Saur0o0n/PIDKiln/README.md

# pidkiln
PIDKiln is PID temperature controller, for any task involving high temperatures - like burning ceramic, glass fusing, soft metal melting, burning lost wax casting forms - and probably much more.

## Key features:
- Interface accessible both from LCD screen and WWW Webpage
- Unlimited (limited only by storage) temperature programs number, program file size limited to 10KiB (but this is artificial limit - can be extended)
- Internal ESP SPIFFS storage for programs, data, logs, configuration (perhaps later SD - but I'm not sure yet)
- Local preferences on disk, editable with Web interface
- Online monitoring, program management, editing, graphs and kiln control
- Build in clock synchronised with NTP servers (if Internet connected)
- Safety features build in (temperature run out protection, probe failure, SSR failure, kiln insulation failure)
- Online PIDKiln firmware upgrade with web interface
- Syslog type, over the network (UDP) logging to remote server
- ...simply cool and cheap (comparing to commercially available products) all in one solution

### Sample LCD screens
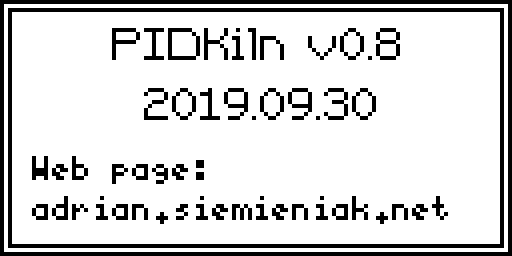
[picture p1: Documentation/images/PIDKiln_LCD_sample2.png]
LCD menu sample

### Sample Web interface window
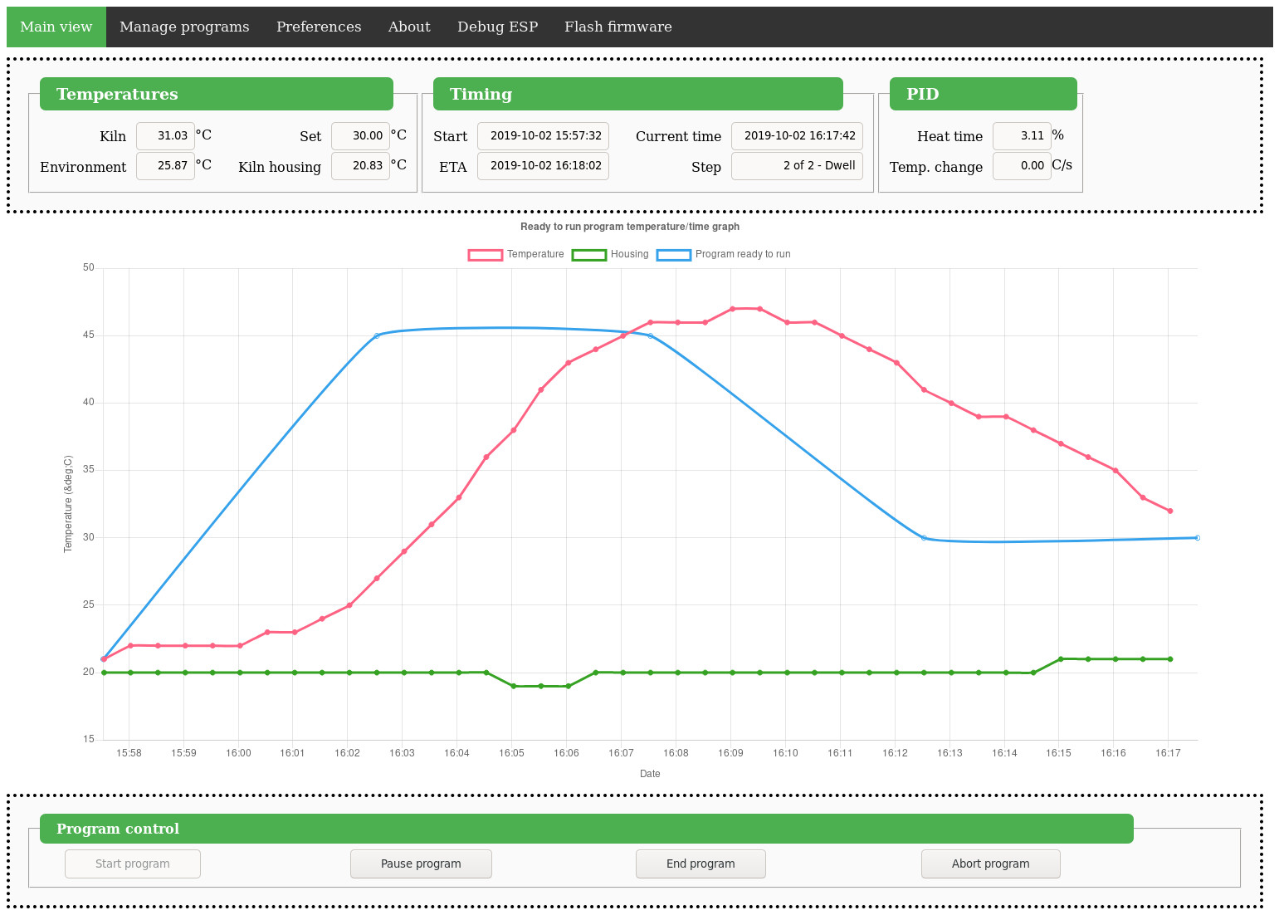
[picture p2: Documentation/images/PIDKiln-web-chart.jpg]
Web interface


## Required components:
- ESP32-Wrover board (I've used TTGO with MicroSD)
- MAX31855 breakout board
- K-type thermocouple
- DC->AC solid state relay

Kind of optional, but recommended:
- 128x65 dot matrix LCD 12864B v2
- Rotary encoder with button

Optional:
- DC/AC secondary relay - like SLA-05VDC-SL-C (240V/30A) mechanical relay
- Additional MAX31855 board with K-type thermocouple for housing temperature measuring
- Coil power meter - 30A/1V. This is contact less power meter that generates small current when energy flows inside it's coil. Mine already had burden resistor - so on output it produces -1V to 1V, proportionally it's coil rated for 30A. We just need to measure it to know how much juice flows to the heater.
- Perhaps a kiln :)

## BOM and expenses

Total expenses for this set should be around 30-40$
- ESP32-Wrover board: 11-14$ if exactly like mine, but other ESP32-Wrover you can bought for 6$+
- MAX31855 board: ~2$
- K-type thermocouple: 1$-10$ - depending on max temperature it can withstand
- LCD 12864B: ~5$
- Encoder: 1$
- SSR: 4$ + 4$ for radiator
- 2x10nF capacitors (at least 10nF - with higher capacitance you will have bigger hysteresis, but this actually may be favorable - for now I use 100nF on both MAX31855)

- Mechanical relay EMR SLA-05VDC-SL-C (Songle): 3$

## Why this configuration?

I've already used "kind of" controller made on Linux server and cron procedures, and it was ok.. for a while. Then I bought cheap Chinese controller PC410, just to find out, it is missing most of required stuff (that original PC410 should have), and I already was accustom to be able to see everything over Internet.
So I've made few attempts with Arduino - it was fine, but since I need remote access - ESP will be much better choice. I've started to work on ESP8266, but being afraid that I will be lacking some GPIOs - I've moved to ESP32. And since price difference is negligible, this is the platform of choice for this project.
It is also beneficial, because it has build in flash memory, that I can use for all required data - without need of connecting additional SD cards. Since I had ESP-Wrover (not ESP32-Wroom), I've also utilised it's PSRAM, but since PIDKiln 1.2 you can also use Wroom module (see Wiki).

MAX31855 comparing to more available MAX6675, is better choice since it allow us to work up to 1350C and it has 3,3V logic.

LC12864B is perhaps not the best choice, but I simply had this one already (I've used if before for my 3D printer). Perhaps later I'll change it. Problem with this LCD is that it has 5V logic. Sometimes it works on 3,3V (depending on version), in my case it does. But since it's one way communication (only MISO) hooking it up to 5V for both logic and back light works and does not crash my board. Clean solution would be to use logic voltage translator (there is plenty of them for 1$).

Relays - Main relay is SSR (Solid State Relay) type. It's because we need to switch it fast and often - SSR can do it, but it will get hot, so make sure you have good radiator. Also if you are going to use cheap Chinese knock offs, make sure it's rated twice the output current of your heater(s).
All relays may fail, and they may fail in closed (conductive) state. Because of it, I've also implemented second stage EMR (Electromechanical Relay) relay in case of SSR failure. It's mechanical, so it won't get hot too much. This will allow to turn off the kiln, in case of SSR failure, with EMR (and other way around too). This additional relay (SLA-05VDC-SL-C) is optional.

Initially for kiln housing temperature readout I wanted to use thermistors, but since I've already had MAX31855 connected (and it costs 2$), using additional one requires only 1 new GPIO on ESP. Without hassle to provide reference voltage etc. Low temperature thermocouples are also darn cheap.

## GPIO/PINs connection

**LCD**

Connected to one of three SPI on ESP32 - called VSPI (MOSI-23, MISO-19, CLK-18, CS-5)

ESP32	| LCD
--------|---------
+3.3V	| BLA (this can be also +5V if you wish)
GND	| BLK
4	| RST
GND	| PSB
+5V	| VCC (This should be - for ESP sake - 3,3V, but my LCD doesn't work with lower voltage. Try first with 3,3V)
GND	| GND
5	| RS
18	| E
23	| R/W

**Encoder**

ESP32	| Encoder
--------|---------
+3.3V	| 5V/VCC
GND	| GND
32	| Key
34	| S2
35	| S1

**MAX31855**

Connected to one of three SPI on ESP32 - called HSPI (MOSI-13, MISO-12, CLK-14) CS-27/15
Add 10nF capacitor to thermocouple input pins - it's a must to have reliable readout.

EPS32	| MAX31855 A
--------|---------
+3.3V	| VCC
GND	| GND
12	| SO/DO (slave output/data output)
14	| SCK (clock)
27	| CS (chip select)

EPS32	| MAX31855 B
--------|---------
+3.3V	| VCC
GND	| GND
12	| SO/DO (slave output/data output)
14	| SCK (clock)
15	| CS (chip select)

**Relays**

ESP32	| SSR
--------|-------
GND	| GND
19**    | IN

ESP32   | EMR (SLA-05VDC-SL-C)
--------|----------------
GND     | GND
21      | IN
5-48V*  | VCC

(*) Do not connect 5V from ESP - use external source. This can be any 5V-48V power supply with around 1W power.

(**) For additional SSR relay (works simultaneously with first one) use PIN 22 - see documentation for explanation

**Power meter**

See the documentation for detailed instruction.

ESP   | 30A/1V
------|--------
3,3V  | 3,3V
GND   | GND
33    | most outside mini jack connector

**Alarm**

This ALARM_PIN goes HIGH when program ABORT is called (somethings wrong, or user triggered). You can connect this pin to buzzer or small relay to trigger some other action on failure.

ESP   | Relay/Buzzer
------|-------------
GND   | GND
26    | +3,3V

**Minimal configuration of PIDKiln**

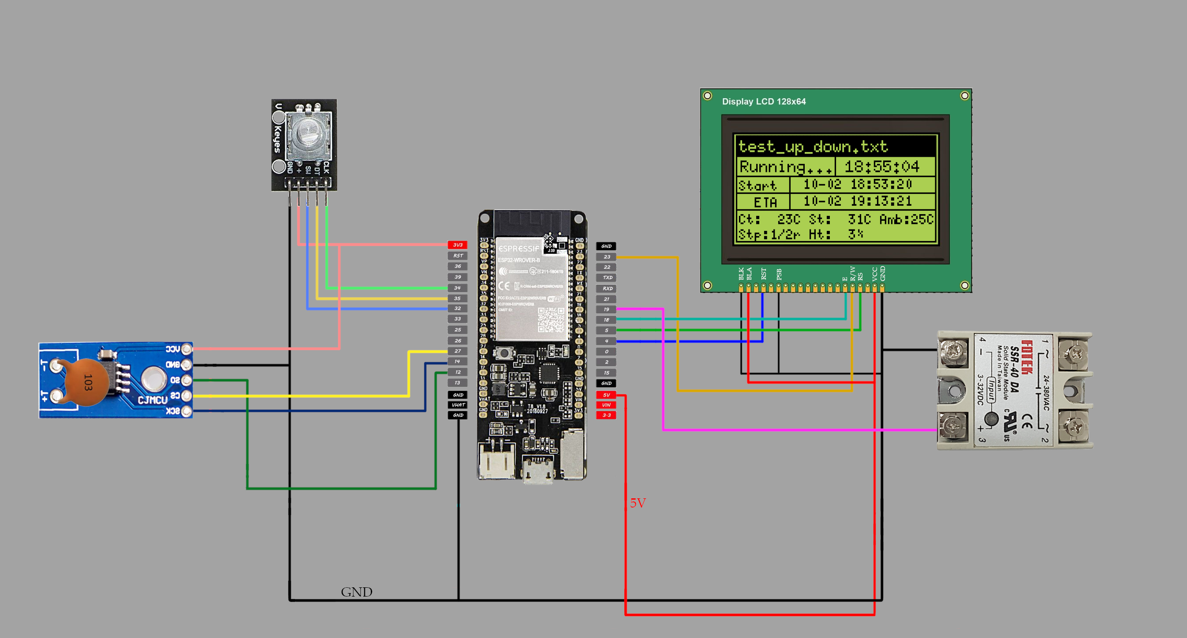
[picture p3: Documentation/PIDKiln_Wiring-min.png]
PIDkiln minimal wiring


**Standard configuration of PIDKiln**

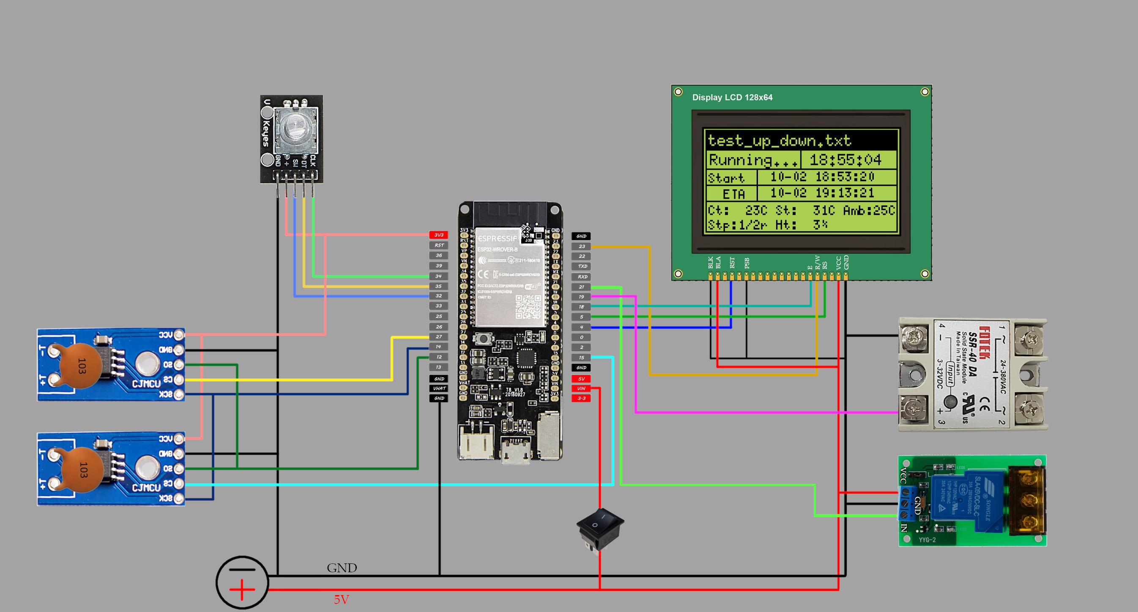
[picture p4: Documentation/PIDKiln_Wiring.png]
PIDkiln wiring


## Power consideration

Preferably you should power your PIDKiln device with regulated 5V. This way you can power ESP32 board through VIN (do not use VIN and USB at once!) pin and use 5V to directly power EMR relay (around 185mA) and LCD backlight (depends of brightness).
You could power board with just USB, but 5V output from my board (ESP32-Wrover TTGO with microsd) is too weak to handle EMR and LCD and most of other boards even do not have 5V out. You could also use VIN as 5V Vout (this pin should be connected directly to USB 5V output) - but then you are limited by USB output and how much board traces can handle.

## Installation

This is short version - for detailed one, please see [Wiki documentation](https://github.com/Saur0o0n/pidkiln/wiki/Hardware-assembly)

- Assembly hardware, as specified above.
- Clone git into the Arduino user programs directory (on Linux "/home/username/Arduino/").
- You have to already have installed ESP32 framework (PIDKiln <v1.2 requires ESP32 <2.0.x, PIDKiln v1.2+ requires ESP32 2.0.x and PIDKiln v1.5+ ESP32 3.x) - if don't, do it now (https://github.com/espressif/arduino-esp32/blob/master/docs/arduino-ide/boards_manager.md).
- Don't forget about ESP32FS plugin (drop it to "/home/username/Arduino/tools")
- Install required additional libraries (not all can be installed from Arduino IDE Library Manager): [ESPAsyncWebServer](https://github.com/me-no-dev/ESPAsyncWebServer), [AsyncTCP](https://github.com/me-no-dev/AsyncTCP), [PID Library](https://github.com/br3ttb/Arduino-PID-Library/), [u8g2](https://github.com/olikraus/u8g2) and perhaps [emon](https://github.com/openenergymonitor/EmonLib) if you plan to use power meter. Since PIDKiln 1.1 you also need [Syslog](https://github.com/arcao/Syslog) library.
- Install also (this has changed in PIDKiln v1.1) [my clone of MAX31855](https://github.com/Saur0o0n/MAX31855) - this implements second HW SPI for ESP32.
- Update (there is no other way to do it) libraries/ESPAsyncWebServer/src/WebResponseImpl.h variable TEMPLATE_PLACEHOLDER to '~'.
- For production use, disable serial debug in PIDKiln.ino - set it on false (''#define DEBUG false'')
- Compile and upload.
- Open data/etc/pidkiln.conf and edit your WiFi credentials (if you want to use) and, if you want, some additional parameters.
- Upload sketch data (from data directory) to ESP32 SPIFFS with help of ESP32FS plugin (in Arduino IDE go to Menu->Tools->ESP32 Sketch Data Upload).

## Documentation

- Most of the documentation you can find on [PIDKiln github page](https://github.com/Saur0o0n/pidkiln/wiki) - so please use it
- Some less formal updates information and step by step instructions will be on [my webpage](https://adrian.siemieniak.net/portal/tag/PIDKiln/)

## Some future ideas

Almost all, what I had in mind is done.. so not much to write here :)
Perhaps...
- RTC clock for better timing and no Internet installations
- MQTT reporting
- HomeAssistant integration
