Saur0o0n/PIDKiln/Documentation/images/Arduino_configuration.jpg

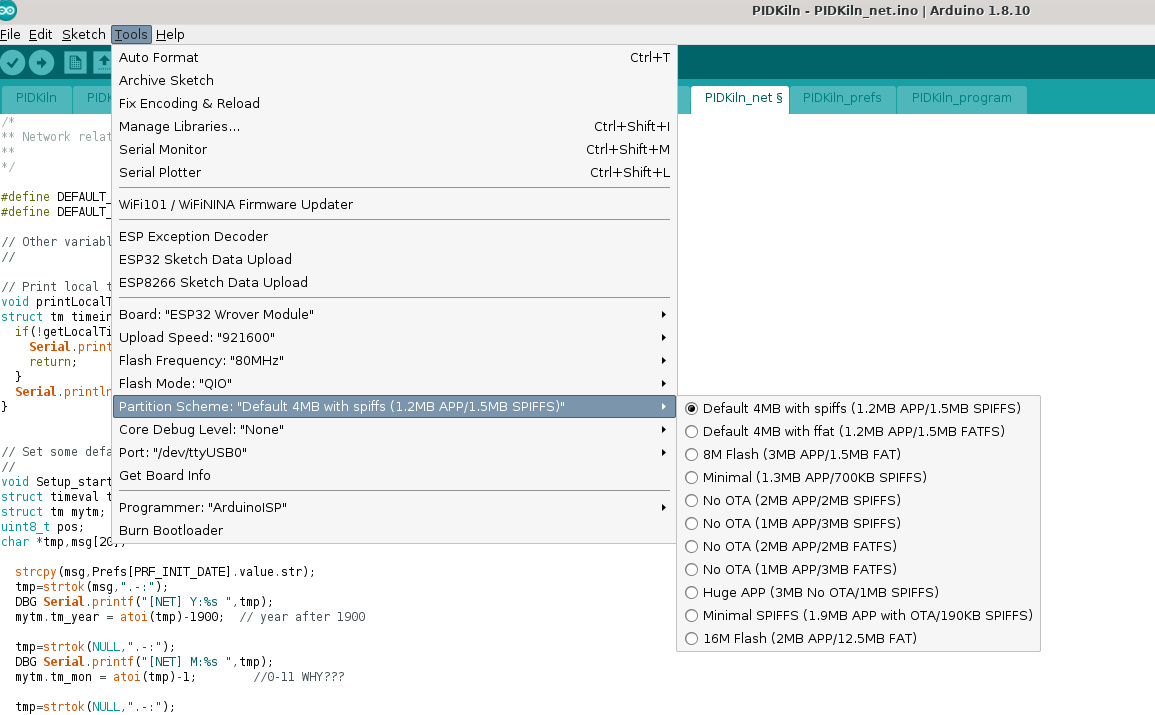
Documentation/images/Arduino_configuration.jpg
