Saur0o0n/PIDKiln/Documentation/images/LCD_sample01.jpg

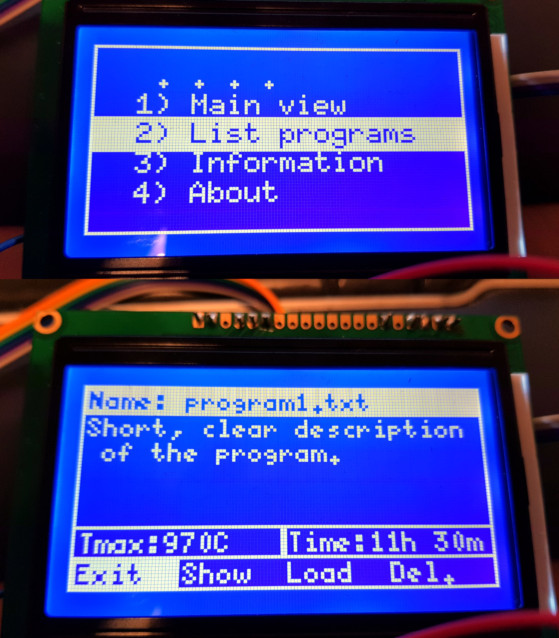
Documentation/images/LCD_sample01.jpg
