Saur0o0n/PIDKiln/Documentation/images/PIDKiln_LCD_MainView1.png

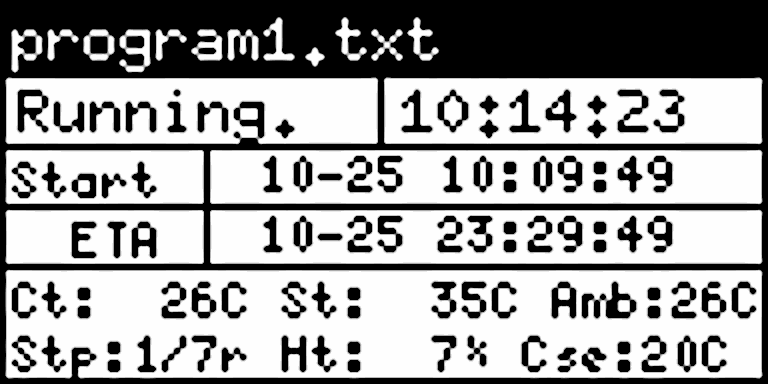
Documentation/images/PIDKiln_LCD_MainView1.png
