Saur0o0n/PIDKiln/Documentation/images/PIDKiln_LCD_sample.png

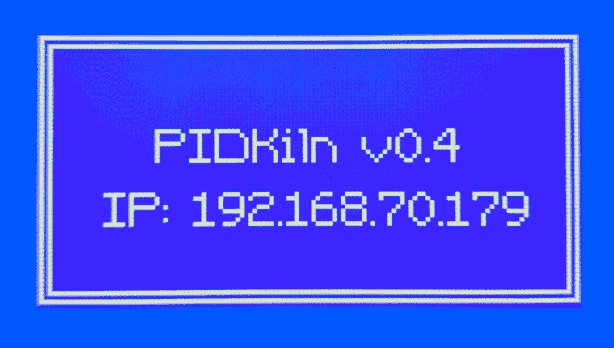
Documentation/images/PIDKiln_LCD_sample.png
