Saur0o0n/PIDKiln/Documentation/images/PIDKiln_on_Breadboard.jpg

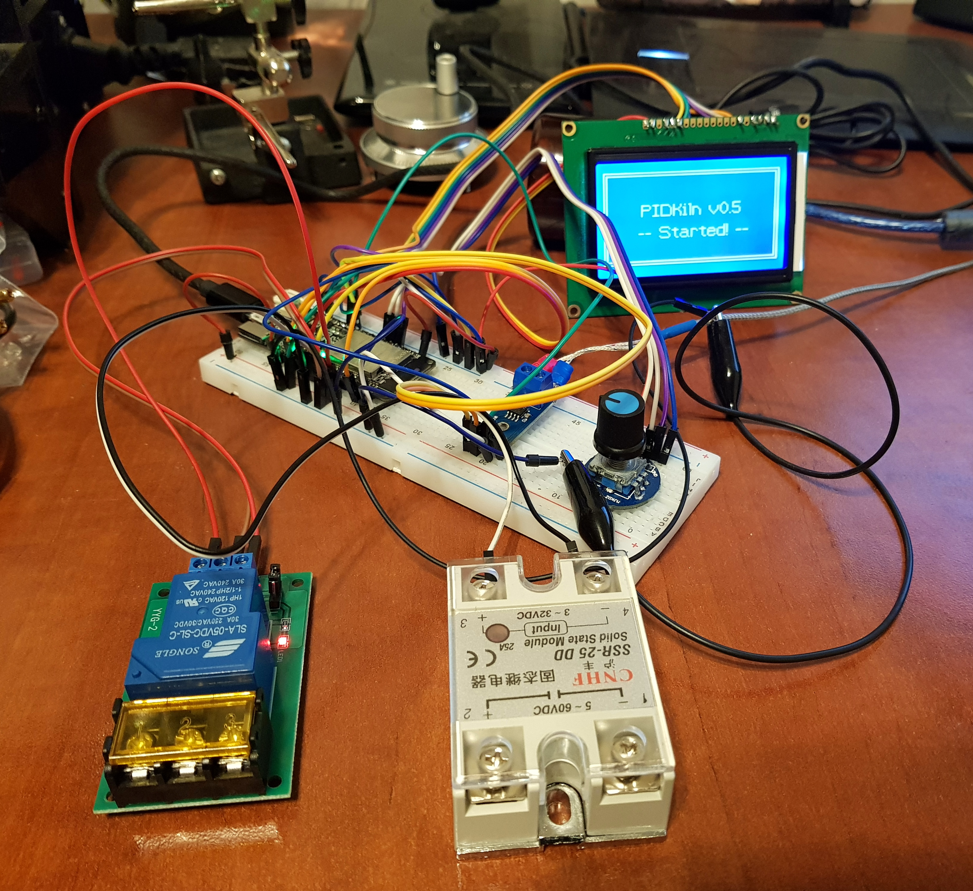
Documentation/images/PIDKiln_on_Breadboard.jpg
