Saur0o0n/PIDKiln/Documentation/images/PowerMeter.png

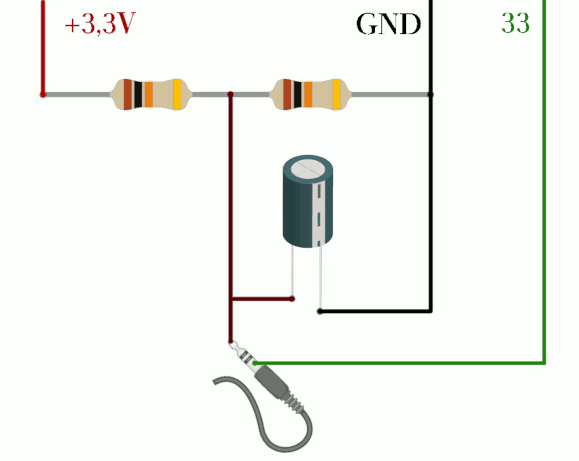
Documentation/images/PowerMeter.png
