Saur0o0n/PIDKiln/Documentation/pid/PIDKiln_pom_1_10,0,0.png

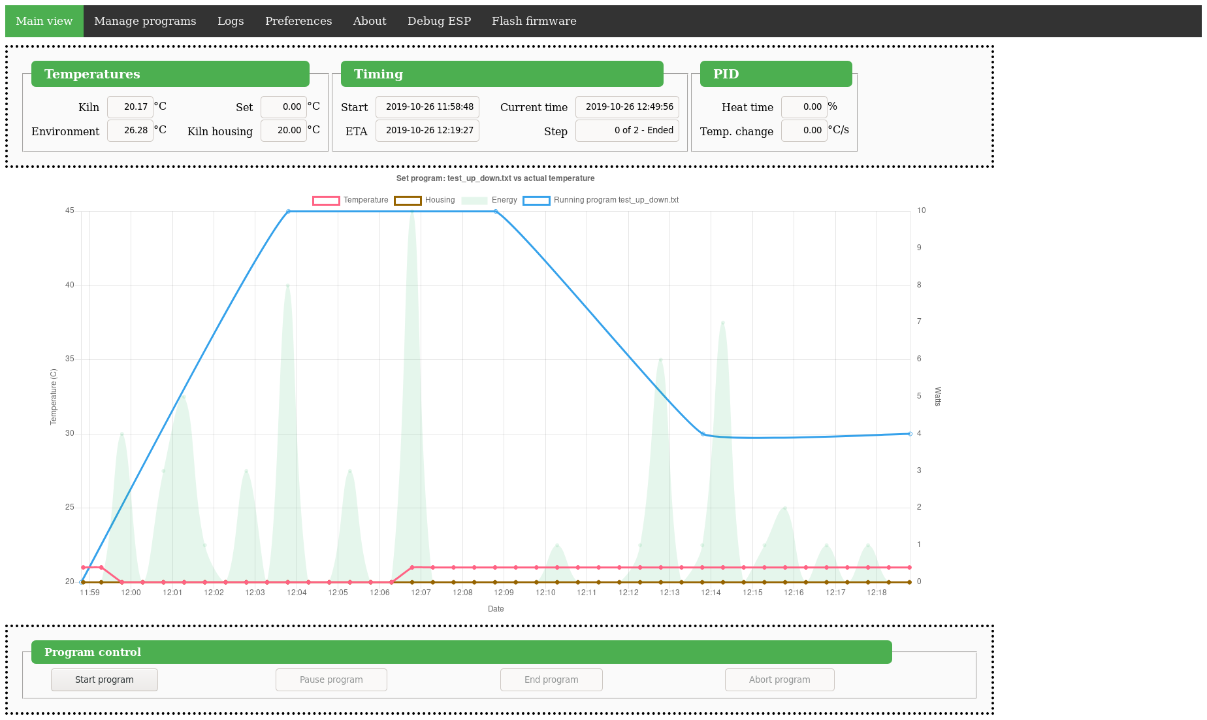
Documentation/pid/PIDKiln_pom_1_10,0,0.png
