Saur0o0n/PIDKiln/Documentation/pid/PIDKiln_pom_1_10,0.2,0.1.png

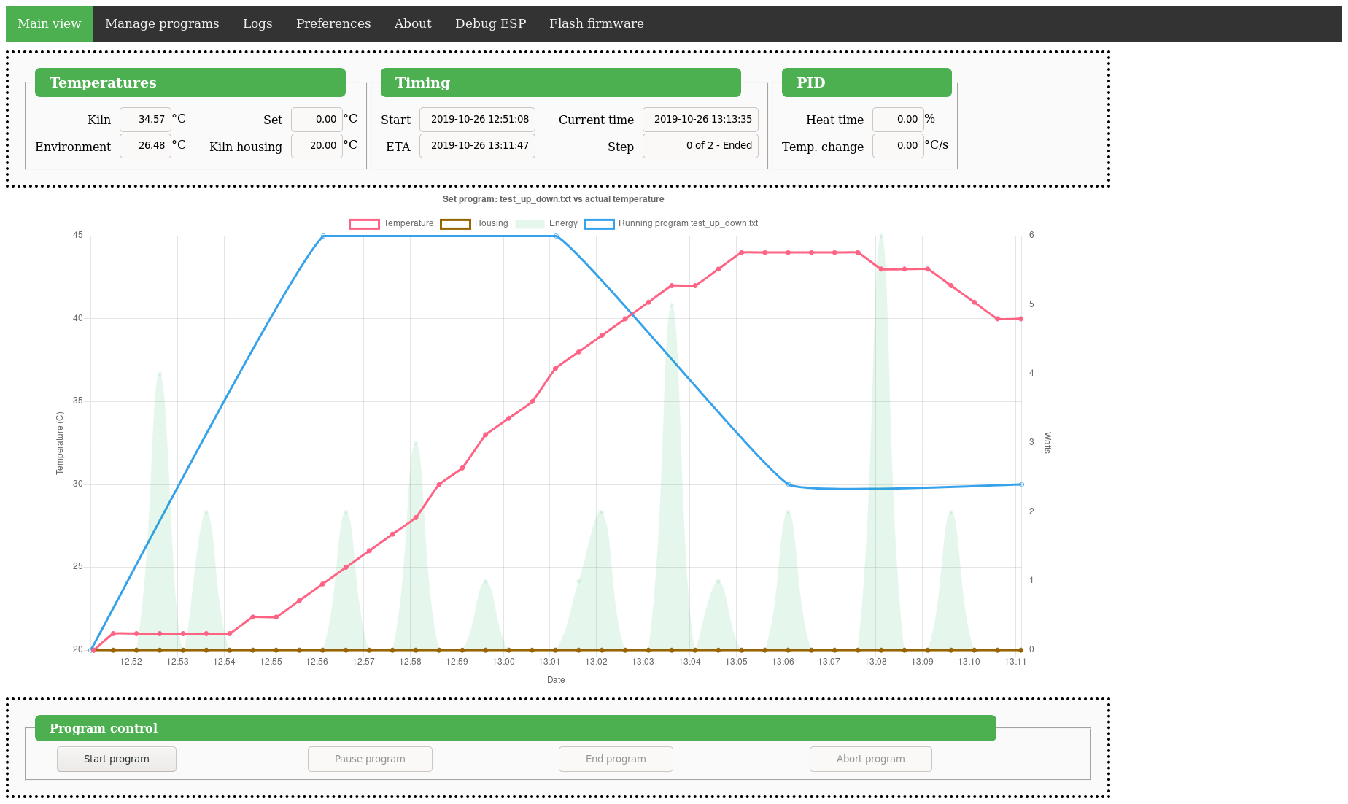
Documentation/pid/PIDKiln_pom_1_10,0.2,0.1.png
