Saur0o0n/PIDKiln/Documentation/pid/PIDKiln_pom_1_10,0.5,0.5.png

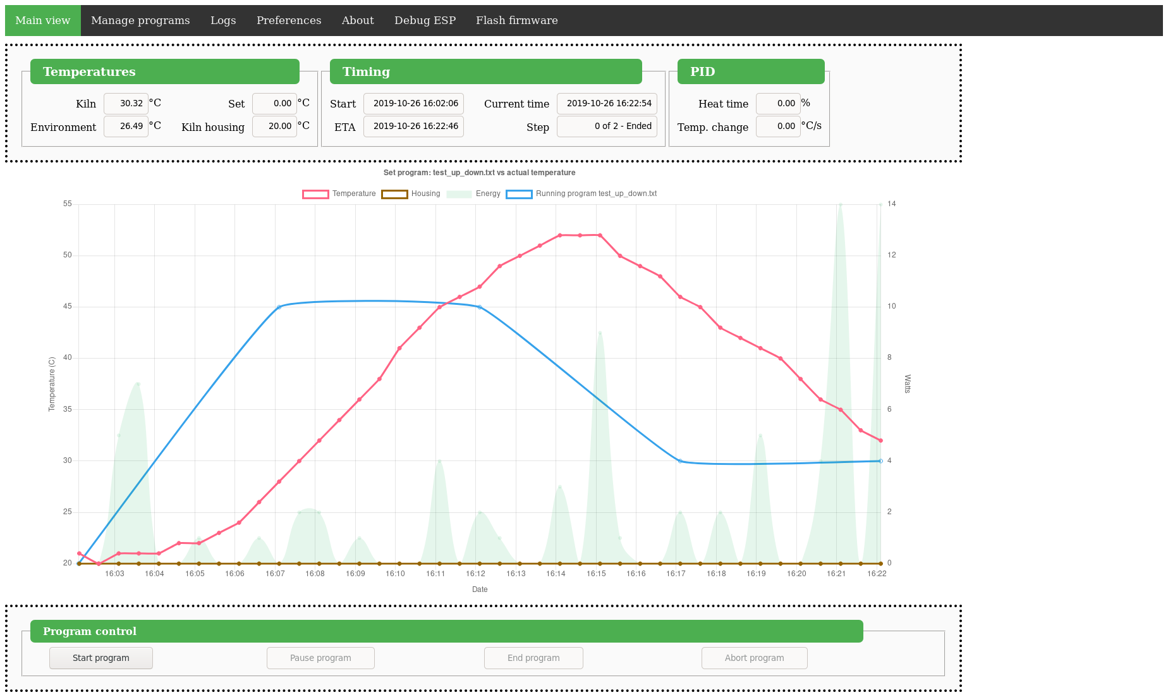
Documentation/pid/PIDKiln_pom_1_10,0.5,0.5.png
