Saur0o0n/PIDKiln/Documentation/pid/PIDKiln_pom_1_20,0.6,0,5.png

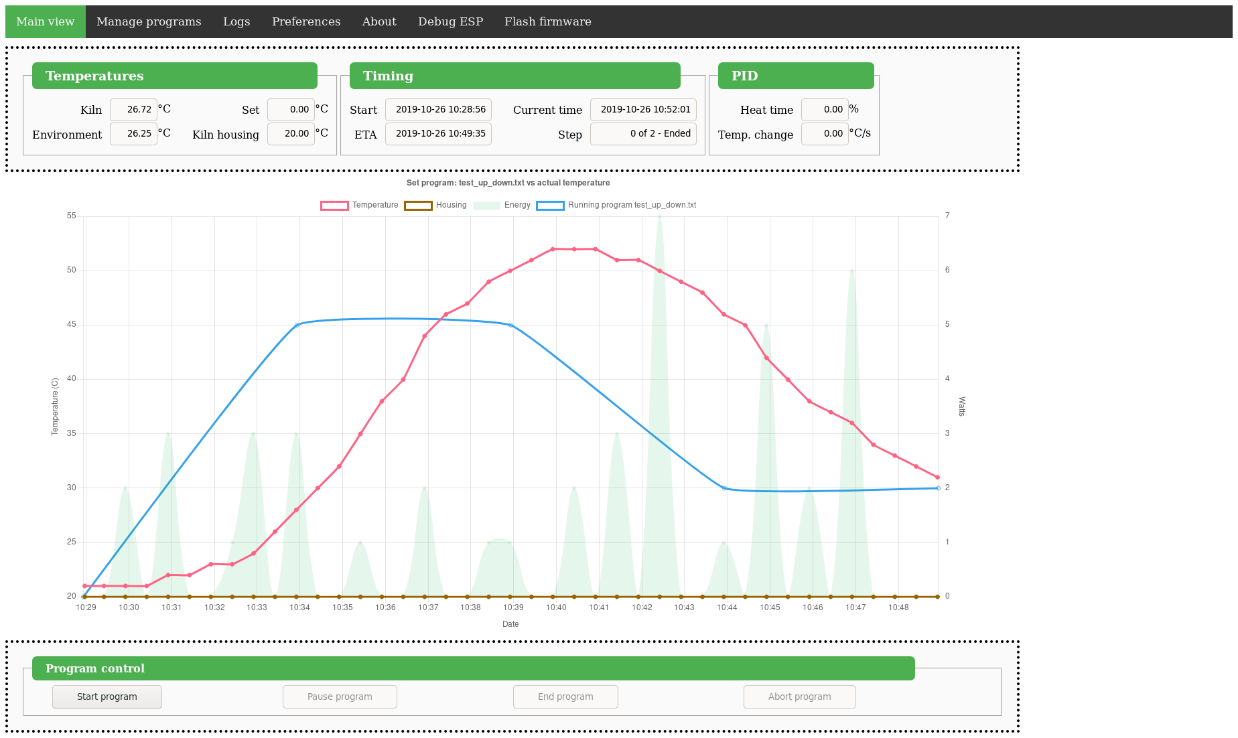
Documentation/pid/PIDKiln_pom_1_20,0.6,0,5.png
