Saur0o0n/PIDKiln/Documentation/pid/PIDKiln_pom_1_20,5,0.1.png

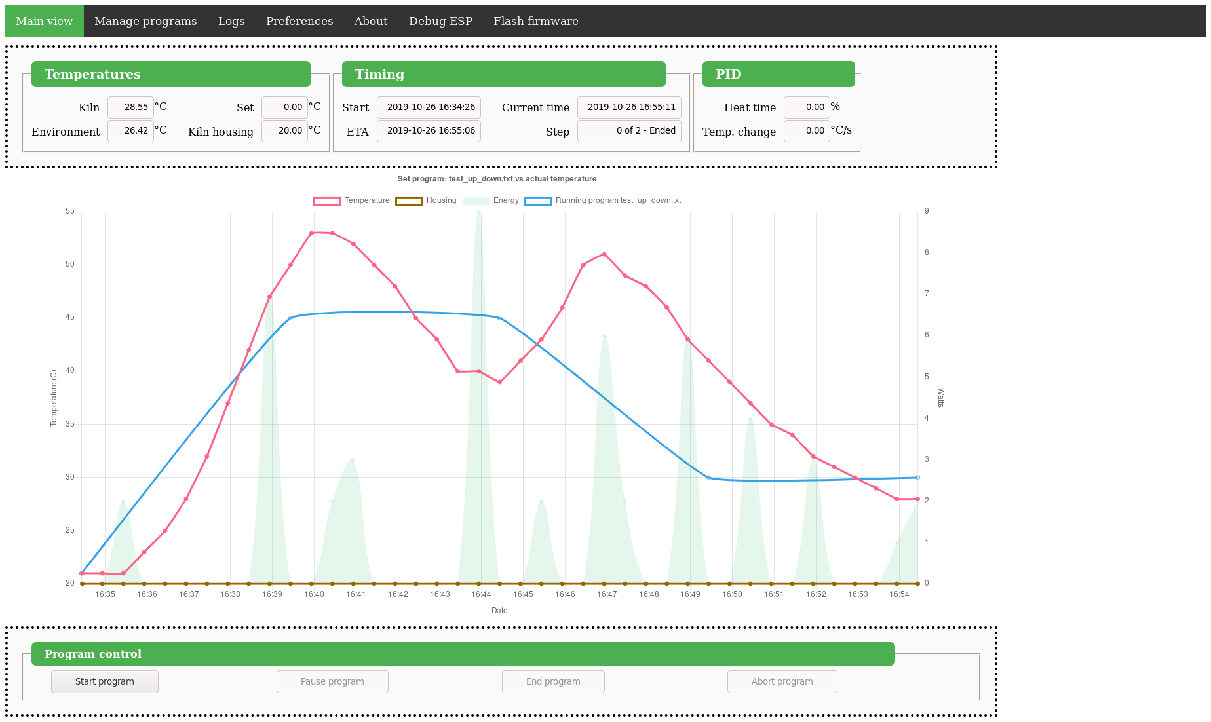
Documentation/pid/PIDKiln_pom_1_20,5,0.1.png
