Saur0o0n/PIDKiln/Documentation/TTGO-ESP32-WROVER-Board1-pinout.jpg

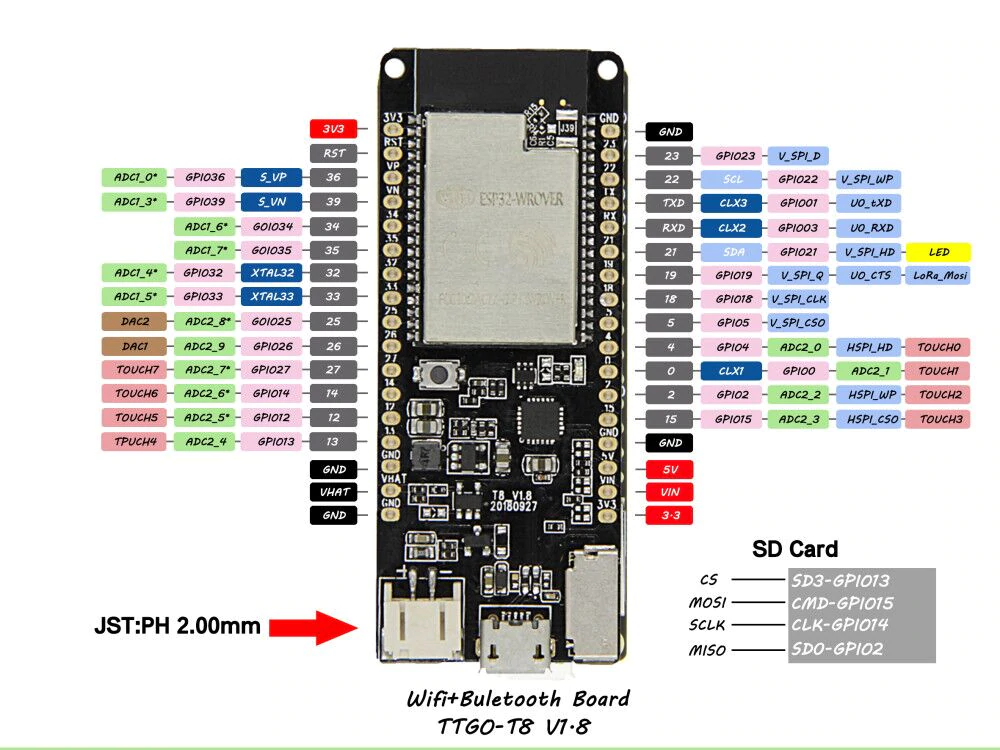
Documentation/TTGO-ESP32-WROVER-Board1-pinout.jpg
