Saur0o0n/PIDKiln/Documentation/components/Current-sensor.jpg

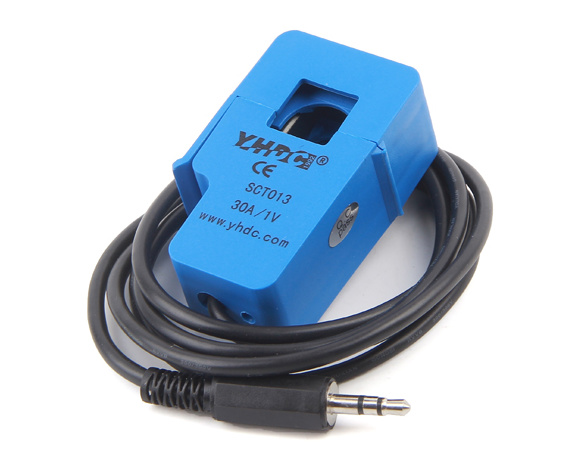
Documentation/components/Current-sensor.jpg
