Saur0o0n/PIDKiln/Documentation/components/LCD_12864b.jpg

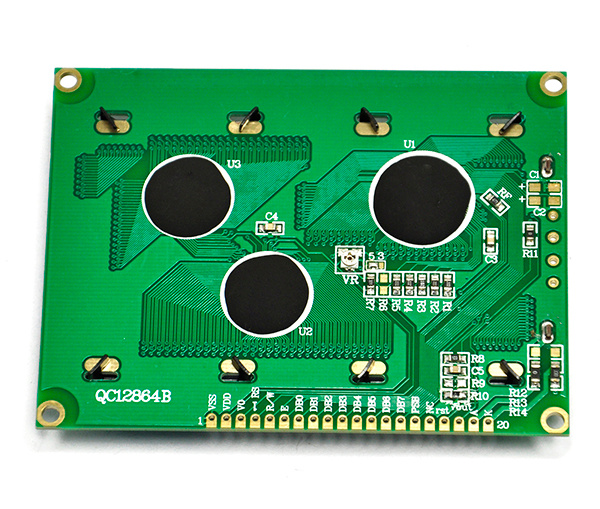
Documentation/components/LCD_12864b.jpg
