Saur0o0n/PIDKiln/Documentation/components/MAX31855.jpg

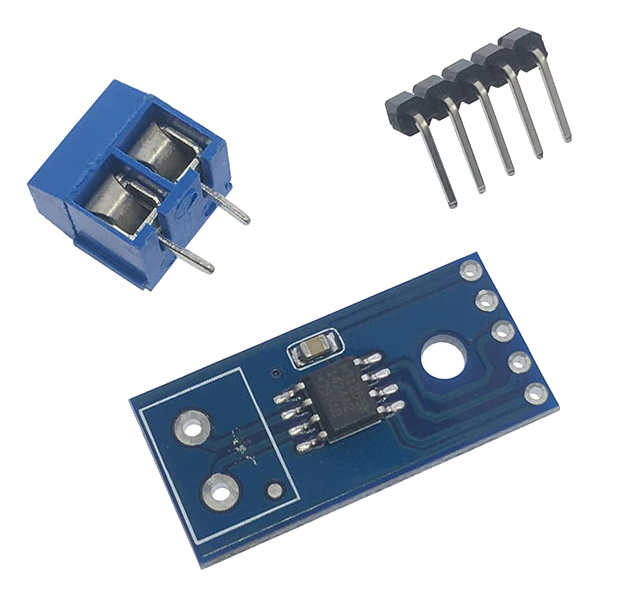
Documentation/components/MAX31855.jpg
