Saur0o0n/PIDKiln/Documentation/components/RotaryEncoder.jpg

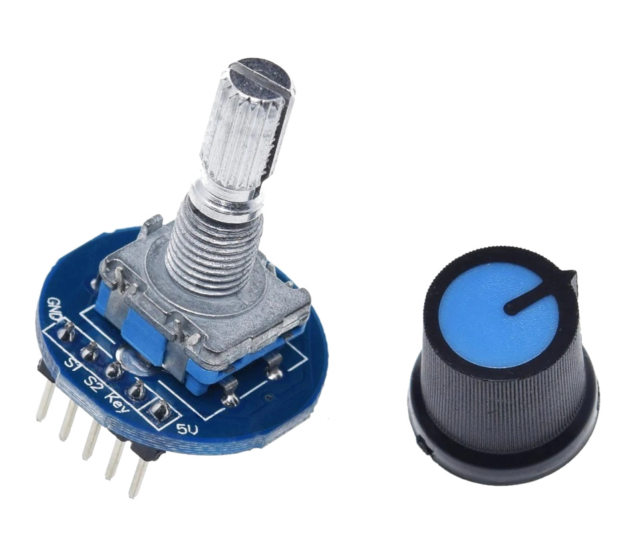
Documentation/components/RotaryEncoder.jpg
