Saur0o0n/PIDKiln/Documentation/components/SLA-05VDC-SL-C.jpg

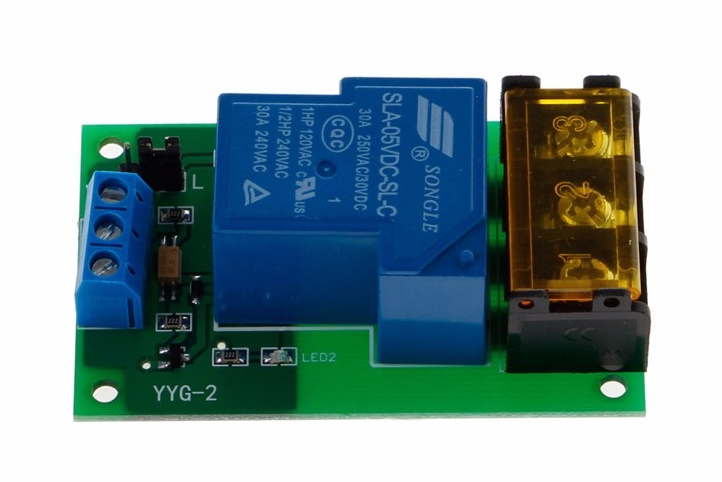
Documentation/components/SLA-05VDC-SL-C.jpg
