Saur0o0n/PIDKiln/Documentation/components/SSR-40a.jpg

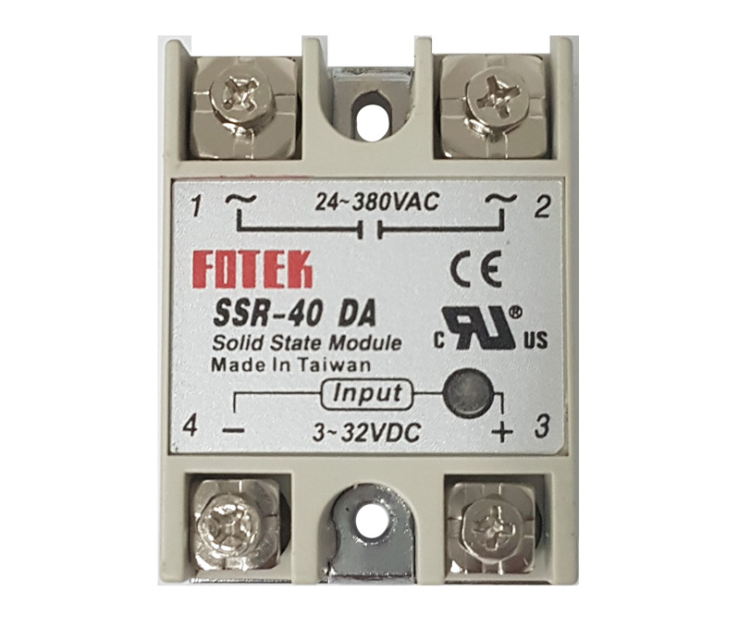
Documentation/components/SSR-40a.jpg
