Saur0o0n/PIDKiln/Documentation/components/TTGO-ESP32-WROVER-Board1.jpg

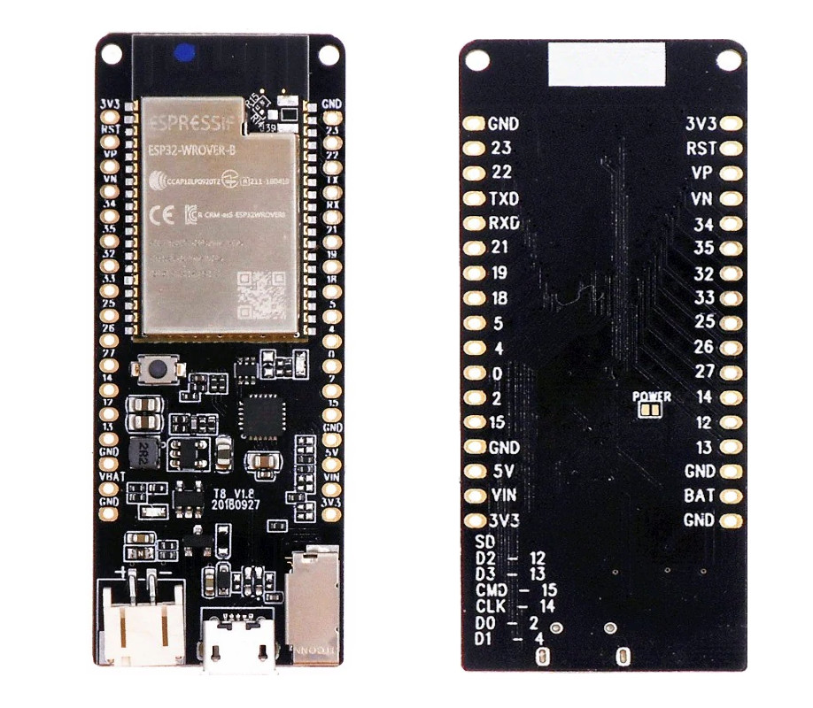
Documentation/components/TTGO-ESP32-WROVER-Board1.jpg
