Saur0o0n/PIDKiln/Documentation/pid/PID_Testing_Results.ods

Lp. | Program | PoM_1_10;0,2;0,1 | PoM_1_10;0;0 | PoM_1_20;0,6;0,1 | PoM_1_20;0,6;0,5 | PoM_10_20;0,2;01 | PoM_1_20;0,2;0,1 | PoM_1_5;0,2;0,1 | PoM_1_10;0.5;0,5 | PoM_1_20;5;0,1 | PoM_1_20;5;2 | PoM_1_20,2,2 | PoM_1_99;10;99
1 | 20 | 20 | 21 | 21 | 21 | 22 | 20 | 22 | 21 | 21 | 25 | 24 | 24
2 |  | 21 | 21 | 21 | 21 | 23 | 19 | 21 | 20 | 21 | 25 | 24 | 24
3 |  | 21 | 20 | 21 | 21 | 23 | 20 | 21 | 21 | 21 | 25 | 24 | 25
4 |  | 21 | 20 | 21 | 21 | 23 | 20 | 21 | 21 | 23 | 26 | 25 | 27
5 |  | 21 | 20 | 22 | 22 | 24 | 21 | 21 | 21 | 25 | 28 | 26 | 30
6 |  | 21 | 20 | 22 | 22 | 25 | 21 | 22 | 22 | 28 | 30 | 27 | 35
7 |  | 21 | 20 | 23 | 23 | 26 | 21 | 22 | 22 | 32 | 34 | 29 | 39
8 |  | 22 | 20 | 24 | 23 | 28 | 21 | 22 | 23 | 37 | 38 | 32 | 43
9 |  | 22 | 20 | 25 | 24 | 30 | 22 | 23 | 24 | 42 | 43 | 35 | 45
10 |  | 23 | 20 | 27 | 26 | 32 | 23 | 24 | 26 | 47 | 47 | 38 | 44
11 | 45 | 24 | 20 | 28 | 28 | 34 | 24 | 24 | 28 | 50 | 50 | 42 | 43
12 |  | 25 | 20 | 31 | 30 | 37 | 24 | 24 | 30 | 53 | 52 | 46 | 42
13 |  | 26 | 20 | 33 | 32 | 39 | 26 | 25 | 32 | 53 | 53 | 49 | 42
14 |  | 27 | 20 | 36 | 35 | 42 | 27 | 26 | 34 | 52 | 52 | 52 | 44
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
