Saur0o0n/PIDKiln/Documentation/images/HalogenBulbTests.jpg

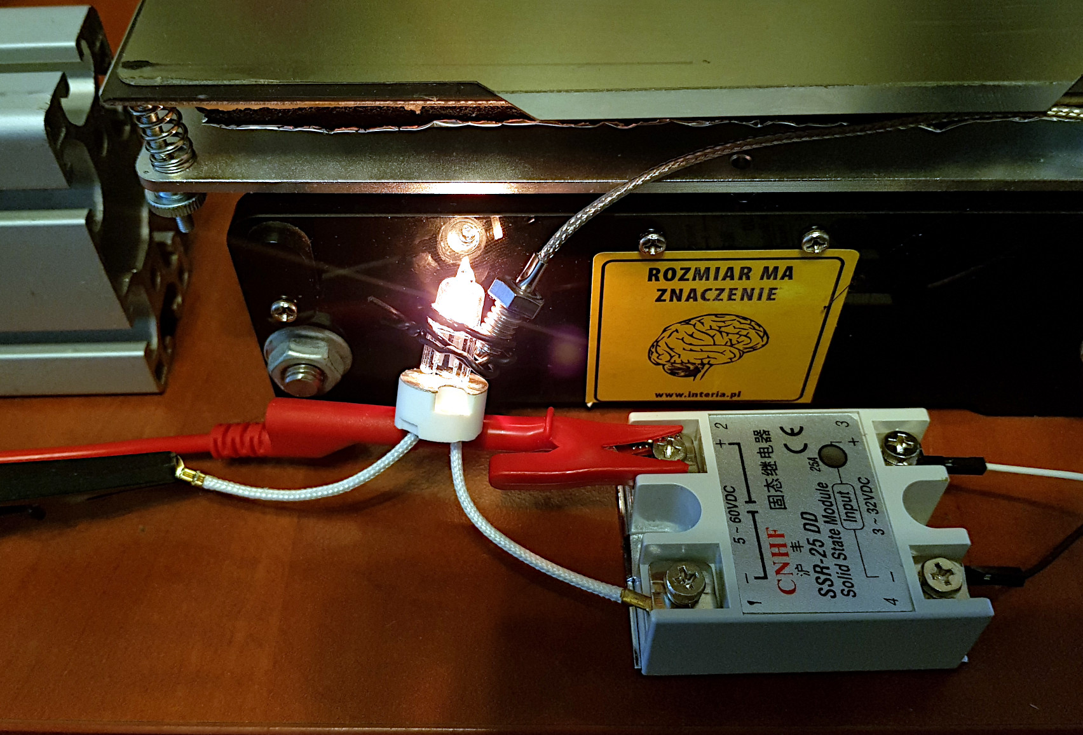
Documentation/images/HalogenBulbTests.jpg
