Saur0o0n/PIDKiln/Documentation/pid/PID_Testing_Results.png

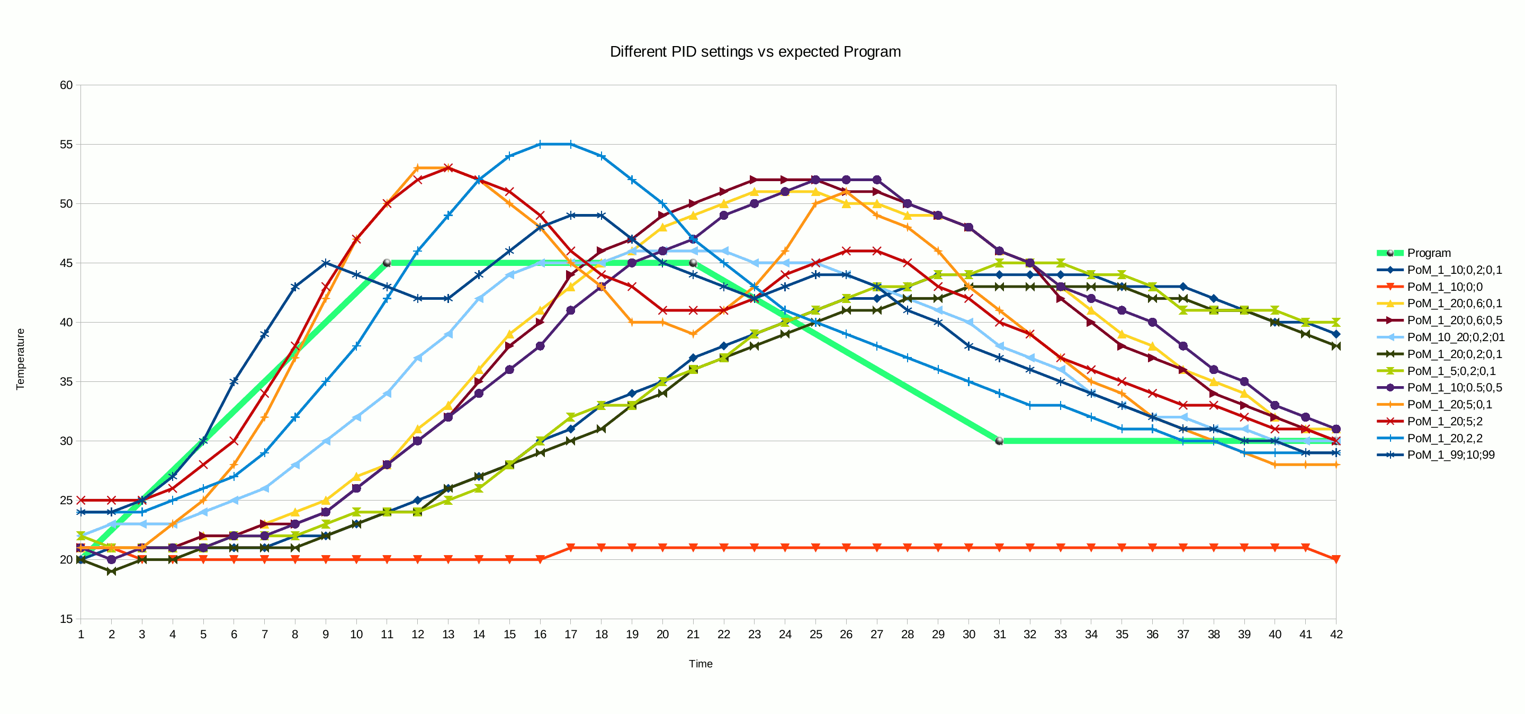
Documentation/pid/PID_Testing_Results.png
