Saur0o0n/PIDKiln/(threads)

Thread 1 (2019-10-18):

LCD and SSR questions

rocketbob, 2019-10-18:
Thanks for putting this nice project up on github!

Question: as I understand the maximum gate current on an IO pin on the ESP32 is 12mA.  Is that enough to drive the SSR?  In my case I have two heating elements in my kiln and will have to drive them from separate pins because I don't think the ESP can source enough current to drive both from one pin.

Saur0o0n, 2019-10-20:
As I understand, fully safe current from IO pin is 12mA, but it can get higher as 50mA - this is just to make this information fully true.
I also have two heating elements, but I control them with single 40A SSR, like you can see it here:
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 - more [here](https://adrian.siemieniak.net/portal/pidkiln-0-9-still-second-update/).
But if you would need two separate SSR - it's going to be extremely easy to do - just let me know.

Saur0o0n, 2019-10-21:
Ok, so I've tested mine SSR and it draws max 8,73mA (at least this is how much my multimeter can measure in MAX mode - I don't know it's frequency). I've looked also at some different specs for Fotek SSRs - and some says MAX 12mA, some says 7mA at 12V, and also I definitely don't have original Fotek :).
So long story short - one SSR is safe, two SSRs well.. should be safe, but better is to:

- drive two(more) heaters with single SSR (if it's in range of SSR specs - for Chinese 2x the specs ;) ).
- add an transistor (like 2N3904) and resistor (330R / 330 Ohm should limit current to 10mA) to drive two(more) SSRs
- use additional GPIO for another SSR (I'll add it)

Saur0o0n, 2019-10-22:
I have another idea - quite easy to implement :). You could use logic level converter module like [this](https://www.aliexpress.com/item/32916020205.html?spm=a2g0s.9042311.0.0.27424c4dfihkjk).
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

This way you can have up to 8 SSRs - driven with single GPIO (with this chip/board). Just connect one side VA to 3,3V and ESP32 pin 19 to all A0-A8 gates. Then on the other side connect +5V to VB and B0-B8 pins to SSRs you have. This chip can (according to specs) provide up to 50mA of current on single pin.

Thread 2 (2020-04-14):

SPI error

Adrian8x, 2020-04-14:
Hi,

Do you have any idea why I get this error?

C:\PIDKiln\PIDKiln_addons.ino: In function 'void Setup_Addons()':

PIDKiln_addons:233:32: error: no matching function for call to 'MAX31855::begin(SPIClass*&)'

   ThermocoupleA.begin(ESP32_SPI);
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

Saur0o0n, 2020-04-14:
Hi,

Did you clone MAX31855 library from my repo? It looks like it's from original branch - without multiple SPI feature.

Adrian8x, 2020-04-14:
Sorry, For the beginning I used original branch. Now I get your library and the sketch is compiled successfully.

Thank you for your help and for this great library!

Adrian8x, 2020-04-14:
23:04:08.828 -> WiFi mode: 1, Retry count: 9, is wifi enabled: 4
23:04:08.874 -> [NET] Y:2020 [NET] M:03 [NET] D:20 [NET] H:11 [NET] m:00 [NET] s:00
23:04:08.968 -> [NET] Creating WiFi Access Point (AP)192.168.4.1
23:04:09.109 -> [PRG] Loading directory...
23:04:09.156 -> [PRG]	counted 6 files
23:04:09.249 -> Guru Meditation Error: Core  1 panic'ed (StoreProhibited). Exception was unhandled.
23:04:09.249 -> Core 1 register dump:
23:04:09.249 -> PC      : 0x400013df  PS      : 0x00060830  A0      : 0x800d97f1  A1      : 0x3ffb1cb0
23:04:09.249 -> A2      : 0x00000000  A3      : 0x3ffb1d56  A4      : 0x000000ff  A5      : 0x0000ff00
23:04:09.249 -> A6      : 0x00ff0000  A7      : 0xff000000  A8      : 0x00000070  A9      : 0x00000069
23:04:09.249 -> A10     : 0x00000000  A11     : 0x00000000  A12     : 0x7840332b  A13     : 0x3ffc2588
23:04:09.249 -> A14     : 0x00000001  A15     : 0x3f4058f3  SAR     : 0x00000008  EXCCAUSE: 0x0000001d
23:04:09.296 -> EXCVADDR: 0x00000000  LBEG    : 0x400014fd  LEND    : 0x4000150d  LCOUNT  : 0xfffffffa
23:04:09.296 ->
23:04:09.296 -> Backtrace: 0x400013df:0x3ffb1cb0 0x400d97ee:0x3ffb1cc0 0x400d9a28:0x3ffb1d90 0x400da2dc:0x3ffb1f60 0x400eaa13:0x3ffb1fb0 0x4008909d:0x3ffb1fd0
23:04:09.296 ->
23:04:09.296 -> Rebooting...
23:04:09.296 -> ets Jun  8 2016 00:22:57
23:04:09.296 ->
23:04:09.296 -> rst:0xc (SW_CPU_RESET),boot:0x13 (SPI_FAST_FLASH_BOOT)
23:04:09.296 -> configsip: 0, SPIWP:0xee

This is the result :((

Saur0o0n, 2020-04-14:
It looks like there is some file indexing error - next step should be like this
```[NET] Y:2020 [NET] M:02 [NET] D:20 [NET] H:11 [NET] m:00 [NET] s:00
[NET] Creating WiFi Access Point (AP)192.168.10.1
[PRG] Loading directory...
[PRG]	counted 7 files
[PRG] FName: program1.txt	 FSize:491	Sel:0
[PRG] FName: vfail1.txt	 FSize:246	Sel:0
[PRG] FName: test_up_down.txt	 FSize:270	Sel:0
```
You can decode this backtrace with Esp Exception Decoder (addon for Arduino IDE).
But I think there is something wrong with file uploaded to SPIFFS.

Adrian8x, 2020-04-14:
I get this message:

PC: 0x400013df
EXCVADDR: 0x00000000

Decoding stack results
0x400d95fe: Load_programs_dir() at C:\PIDKiln/PIDKiln_program.ino line 152
0x400d9838: Generate_INDEX() at C:\PIDKiln/PIDKiln_http.ino line 200
0x400da0ec: setup() at C:\PIDKiln/PIDKiln.ino line 154
0x400ea573: loopTask(void*) at C:\Users\Ellusia\AppData\Local\Arduino15\packages\esp32\hardware\esp32\1.0.4\cores\esp32\main.cpp line 14
0x40088cd1: vPortTaskWrapper at /home/runner/work/esp32-arduino-lib-builder/esp32-arduino-lib-builder/esp-idf/components/freertos/port.c line 143

Adrian8x, 2020-04-14:
I uploaded he sketch with OTA upload tool you provided and I get the same result. This is strange.

I don't understand why I have only 6 files uploaded and you have 7.

Saur0o0n, 2020-04-14:
There are 6 programs, but after first run it will generate index - so it's the seventh file, that you actually can't see as a program (it's html).
It fails on strcpy. Can you upload by OTA both program and spiffs? Perhaps there is something else in file naming on Windows (and file length) - I've been developing it on Linux.
What ESP do you have? It has to be wroover - if it's wroom - there is no psram.

Adrian8x, 2020-04-15:
I uploaded with OTA the Prog/SPIFFS and I have the same error.
I use ESP32-WROOM-32D. That's the problem if you use PSRAM.
There is a possibilities to work with wroom? Otherwise I will buy wrover.

Saur0o0n, 2020-04-15:
You would have to replace all the memory functions from ps_XX to without ps_ - so ps_malloc to just malloc etc. There is only few of them. I'm not sure if this would be all - but it should.
```
PIDKiln_LCD.ino:      Program_run_desc=(char *)ps_malloc((strlen(msg)+1)*sizeof(char));
PIDKiln_LCD.ino:      Program_run_name=(char *)ps_malloc((strlen(msg)+1)*sizeof(char));
PIDKiln_http.ino:          Errors=(char *)ps_realloc(Errors,(strlen(Errors)+p->name().length()+3)*sizeof(char));
PIDKiln_http.ino:  screenshot=(char *)ps_malloc(SCREEN_W*SCREEN_H*2*sizeof(char)+1);
PIDKiln_logs.ino:  Logs_DIR=(DIRECTORY*)ps_malloc(sizeof(DIRECTORY)*count);
PIDKiln_program.ino:  Programs_DIR=(DIRECTORY*)ps_malloc(sizeof(DIRECTORY)*count);
PIDKiln_program.ino:      Program_run=(PROGRAM *)ps_realloc(Program_run,sizeof(PROGRAM)*Program_run_size);
PIDKiln_program.ino:  Program_run=(PROGRAM *)ps_malloc(sizeof(PROGRAM)*Program_size);
PIDKiln_program.ino:  Program_run_desc=(char *)ps_malloc((Program_desc.length()+1)*sizeof(char));
PIDKiln_program.ino:  Program_run_name=(char *)ps_malloc((Program_name.length()+1)*sizeof(char));
```

seesoe, 2020-06-22:
I used the ESP32-WROOM with no PSRAM and had the same issues. I changes all the lines to not have `sp_` and all is working now.

Saur0o0n, 2020-06-22:
Good to know :) I had Wroover, so I've used psram - probably overkill :)

kendrick90, 2020-09-18:
You should post this to the main page because wroom boards are so much more common other users are likely to have those.

Saur0o0n, 2020-09-19:
> You should post this to the main page because wroom boards are so much more common other users are likely to have those.

Well, it's there - many times. In component list, BOM and in configuration description there is even information why Wrover not Wroom.

kendrick90, 2020-09-19:
Is there a reason other than because it's what you had laying around? You
yourself said it's probably overkill to use the psram. I meant you should
add the instructions for how to compile for wroom. So people can get
started with what they have laying around.

On Sat, Sep 19, 2020, 3:50 AM Adrian Siemieniak <notifications@github.com>
wrote:

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

Closed 2021-12-03.

Thread 4 (2020-07-15):

Error log id values

seesoe, 2020-07-15:
Where can I find the values for the error log? I have a program that aborted twice around the same spot and I can't seem to figure out why. The kiln wasn't moved or touched in both cases.

```
Program name: 1.txt
Program desc: Slow bisque at 04
Started at: 2020-07-14 05:05:22
Possible end at: 2020-07-14 10:25:22
PID values. Kp:20.00 Ki:0.20 Kd:0.10
Start temperature: 41.8C
CSV filename: 2020-07-14 10:25:22
-=-=-= Starting program =-=-=-=-
Program ended at: 2020-07-14 08:09:20
End temperature: 690.7C
Used power: 1.8 W/h
Program aborted with error: 5
```
```
Program name: 1.txt
Program desc: Slow bisque at 04
Started at: 2020-07-15 03:52:53
Possible end at: 2020-07-15 09:12:53
PID values. Kp:20.00 Ki:0.20 Kd:0.10
Start temperature: 68.5C
CSV filename: 2020-07-15 09:12:53
-=-=-= Starting program =-=-=-=-
Program ended at: 2020-07-15 06:24:43
End temperature: 601.6C
Used power: 1.8 W/h
Program aborted with error: 5
```

Saur0o0n, 2020-07-15:
In PIDKiln.h you have specified all errors (counting start with 0)
```/*
**  Program errors:
*/
typedef enum {
  PR_ERR_FILE_LOAD,       // failed to load file
  PR_ERR_TOO_LONG_LINE,   // program line too long (there is error probably in the line - it should be max. 1111:1111:1111 - so 14 chars, if there where more PIDKiln will throw error without checking why
  PR_ERR_BAD_CHAR,        // not allowed character in program (only allowed characters are numbers and separator ":")
  PR_ERR_TOO_HOT,         // exceeded max temperature defined in MAX_Temp
  PR_ERR_TOO_COLD,        // temperature redout below MIN_Temp
  PR_ERR_MAX31A_INT_ERR,   // failed to read MAX31855 internal temperature on kiln
  PR_ERR_MAX31A_KPROBE,    // failed to read K-probe temperature on kiln
  PR_ERR_MAX31B_INT_ERR,   // failed to read MAX31855 internal temperature on case
  PR_ERR_MAX31B_KPROBE,    // failed to read K-probe temperature on case
  PR_ERR_USER_ABORT,      // user aborted
  PR_ERR_end
} PROGRAM_ERROR_STATE;
```

So error 5 is going to be "PR_ERR_MAX31A_INT_ERR,   // failed to read MAX31855 internal temperature on kiln" - this is not exact error description, since I've changed MAX library (this is for previous one - if we are using PIDKiln 1.1). The exact error you will find in Serial debug or Syslog. This should be one of those:
```
    switch (ThermocoupleA.detectThermocouple())
    {
      case MAX31855_THERMOCOUPLE_SHORT_TO_VCC:
        DBG dbgLog(LOG_ERR,"[ADDONS] ThermocoupleA short to VCC\n");
        break;
      case MAX31855_THERMOCOUPLE_SHORT_TO_GND:
        DBG dbgLog(LOG_ERR,"[ADDONS] ThermocoupleA short to GND\n");
        break;
      case MAX31855_THERMOCOUPLE_NOT_CONNECTED:
        DBG dbgLog(LOG_ERR,"[ADDONS] ThermocoupleA not connected\n");
        break;
      default:
        DBG dbgLog(LOG_ERR,"[ADDONS] ThermocoupleA unknown error, check spi cable\n");
        break;
    }
```

seesoe, 2020-07-15:
Hmm, I tried to setup syslog but I couldn’t get my server to read anything.
I checked udp traffic on the server and I see the esp sending the data to
the server but the syslog server wasn’t able to see it and or parse the
data. What could cause this error to happen twice after a similar extended
period of time each run?

On Wed, Jul 15, 2020 at 1:23 AM Adrian Siemieniak <notifications@github.com>
wrote:

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

Saur0o0n, 2020-07-15:
The most probable cause are some kind of interferences - check if thermocouple cable shield is grounded, check if there is no power starving for ESP32 (I had such a case - everything was working, but thermocouple failed at some point in time - it was because power supply was too weak when used longer).

seesoe, 2020-07-16:
I changed around the mains input to be much further away from the circuits and grounded the thermocouple shielding. Still getting error 5. The 5v power supply is 2 amp. I wrote a more simple program to try and test things out faster `700:20:0` and keep getting error 5 around 580-680. I'll have to borrow a laptop to connect the usb cable for serial monitor since syslog isn't broadcasting for some reason.

seesoe, 2020-07-17:
Heres the serial output I managed to get.

```
21:59:19.605 -> [LOG] Writing to log file:2020-07-17 07:55:58,663,44,142
21:59:19.605 -> [PRG] Curr temp: 663, Set_temp: 669, Incr: 0.05 Pid_out:2419.21 Step: 8
21:59:19.605 -> [ADDONS] Temperature sensor A readout: Internal temp = 34.7 	 Last temp = 664.0 	 Average kiln temp = 663.1
21:59:19.605 -> [ADDONS] Temperature sensor A readout: Internal temp = 34.8 	 Last temp = 663.8 	 Average kiln temp = 663.2
21:59:19.605 -> [ADDONS] VCC is set:3300 ; RAW Power: 20666.9W, Raw current: 89.86A, Power global:21110 W/h:44582.084419
21:59:19.605 -> [ADDONS] Temperature sensor A readout: Internal temp = 34.8 	 Last temp = 663.5 	 Average kiln temp = 663.2
21:59:19.605 -> [ADDONS] Temperature sensor A readout: Internal temp = 34.8 	 Last temp = 663.0 	 Average kiln temp = 663.2
21:59:19.605 -> [ADDONS] VCC is set:3300 ; RAW Power: 9507.0W, Raw current: 41.33A, Power global:14632 W/h:44593.496816
21:59:19.605 -> [ADDONS] ThermocoupleA unknown error, check spi cable
21:59:19.605 -> [PRG] Aborting program with error: 5
21:59:19.605 -> [PRG] Ending program cleanly
21:59:19.605 -> [LOG] Cleaning logs...
```

Saur0o0n, 2020-07-17:
```
21:59:19.605 -> [ADDONS] VCC is set:3300 ; RAW Power: 9507.0W, Raw current: 41.33A, Power global:14632 W/h:44593.496816
21:59:19.605 -> [ADDONS] ThermocoupleA unknown error, check spi cable
```
Nothing meaningful there - so ESP lost connection to MAX31855.
Do you have power meter - because those power values looks a way off - 40A ???

Anyway - what is your setup then? Do you have capacitor for thermocouples connected? Have you tried to change MAX31855 (or switch kiln with case MAX for example).
I had also quite a lot of problems with MAX31855 sensors, but most of the problems solved capacitor on Kprobe and good power supply. Also not a bad idea is to ground shielded wire from thermocouple.

seesoe, 2020-07-17:
I tried switching around the max boards with no luck. Hmmm ya the values seem to be more than double, perhaps EMI as well?

The element is 3840 watt, 16 amp, 240v kanthal.

Here's a picture of my box, it got a little messy trying to figure this issue out. I have the thermocouple shielding single point connected to ac earth. I noticed my lcd mounting was earth grounding the dc circuitry's ground, so I just unmounted that for a test running now.

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

Saur0o0n, 2020-07-17:
The setup looks nice. Are you sure that thermocouple is not simply broken and at some point, with certain temperature (because of thermal expansion) it's not close to ground? I know, that this should be reported by MAX31855 IC - but I haven't tested if all those error reports are accurate - as MAX library says.

seesoe, 2020-07-17:
This is the probe I'm using, it simply pokes through the firebrick, no metal or chassis around it.
https://www.theceramicshop.com/product/28923/type-k-thermocouple-81-4/
https://www.theceramicshop.com/product/6629/thermocouple-mounting-block/

I'll have to inspect the tip later today when it cools down. I don't recall measuring any continuity between the terminals and ground but I will do a sanity check.

seesoe, 2020-07-17:
Probe tip looks ok. Didn't detect any lead wire to ground continuity.

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

Saur0o0n, 2020-07-18:
I'll ask again - I don't see it on picture, and you haven't answered previous question - to you have installed capacitor at the thermocouple connector, close to MAX board?

seesoe, 2020-07-20:
For some reason I assumed (bad) that the cap under the terminal blocks would be enough. I just added a 103 capacitor on both boards but still no luck same thing is happening. I also Installed a brand new thermocouple and yet, same thing is happening.

seesoe, 2020-07-20:
I was digging through the code and realized my power sensor was a 100amp/50ma version. I have the 30anp/1v version being delivered on Tuesday.

Also I flashed a second esp32 with thermocouple b and power sensing disabled and disconnected them from the circuit in hopes to eliminate any possible noise, however I still had no luck, same issue.

Saur0o0n, 2020-07-20:
So to summarize - this happens every time at the same time or temperature? (to find out what could trigger the problem) If you don't know - please create program that will be longer then failing one, but not reaches problematic temperature. And vice versa - shorter program that reaches quicker problematic temperature.
At this point I have not other idea what could be wrong. There is a topic about fake MAX31855 boards (https://forum.arduino.cc/index.php?topic=526439.0) - I'm not saying that this is the case here - but just something to consider. If you do the test with temperature/time - perhaps this will shade some light.

seesoe, 2020-07-20:
I have a 20 minute program that if I run at cold start will successfully pass 580c, however if I run it a 3rd time, it starts to error. Also if I run a typical ￼bisque profile and the kiln is heat soaked, then it will trigger at 580 c which is about 2-3 hours into the program.

I will check my chip markings and report back.

I found this interesting comment. He ￼would get error only at high temps like me so he increased sample rate per read.

https://github.com/jbruce12000/kiln-controller/issues/5#issuecomment-502414536

seesoe, 2020-07-20:
I presume it would be putting this in a loop and only only if all iterations fail, then abort?

https://github.com/Saur0o0n/PIDKiln/blob/master/PIDKiln_addons.ino#L84

Saur0o0n, 2020-07-20:
The difference is, that with raspberry example, errors where shorted to gnd/vcc - here is unknow error (except shorted to gnd/vcc). To be honest, after MAX library change I haven't check if those errors are reported correctly.
I don't believe this could be the problem (and I haven't mentioned it before) - but at this point - your thermocoupole A cable has a loop and it's located directly at relay switch with electromagnet inside, this is probably not the best solution anyway :)

Saur0o0n, 2020-07-20:
> I presume it would be putting this in a loop and only only if all iterations fail, then abort?
>
> https://github.com/Saur0o0n/PIDKiln/blob/master/PIDKiln_addons.ino#L84

Yes, you can do the loop/while there if you wish. But that's kind of "ugly" solution.

seesoe, 2020-07-20:
Agreed, I'll see if it can at least work or if the emi is too high I guess I'll just pull it all out as a test and then redo the whole box idea.

I also found this 13th post where he suggested heavier filtering on the input voltage as well.
https://forums.adafruit.com/viewtopic.php?f=19&t=84826#wrap

seesoe, 2020-07-20:
I was able to get syslog working on a different server and I also added the 5 detect checks.

I ran `700:20:0` at cold start and the program finished successfully twice (expected) then the 3rd time, it aborted about 10 min in. The logs showed in one instance short to grd and then 4 unknown errors. and another couple instances 5 unknown errors. After the program ended the logs reported 5 unknown errors (instead of short to grd) after about 3-5 temperature reads.

Couple examples of abort and reads after.
```
1 - PIDKiln-ESP32 PIDKiln - - - ???[LCD] Graph. mxx:126 mxy:59 ttime:15 mxtemp:700 scx:840 scy:8
1 - PIDKiln-ESP32 PIDKiln - - - ???[LCD] Redrawing box on graph width:73.36 fullt:900 currt:524 prop:0.582222
1 - PIDKiln-ESP32 PIDKiln - - - ???[PRG] Pid_out RAW:3758.02 Pid_out:3758.02 Now-window:3873 WindowSize:5000 Prg_state:2
1 - PIDKiln-ESP32 PIDKiln - - - ???[ADDONS] ThermocoupleA unknown error, check spi cable
1 - PIDKiln-ESP32 PIDKiln - - - ???[ADDONS] ThermocoupleA unknown error, check spi cable
1 - PIDKiln-ESP32 PIDKiln - - - ???[ADDONS] ThermocoupleA unknown error, check spi cable
1 - PIDKiln-ESP32 PIDKiln - - - ???[ADDONS] ThermocoupleA unknown error, check spi cable
1 - PIDKiln-ESP32 PIDKiln - - - ???[ADDONS] ThermocoupleA unknown error, check spi cable
1 - PIDKiln-ESP32 PIDKiln - - - ???[PRG] Aborting program with error: 5
1 - PIDKiln-ESP32 PIDKiln - - - ???[PRG] Ending program cleanly
1 - PIDKiln-ESP32 PIDKiln - - - ???[LOG] Loading dir: Loading directory...
1 - PIDKiln-ESP32 PIDKiln - - - ???[INPUT] Button pressed 0.150000 seconds
1 - PIDKiln-ESP32 PIDKiln - - - ??? Short press. Current view 0
1 - PIDKiln-ESP32 PIDKiln - - - ???[LCD] Entering menu (6) display: 7) About
1 - PIDKiln-ESP32 PIDKiln - - - ???[LCD] In menu we can print 5 lines, with 2px space, and char height 10
1 - PIDKiln-ESP32 PIDKiln - - - ???[LCD] Start pos is 4, chosen position is 6, screen center is 2
1 - PIDKiln-ESP32 PIDKiln - - - ???[LCD] x0: 0, y0: 24, w: 128, h: 12
1 - PIDKiln-ESP32 PIDKiln - - - ???[LOG] Loading dir:	counted 13 files
1 - PIDKiln-ESP32 PIDKiln - - - ???[LOG] FName: 200720_084119.csv	 FSize:892	Sel:0
1 - PIDKiln-ESP32 PIDKiln - - - ???[LOG] FName: 200720_084119.log	 FSize:313	Sel:0
1 - PIDKiln-ESP32 PIDKiln - - - ???[LOG] FName: 200720_085707.csv	 FSize:472	Sel:0
1 - PIDKiln-ESP32 PIDKiln - - - ???[LOG] FName: 200720_085707.log	 FSize:343	Sel:0
1 - PIDKiln-ESP32 PIDKiln - - - ???[LOG] FName: 200720_135759.csv	 FSize:892	Sel:0
1 - PIDKiln-ESP32 PIDKiln - - - ???[LOG] FName: 200720_135759.log	 FSize:313	Sel:0
1 - PIDKiln-ESP32 PIDKiln - - - ???[LOG] FName: 200720_141541.csv	 FSize:892	Sel:0
1 - PIDKiln-ESP32 PIDKiln - - - ???[LOG] FName: 200720_141541.log	 FSize:313	Sel:0
1 - PIDKiln-ESP32 PIDKiln - - - ???[LOG] FName: 200720_143158.csv	 FSize:304	Sel:0
1 - PIDKiln-ESP32 PIDKiln - - - ???[LOG] FName: 200720_143158.log	 FSize:343	Sel:0
1 - PIDKiln-ESP32 PIDKiln - - - ???[LOG] FName: 200720_143812.csv	 FSize:528	Sel:0
1 - PIDKiln-ESP32 PIDKiln - - - ???[LOG] FName: 200720_143812.log	 FSize:343	Sel:0
1 - PIDKiln-ESP32 PIDKiln - - - ???[INPUT] Rotate, SCR_MENU: Encoder turn: 1, Sizeof menu 8, Menu nr 6,
1 - PIDKiln-ESP32 PIDKiln - - - ???[LCD] Entering menu (7) display: 8) Restart
1 - PIDKiln-ESP32 PIDKiln - - - ???[LCD] In menu we can print 5 lines, with 2px space, and char height 10
1 - PIDKiln-ESP32 PIDKiln - - - ???[LCD] Start pos is 5, chosen position is 7, screen center is 2
1 - PIDKiln-ESP32 PIDKiln - - - ???[HTTP] Head of logs - copying...
1 - PIDKiln-ESP32 PIDKiln - - - ???[LCD] x0: 0, y0: 24, w: 128, h: 12
1 - PIDKiln-ESP32 PIDKiln - - - ???[INPUT] Encoder rotated 1
1 - PIDKiln-ESP32 PIDKiln - - - ???[HTTP] End of log index - copying...
1 - PIDKiln-ESP32 PIDKiln - - - ???[ADDONS] Temperature sensor A readout: Internal temp = 34.0 	 Last temp = 609.2 	 Average kiln temp = 606.4
1 - PIDKiln-ESP32 PIDKiln - - - ???[ADDONS] ThermocoupleA unknown error, check spi cable
1 - PIDKiln-ESP32 PIDKiln - - - ???[ADDONS] ThermocoupleA unknown error, check spi cable
1 - PIDKiln-ESP32 PIDKiln - - - ???[ADDONS] ThermocoupleA unknown error, check spi cable
1 - PIDKiln-ESP32 PIDKiln - - - ???[ADDONS] ThermocoupleA unknown error, check spi cable
1 - PIDKiln-ESP32 PIDKiln - - - ???[ADDONS] ThermocoupleA unknown error, check spi cable
1 - PIDKiln-ESP32 PIDKiln - - - ???[ADDONS] Temperature sensor A readout: Internal temp = 34.0 	 Last temp = 609.0 	 Average kiln temp = 606.6
1 - PIDKiln-ESP32 PIDKiln - - - ???[ADDONS] Temperature sensor A readout: Internal temp = 34.0 	 Last temp = 608.8 	 Average kiln temp = 606.8
1 - PIDKiln-ESP32 PIDKiln - - - ???[ADDONS] Temperature sensor A readout: Internal temp = 34.0 	 Last temp = 608.5 	 Average kiln temp = 607.0
1 - PIDKiln-ESP32 PIDKiln - - - ???[ADDONS] Temperature sensor A readout: Internal temp = 34.0 	 Last temp = 608.2 	 Average kiln temp = 607.1
1 - PIDKiln-ESP32 PIDKiln - - - ???[ADDONS] Temperature sensor A readout: Internal temp = 34.0 	 Last temp = 607.8 	 Average kiln temp = 607.2
1 - PIDKiln-ESP32 PIDKiln - - - ???[ADDONS] Temperature sensor A readout: Internal temp = 34.0 	 Last temp = 607.5 	 Average kiln temp = 607.2
1 - PIDKiln-ESP32 PIDKiln - - - ???[ADDONS] Temperature sensor A readout: Internal temp = 34.0 	 Last temp = 607.0 	 Average kiln temp = 607.2
1 - PIDKiln-ESP32 PIDKiln - - - ???[ADDONS] Temperature sensor A readout: Internal temp = 34.0 	 Last temp = 606.5 	 Average kiln temp = 607.1
1 - PIDKiln-ESP32 PIDKiln - - - ???[ADDONS] Temperature sensor A readout: Internal temp = 34.0 	 Last temp = 606.0 	 Average kiln temp = 607.0
1 - PIDKiln-ESP32 PIDKiln - - - ???[ADDONS] Temperature sensor A readout: Internal temp = 34.0 	 Last temp = 605.5 	 Average kiln temp = 606.9
1 - PIDKiln-ESP32 PIDKiln - - - ???[ADDONS] Temperature sensor A readout: Internal temp = 34.0 	 Last temp = 605.0 	 Average kiln temp = 606.7
1 - PIDKiln-ESP32 PIDKiln - - - ???[ADDONS] Temperature sensor A readout: Internal temp = 34.0 	 Last temp = 604.2 	 Average kiln temp = 606.4
1 - PIDKiln-ESP32 PIDKiln - - - ???[ADDONS] Temperature sensor A readout: Internal temp = 34.0 	 Last temp = 604.0 	 Average kiln temp = 606.2
1 - PIDKiln-ESP32 PIDKiln - - - ???[ADDONS] Temperature sensor A readout: Internal temp = 34.0 	 Last temp = 603.5 	 Average kiln temp = 605.9
1 - PIDKiln-ESP32 PIDKiln - - - ???[ADDONS] ThermocoupleA unknown error, check spi cable
1 - PIDKiln-ESP32 PIDKiln - - - ???[ADDONS] ThermocoupleA unknown error, check spi cable
1 - PIDKiln-ESP32 PIDKiln - - - ???[ADDONS] ThermocoupleA unknown error, check spi cable
1 - PIDKiln-ESP32 PIDKiln - - - ???[ADDONS] ThermocoupleA unknown error, check spi cable
1 - PIDKiln-ESP32 PIDKiln - - - ???[ADDONS] ThermocoupleA unknown error, check spi cable
1 - PIDKiln-ESP32 PIDKiln - - - ???[ADDONS] Temperature sensor A readout: Internal temp = 34.0 	 Last temp = 602.2 	 Average kiln temp = 605.6
1 - PIDKiln-ESP32 PIDKiln - - - ???[ADDONS] Temperature sensor A readout: Internal temp = 34.0 	 Last temp = 602.0 	 Average kiln temp = 605.2
1 - PIDKiln-ESP32 PIDKiln - - - ???[ADDONS] ThermocoupleA unknown error, check spi cable
1 - PIDKiln-ESP32 PIDKiln - - - ???[ADDONS] ThermocoupleA unknown error, check spi cable
1 - PIDKiln-ESP32 PIDKiln - - - ???[ADDONS] ThermocoupleA unknown error, check spi cable
1 - PIDKiln-ESP32 PIDKiln - - - ???[ADDONS] ThermocoupleA unknown error, check spi cable
1 - PIDKiln-ESP32 PIDKiln - - - ???[ADDONS] ThermocoupleA unknown error, check spi cable
1 - PIDKiln-ESP32 PIDKiln - - - ???[ADDONS] Temperature sensor A readout: Internal temp = 34.0 	 Last temp = 600.8 	 Average kiln temp = 604.8
1 - PIDKiln-ESP32 PIDKiln - - - ???[ADDONS] ThermocoupleA unknown error, check spi cable
1 - PIDKiln-ESP32 PIDKiln - - - ???[ADDONS] ThermocoupleA unknown error, check spi cable
1 - PIDKiln-ESP32 PIDKiln - - - ???[ADDONS] ThermocoupleA unknown error, check spi cable
1 - PIDKiln-ESP32 PIDKiln - - - ???[ADDONS] ThermocoupleA unknown error, check spi cable
1 - PIDKiln-ESP32 PIDKiln - - - ???[ADDONS] ThermocoupleA unknown error, check spi cable
1 - PIDKiln-ESP32 PIDKiln - - - ???[ADDONS] Temperature sensor A readout: Internal temp = 34.0 	 Last temp = 599.8 	 Average kiln temp = 604.3
1 - PIDKiln-ESP32 PIDKiln - - - ???[ADDONS] Temperature sensor A readout: Internal temp = 34.0 	 Last temp = 598.8 	 Average kiln temp = 603.7
1 - PIDKiln-ESP32 PIDKiln - - - ???[ADDONS] Temperature sensor A readout: Internal temp = 34.0 	 Last temp = 598.2 	 Average kiln temp = 603.2
1 - PIDKiln-ESP32 PIDKiln - - - ???[ADDONS] Temperature sensor A readout: Internal temp = 34.1 	 Last temp = 597.5 	 Average kiln temp = 602.6
1 - PIDKiln-ESP32 PIDKiln - - - ???[ADDONS] ThermocoupleA short to GND
1 - PIDKiln-ESP32 PIDKiln - - - ???[ADDONS] ThermocoupleA unknown error, check spi cable
1 - PIDKiln-ESP32 PIDKiln - - - ???[ADDONS] ThermocoupleA unknown error, check spi cable
1 - PIDKiln-ESP32 PIDKiln - - - ???[ADDONS] ThermocoupleA unknown error, check spi cable
1 - PIDKiln-ESP32 PIDKiln - - - ???[ADDONS] ThermocoupleA unknown error, check spi cable
1 - PIDKiln-ESP32 PIDKiln - - - ???[ADDONS] Temperature sensor A readout: Internal temp = 34.0 	 Last temp = 596.2 	 Average kiln temp = 602.0
1 - PIDKiln-ESP32 PIDKiln - - - ???[ADDONS] Temperature sensor A readout: Internal temp = 34.0 	 Last temp = 595.5 	 Average kiln temp = 601.3
1 - PIDKiln-ESP32 PIDKiln - - - ???[ADDONS] Temperature sensor A readout: Internal temp = 34.0 	 Last temp = 595.0 	 Average kiln temp = 600.7
1 - PIDKiln-ESP32 PIDKiln - - - ???[ADDONS] Temperature sensor A readout: Internal temp = 34.0 	 Last temp = 594.5 	 Average kiln temp = 600.1
1 - PIDKiln-ESP32 PIDKiln - - - ???[ADDONS] Temperature sensor A readout: Internal temp = 34.0 	 Last temp = 593.8 	 Average kiln temp = 599.4
1 - PIDKiln-ESP32 PIDKiln - - - ???[ADDONS] Temperature sensor A readout: Internal temp = 34.0 	 Last temp = 593.0 	 Average kiln temp = 598.8
```
```
1 - PIDKiln-ESP32 PIDKiln - - - ???[PRG] Pid_out RAW:3723.63 Pid_out:3723.63 Now-window:2586 WindowSize:5000 Prg_state:2
1 - PIDKiln-ESP32 PIDKiln - - - ???[ADDONS] Temperature sensor A readout: Internal temp = 33.9 	 Last temp = 596.5 	 Average kiln temp = 593.7
1 - PIDKiln-ESP32 PIDKiln - - - ???[ADDONS] Temperature sensor A readout: Internal temp = 34.0 	 Last temp = 597.0 	 Average kiln temp = 594.0
1 - PIDKiln-ESP32 PIDKiln - - - ???[LOG] Writing to log file:2020-07-20 14:36:28,594,20
1 - PIDKiln-ESP32 PIDKiln - - - ???[PRG] Curr temp: 594, Set_temp: 656, Incr: 0.07 Pid_out:3733.43 Step: 0
1 - PIDKiln-ESP32 PIDKiln - - - ???[ADDONS] Temperature sensor A readout: Internal temp = 34.0 	 Last temp = 596.5 	 Average kiln temp = 594.3
1 - PIDKiln-ESP32 PIDKiln - - - ???[ADDONS] Temperature sensor A readout: Internal temp = 33.9 	 Last temp = 596.8 	 Average kiln temp = 594.5
1 - PIDKiln-ESP32 PIDKiln - - - ???[ADDONS] Temperature sensor A readout: Internal temp = 33.9 	 Last temp = 597.5 	 Average kiln temp = 594.8
1 - PIDKiln-ESP32 PIDKiln - - - ???[ADDONS] Temperature sensor A readout: Internal temp = 33.9 	 Last temp = 598.2 	 Average kiln temp = 595.2
1 - PIDKiln-ESP32 PIDKiln - - - ???[ADDONS] ThermocoupleA unknown error, check spi cable
1 - PIDKiln-ESP32 PIDKiln - - - ???[ADDONS] ThermocoupleA unknown error, check spi cable
1 - PIDKiln-ESP32 PIDKiln - - - ???[ADDONS] ThermocoupleA unknown error, check spi cable
1 - PIDKiln-ESP32 PIDKiln - - - ???[ADDONS] ThermocoupleA unknown error, check spi cable
1 - PIDKiln-ESP32 PIDKiln - - - ???[ADDONS] ThermocoupleA unknown error, check spi cable
1 - PIDKiln-ESP32 PIDKiln - - - ???[PRG] Aborting program with error: 5
1 - PIDKiln-ESP32 PIDKiln - - - ???[PRG] Ending program cleanly
1 - PIDKiln-ESP32 PIDKiln - - - ???[LOG] Loading dir: Loading directory...
1 - PIDKiln-ESP32 PIDKiln - - - ???[INPUT] Button pressed 0.148000 seconds
1 - PIDKiln-ESP32 PIDKiln - - - ??? Short press. Current view 0
1 - PIDKiln-ESP32 PIDKiln - - - ???[LCD] Entering menu (4) display: 5) Preferences
1 - PIDKiln-ESP32 PIDKiln - - - ???[LCD] In menu we can print 5 lines, with 2px space, and char height 10
1 - PIDKiln-ESP32 PIDKiln - - - ???[LOG] Loading dir:	counted 11 files
1 - PIDKiln-ESP32 PIDKiln - - - ???[LCD] Start pos is 2, chosen position is 4, screen center is 2
1 - PIDKiln-ESP32 PIDKiln - - - ???[LCD] x0: 0, y0: 24, w: 128, h: 12
1 - PIDKiln-ESP32 PIDKiln - - - ???[LOG] FName: 200720_084119.csv	 FSize:892	Sel:0
1 - PIDKiln-ESP32 PIDKiln - - - ???[LOG] FName: 200720_084119.log	 FSize:313	Sel:0
1 - PIDKiln-ESP32 PIDKiln - - - ???[LOG] FName: 200720_085707.csv	 FSize:472	Sel:0
1 - PIDKiln-ESP32 PIDKiln - - - ???[LOG] FName: 200720_085707.log	 FSize:343	Sel:0
1 - PIDKiln-ESP32 PIDKiln - - - ???[LOG] FName: 200720_135759.csv	 FSize:892	Sel:0
1 - PIDKiln-ESP32 PIDKiln - - - ???[LOG] FName: 200720_135759.log	 FSize:313	Sel:0
1 - PIDKiln-ESP32 PIDKiln - - - ???[LOG] FName: 200720_141541.csv	 FSize:892	Sel:0
1 - PIDKiln-ESP32 PIDKiln - - - ???[LOG] FName: 200720_141541.log	 FSize:313	Sel:0
1 - PIDKiln-ESP32 PIDKiln - - - ???[LOG] FName: 200720_143158.csv	 FSize:304	Sel:0
1 - PIDKiln-ESP32 PIDKiln - - - ???[LOG] FName: 200720_143158.log	 FSize:343	Sel:0
1 - PIDKiln-ESP32 PIDKiln - - - ???[INPUT] Rotate, SCR_MENU: Encoder turn: 1, Sizeof menu 8, Menu nr 4,
1 - PIDKiln-ESP32 PIDKiln - - - ???[HTTP] Head of logs - copying...
1 - PIDKiln-ESP32 PIDKiln - - - ???[LCD] Entering menu (5) display: 6) Reconnect WiFi
1 - PIDKiln-ESP32 PIDKiln - - - ???[LCD] In menu we can print 5 lines, with 2px space, and char height 10
1 - PIDKiln-ESP32 PIDKiln - - - ???[LCD] Start pos is 3, chosen position is 5, screen center is 2
1 - PIDKiln-ESP32 PIDKiln - - - ???[LCD] x0: 0, y0: 24, w: 128, h: 12
1 - PIDKiln-ESP32 PIDKiln - - - ???[INPUT] Encoder rotated 1
1 - PIDKiln-ESP32 PIDKiln - - - ???[HTTP] End of log index - copying...
1 - PIDKiln-ESP32 PIDKiln - - - ???[ADDONS] Temperature sensor A readout: Internal temp = 33.9 	 Last temp = 598.8 	 Average kiln temp = 595.5
1 - PIDKiln-ESP32 PIDKiln - - - ???[ADDONS] Temperature sensor A readout: Internal temp = 33.9 	 Last temp = 599.0 	 Average kiln temp = 595.9
1 - PIDKiln-ESP32 PIDKiln - - - ???[ADDONS] Temperature sensor A readout: Internal temp = 33.9 	 Last temp = 599.0 	 Average kiln temp = 596.2
1 - PIDKiln-ESP32 PIDKiln - - - ???[ADDONS] Temperature sensor A readout: Internal temp = 33.9 	 Last temp = 599.0 	 Average kiln temp = 596.5
1 - PIDKiln-ESP32 PIDKiln - - - ???[ADDONS] ThermocoupleA unknown error, check spi cable
1 - PIDKiln-ESP32 PIDKiln - - - ???[ADDONS] ThermocoupleA unknown error, check spi cable
1 - PIDKiln-ESP32 PIDKiln - - - ???[ADDONS] ThermocoupleA unknown error, check spi cable
1 - PIDKiln-ESP32 PIDKiln - - - ???[ADDONS] ThermocoupleA unknown error, check spi cable
1 - PIDKiln-ESP32 PIDKiln - - - ???[ADDONS] ThermocoupleA unknown error, check spi cable
1 - PIDKiln-ESP32 PIDKiln - - - ???[ADDONS] Temperature sensor A readout: Internal temp = 33.9 	 Last temp = 598.8 	 Average kiln temp = 596.7
1 - PIDKiln-ESP32 PIDKiln - - - ???[ADDONS] ThermocoupleA short to GND
1 - PIDKiln-ESP32 PIDKiln - - - ???[ADDONS] ThermocoupleA unknown error, check spi cable
1 - PIDKiln-ESP32 PIDKiln - - - ???[ADDONS] ThermocoupleA unknown error, check spi cable
1 - PIDKiln-ESP32 PIDKiln - - - ???[ADDONS] ThermocoupleA unknown error, check spi cable
1 - PIDKiln-ESP32 PIDKiln - - - ???[ADDONS] ThermocoupleA unknown error, check spi cable
1 - PIDKiln-ESP32 PIDKiln - - - ???[ADDONS] Temperature sensor A readout: Internal temp = 33.9 	 Last temp = 598.0 	 Average kiln temp = 596.8
1 - PIDKiln-ESP32 PIDKiln - - - ???[ADDONS] Temperature sensor A readout: Internal temp = 33.9 	 Last temp = 598.0 	 Average kiln temp = 596.9
1 - PIDKiln-ESP32 PIDKiln - - - ???[ADDONS] Temperature sensor A readout: Internal temp = 33.9 	 Last temp = 597.5 	 Average kiln temp = 597.0
1 - PIDKiln-ESP32 PIDKiln - - - ???[ADDONS] Temperature sensor A readout: Internal temp = 33.9 	 Last temp = 597.2 	 Average kiln temp = 597.0
1 - PIDKiln-ESP32 PIDKiln - - - ???[ADDONS] Temperature sensor A readout: Internal temp = 33.9 	 Last temp = 596.5 	 Average kiln temp = 597.0
1 - PIDKiln-ESP32 PIDKiln - - - ???[ADDONS] Temperature sensor A readout: Internal temp = 33.9 	 Last temp = 596.5 	 Average kiln temp = 596.9
1 - PIDKiln-ESP32 PIDKiln - - - ???[ADDONS] Temperature sensor A readout: Internal temp = 33.9 	 Last temp = 596.0 	 Average kiln temp = 596.8
1 - PIDKiln-ESP32 PIDKiln - - -
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

Thread 5 (2020-12-19):

ESP32-WROOM Compatibility

thomasfla, 2020-12-19:
Hello, thanks for this amazing code. I was working on the exact same thing and came across your code just in time!

I have all the required components except that I only have ESP32-Wroom based dev board instead of Wrover.
I wanted to know what the PSRAM is used for in your code and how difficult it would be to adapt it to not use it.

Best,
T.

Saur0o0n, 2020-12-19:
Hi, there is already some information on this topic in [here](https://github.com/Saur0o0n/PIDKiln/issues/2#issuecomment-613921578) - it shouldn't be hard to convert the code.

thomasfla, 2020-12-19:
Wanderfull, thanks.

Closed 2020-12-19.

Thread 7 (2021-05-05):

NTP

kendrick90, 2021-05-05:
If I set the GMT_OFFSET time to -25200 it does not produce the correct time. I believe this may be an int16 overflow.

Saur0o0n, 2021-05-05:
This is in range of int16 (signed number from -32768 to 32767) - but I see some errors in NTP function, it calls it as uint, not int. I'm not sure if this is the problem - but I'll push fix for it. Please check.

kendrick90, 2021-05-06:
It works thanks! I would also suggest making it be offset in hours and just multiply by 3600 in the configTime line. Thanks again. I'll be trying it out in the next week or so after I install a 240V outlet for my kiln. Another random suggestion that might not work 100% of the time but doesn't seem to break it is `#include <ESPmDNS.h>` and  add
`      if (!MDNS.begin("PIDKiln")) {
        Serial.println("Error starting mDNS");
        return;
      }`  in PIDKiln.ino
after connecting to the network. That way you can access the interface from http://pidkiln.local

kendrick90, 2021-05-15:
I have been working on getting this $10 screen + rotary encoder + buzzer + SD card reader + RGB LEDs ["fysetc mini 12864"](https://www.amazon.com/gp/product/B085RYXYCM/ref=ppx_yo_dt_b_asin_title_o05_s00?ie=UTF8&psc=1) working to use with the PIDKiln controller. The code I have written for the screen in platformio and I have just finished porting your project to be compatible with platformio too. https://github.com/kendrick90/PIDKilnPIO I am not a great programmer but I am learning through this project. I am hoping that we can store files on the SD card instead of the PSRAM so we can use the cheaper WROOM boards but for now I will stick with the WROVER. I also plan to make a simple pcb with headers for the screen, esp, max31855, and power to plug into. I think it will be a very clean package all said and done. Thanks for creating this project for me to work with and if you are interested in collaborating you can reach me at my user name at gmail.

Closed 2021-05-15.

Thread 11 (2021-12-10):

Chart not showing

no1dea, 2021-12-10:
First of all thank  your for this awesome work.

I updated today to the newest version first after having some issues with the temperature readings, now the chart on the Main Page is no longer showing. I think it's an issue with the log file location, at least that's what i was able to determine with my limited knowledge. I tried to grasp the interactions between the PIDKiln_vars.json, chart.js and the PIDKiln_logs.ino.

The Chrome developer tools show an Error 500 when the charts.js tries to read the .csv, as it is looking for it in the current folder and not in the logs folder.

`GET http://192.168.51.138/211210_105721.csv 500 (Internal Server Error)
request @ chartjs-datasource.min.js:7
beforeUpdate @ chartjs-datasource.min.js:7
notify @ Chart.2.9.3.bundle.min.js:7
update @ Chart.2.9.3.bundle.min.js:7
chart_update @ chart.js:163
setTimeout (async)
chart_update @ chart.js:164
Uncaught TypeError: Cannot read properties of undefined (reading 'datasets')
    at chartjs-datasource.min.js:7:9686
    at n.<anonymous> (chartjs-datasource.min.js:7:10087)
    at XMLHttpRequest.n.onreadystatechange (chartjs-datasource.min.js:7:775)`

If you need any more information I'd be happy to help.

Saur0o0n, 2021-12-10:
Hi,
What is the serial output debug? The chart will not show unless you load the program and there are data to be seen.

no1dea, 2021-12-10:
I have to rewire the controller so it's just powered by usb, but the kiln is running and also producing an .cvs file which I can open, the chart is just not showing the current running program and the mentioned error is in the chrome console log.

I'll get back to you with a debug output, hopefully tomorrow.

Saur0o0n, 2021-12-10:
What ESP32 version framework do you have right now? With PIDKiln 1.2 you have to have 2.0.x - it will not work with older ones (since there was SPIFFS directory handling change).
You can see it in Board Manager:
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

no1dea, 2021-12-10:
Thank your for your really fast answer!

Yes I updated all the libraries and board managers to the newest versions beforehand and everything compiles fine. I attached a debug log, but i don't think there is anything in it.
[pidkiln-debug.log](https://github.com/Saur0o0n/PIDKiln/files/7695774/pidkiln-debug.log)

But I found something strange, when I load the program, the chart is showing until the program is started, then it's gone.

djObsidian, 2022-01-27:
Same problem
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
Chart is not showing when programm is running

djObsidian, 2022-01-27:
chart.js also differs
https://github.com/Saur0o0n/PIDKiln/blob/master/data/js/chart.js#L97
But if i request it from esp
GET 192.168.2.78/js/chart.js
it looks different:
`plugins: {
			datasource: {
				type: 'csv',
				url: '/logs/test.csv',
				delimiter: ',',
				rowMapping: 'index',
				datasetLabels: true,
				indexLabels: true
			}
		}`
Isn't that weired?

Saur0o0n, 2022-01-27:
I have to sit on it, perhaps there are some other changes on ESP2.0.x framework, not only SPIFFS handling, that mess with file processing.

djObsidian, 2022-01-27:
I'm actually not even sure if this is backend problem.
While programm is running,
`GET http://192.168.2.78/220127_112559.csv`
returns `HTTP/1.1 500 Internal Server Error  `
But,
`GET http://192.168.2.78/logs/220127_112559.csv`
Returns  `HTTP/1.1 200 OK `

The file is there, but we are requesting wrong path for some reason. I didn't investigated how your code works, but here are some thougths:
1) Since `GET 192.168.2.78/js/chart.js`
has `url: '/logs/test.csv'`
it implies that CSVFile is null, while it actually shouldn't
https://github.com/Saur0o0n/PIDKiln/blob/master/PIDKiln_http.ino#L333
2) Adding propper error handling would be nice, because http error should be 404, not 500
3) Sidenote, https://github.com/Saur0o0n/PIDKiln/blob/master/PIDKiln_http.ino#L754
Versions of Chart.js are different for local file and loading it from internet. Not sure if that's significant, but with _Send large JS from local server_ setting set to _Redirect to Internet sources (recommended)_ chart does not works at all

djObsidian, 2022-01-27:
Okay, i found the issue:
https://arduino-esp8266.readthedocs.io/en/latest/filesystem.html#name
_Returns short (no-path) file name, as const char*. Convert it to String for storage._
So, all file.name should be replaced with file.fullName

Saur0o0n, 2022-01-27:
So as I said - it's  because ESP2.0.x changes in handling Spiffs - I must oversee it (see [this bug](https://github.com/Saur0o0n/PIDKiln/issues/10#issuecomment-972815240))

djObsidian, 2022-01-27:
https://github.com/espressif/arduino-esp32/releases/tag/2.0.0
https://github.com/espressif/arduino-esp32/commit/f6c9faf4daeff4ac6bcfafd55dbb1fb922b304ed
Should be as simple as changing .name to .path everywhere

Saur0o0n, 2022-01-27:
I'll take a look - it should be simple, but needs testing.

>     2. Adding propper error handling would be nice, because http error should be 404, not 500
This is done by webserver - probably there is something more going on than just filepath.

>     3. Sidenote, https://github.com/Saur0o0n/PIDKiln/blob/master/PIDKiln_http.ino#L754
>        Versions of Chart.js are different for local file and loading it from internet. Not sure if that's significant, but with _Send large JS from local server_ setting set to _Redirect to Internet sources (recommended)_ chart does not works at all

Only 3 files can be served externally
```
  if(Prefs[PRF_HTTP_JS_LOCAL].value.str){
    server.on("/js/jquery-3.4.1.js", HTTP_GET, [](AsyncWebServerRequest* request) {
      AsyncWebServerResponse* response = request->beginResponse(SPIFFS, "/js/jquery-3.4.1.js", "text/javascript");
      response->addHeader("Content-Encoding", "gzip");
      request->send(response);
    });
    server.on("/js/Chart.2.9.3.bundle.min.js", HTTP_GET, [](AsyncWebServerRequest* request) {
      AsyncWebServerResponse* response = request->beginResponse(SPIFFS, "/js/Chart.2.9.3.bundle.min.js", "text/javascript");
      response->addHeader("Content-Encoding", "gzip");
      request->send(response);
    });
    server.on("/js/chartjs-datasource.min.js", HTTP_GET, [](AsyncWebServerRequest* request) {
      AsyncWebServerResponse* response = request->beginResponse(SPIFFS, "/js/chartjs-datasource.min.js", "text/javascript");
      response->addHeader("Content-Encoding", "gzip");
      request->send(response);
    });
  }else{
    server.on("/js/jquery-3.4.1.js", HTTP_GET, [](AsyncWebServerRequest* request) {
      request->redirect(JS_JQUERY);
    });
    server.on("/js/Chart.2.8.0.bundle.min.js", HTTP_GET, [](AsyncWebServerRequest* request) {
      request->redirect(JS_CHART);
    });
    server.on("/js/chartjs-datasource.min.js", HTTP_GET, [](AsyncWebServerRequest* request) {
      request->redirect(JS_CHART_DS);
    });
  }
```

djObsidian, 2022-01-27:
Note, only PIDKiln_http.ino requires to change all instances of .name to .path, other files should be left as is.
https://github.com/Saur0o0n/PIDKiln/blob/37ab4be20f6a670d46bc488bf3013dfc6d93d8c6/PIDKiln_http.ino#L333

https://github.com/Saur0o0n/PIDKiln/blob/37ab4be20f6a670d46bc488bf3013dfc6d93d8c6/PIDKiln_http.ino#L438

https://github.com/Saur0o0n/PIDKiln/blob/37ab4be20f6a670d46bc488bf3013dfc6d93d8c6/PIDKiln_http.ino#L504

https://github.com/Saur0o0n/PIDKiln/blob/37ab4be20f6a670d46bc488bf3013dfc6d93d8c6/PIDKiln_http.ino#L645

I changed that and everything is working so far.

> This is done by webserver - probably there is something more going on than just filepath.

No, if i request any file that doesn't exists, it returns 500, not 404.
Even example for server has code for not found handling
https://github.com/me-no-dev/ESPAsyncWebServer/blob/1d46269cedf477661ca8a29518414f4b74e957d4/examples/simple_server/simple_server.ino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

> Only 3 files can be served externally

I mean here
https://github.com/Saur0o0n/PIDKiln/blob/37ab4be20f6a670d46bc488bf3013dfc6d93d8c6/PIDKiln_http.ino#L754
and here
https://github.com/Saur0o0n/PIDKiln/blob/37ab4be20f6a670d46bc488bf3013dfc6d93d8c6/PIDKiln_http.ino#L768
different versions of Chart.min.js are specified

no1dea, 2022-01-28:
I can confirm that changing `.name()` to `.path()`  in `PIDKiln_http.ino` fixes the issue with the chart not showing while the kiln is running.

Thank you for investigating @djObsidian and @Saur0o0n .

Saur0o0n, 2022-01-28:
Yah, I know - l've checked it yesterday, but I wanted to test it on full device (that I don't have at home) - not only on esp32 board, like previous bugfixes and changes. I've pushed those changes (and some memory stuff) - but there is more...

Saur0o0n, 2022-01-28:
I'm closing this one - I've pushed checked code, with some other fixes.

Closed 2022-01-28.

Thread 12 (2021-12-21):

Possibility using DS18B20 sensors

Kev0s86, 2021-12-21:
Is if possible to use other Sensors?

Saur0o0n, 2021-12-21:
Quick answer - no. Longer - but for what reason? This is low temp sensor (unless for what I known). Perhaps it could be sufficient to monitor temperature of the outside case of kiln, but it was easier to use another max board and k-probe.

TurboNerd95, 2021-12-23:
You could make a very overkill sous-vide cooker!

Thread 13 (2022-01-21):

MAX31855 Linearization

djObsidian, 2022-01-21:
According to [datasheet](https://datasheets.maximintegrated.com/en/ds/MAX31855.pdf), page 8, max31855 assumes a linear relationship between temperature and voltage, which is not accurate. For accurate results linearisztion needs to be performed. Otherwise there will be temperature error >10 degrees at real TC temperatures greater than 200 degrees.
Here is an example of arduino code for linearising max31855 data
https://github.com/heypete/MAX31855-Linearization

djObsidian, 2022-01-21:
This is a serious issue. I, not being aware of the need for additional data correction, even contacted Maxim Integrated tech support. I measured the readings of max31855 and compared them with the expected ones. As you can see from the table below, the error is significant.

t ref | mV theor. | mV measured | t max31855
-- | -- | -- | --
26 | 0 | 0 | 27
100 | 2.09 | 2.0 | 84
200 | 5.23 | 5.5 | 177
300 | 8.66 | 8.6 | 261
350 | 10.45 | 10.4 | 326

The response from tech support was following:

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

Saur0o0n, 2022-01-21:
Well, to be honest I had no idea if this is significant. Previously I've used modified Adafruit MAX31856 library that had additional linearization (not by default - also mod)
```
double Adafruit_MAX31855::linearizeCelcius(double internalTemp, double rawTemp) {
  //////////////////////////////////////////////////////////////////////////
  // Function:       Takes the thermocouple temperature measurement and
  //                   corrects the linearity errors.
  // Input:
  //   double internalTemp  = value from readInternal()
  //   double rawTemp       = value from readCelsius()
  //
  // Returns:
  //   double               = Corrected Celsius thermocouple temperature
  //////////////////////////////////////////////////////////////////////////
  // Adapted from https://github.com/heypete/MAX31855-Linearization
  // Equations and coefficients from: https://srdata.nist.gov/its90/main/its90_main_page.html
  // Retrieved 2018-09-01
```
This this library was less reliable and trow different errors - also it introduced at some point, some additional dependant libraries (Adafruit) that I thought are too much and complicated everything beyond usefulness.

djObsidian, 2022-01-21:
As far as I can see the library you are using now doesn't has any linearization. IMHO, that's significant, because you don't want your kiln to read 950 degrees when it's actually 1050. At temperatures below 300 degrees, that might be not a big deal

Saur0o0n, 2022-01-24:
It should be relatively easy to add it to library - it's just math - but since author still haven't accept my last commit, I've asked if we can [add it](https://github.com/enjoyneering/MAX31855/issues/8).

ruffner, 2024-09-17:
Looks like it would be straight forward to add this snipped in, since enjoyneering hasn't addressed your PR yet. https://learn.adafruit.com/calibrating-sensors/maxim-31855-linearization.

Thread 15 (2022-01-31):

PID is not working as expected thus untunable

djObsidian, 2022-01-31:
The implementation of the PID controller in the library used is completely strange, if not inadequate. I have never seen such a variation of the regulator, and I have not seen any method of tuning it.
https://github.com/br3ttb/Arduino-PID-Library/blob/9b4ca0e5b6d7bab9c6ac023e249d6af2446d99bb/PID_v1.cpp#L83
What the hell is this?
I read his blog, I am aware of the benefits described, including for PonM, but there are simply no methods of setting up such a regulator other than a stupid search for values. No conventional methods, such as the Ziegler-Nichols Method, just don't work here.
The author doesn't provide any tuning method on the blog or on the github.
I tried to synthesise PID values using Matlab PID tuner and they didn't worked, not even close.
First method from this [video ](https://www.youtube.com/watch?v=9vZSw_xzC9E) produced values somewhat close to matlab's ones, neither they worked.
It would be nice to add a disclaimer about this in the README or replace the library with another, that implements classic PID

Saur0o0n, 2022-01-31:
To be honest, I haven't give it much thoughts at theoretical level - just used and check if it works for me. If you have enough knowledge, can't you try to discuss it with the library author? Changing it (library) would require a lot of testing, much, much more then changing MAX library for example.

djObsidian, 2022-01-31:
That's a good idea, but this library is abandoned, its author isn't responding to issues for more than 4 years now

djObsidian, 2022-02-01:
Also, could you tell more about how did you tuned PID for your application?
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
None of these curves seems to be good.

Saur0o0n, 2022-02-01:
This are tries and errors on physical test stand (as described) - since those are low temp it was easy to to perform them on the bench. I haven't expect curve to match exactly the program, just close and without overheating. But on the other hand, I haven't give much reading on PID itself - just principles and what to expect. That's why I've used library - being kind of, end user for it and assuming it will work properly.
It was enough I've build my kilin and controller from scratch ;)
Do you have any particular, working PID literary in mind - that could replace this one? (just to take a look for now)

djObsidian, 2022-02-01:
That's a more complicated question than i thought initaly. There is
https://github.com/GyverLibs/GyverPID
But it has two issues:
1) It is documented only in russian
2) All code is written in header files, which is not a problem, but seems wrong

I'll look for other libraries

djObsidian, 2022-02-01:
Side question. How often sould this message appear in serial console?
https://github.com/Saur0o0n/PIDKiln/blob/87db341e9dfde9f5992bd66f55080c5b18152272/PIDKiln_program.ino#L534
I thought, that it should appear every time, `PID.Compute();` is called. But with different PID time window set, it's appearing with same frequency. Is this a correct behaivour?

Saur0o0n, 2022-02-01:
This is just the debug message, program is recalculated every second (from interrupts) - but since this message was printer so often it clogged the output/debug screen, so I've made it to be printed every 10th second.

djObsidian, 2022-02-01:
So, this means, time window for PID can't be lower than 1000 ms?

Saur0o0n, 2022-02-01:
Why? This is just debug information - PID is recalculated every 10ms (because I've introduced recently delay(10) - previously it was without it - but there where sometimes issues and watchdog killing process)

The pid recalculation is below this debug message, and it's done in main for() loop
https://github.com/Saur0o0n/PIDKiln/blob/87db341e9dfde9f5992bd66f55080c5b18152272/PIDKiln_program.ino#L541

djObsidian, 2022-02-08:
Okay, i'm starting to understand, why i failed in calculating PID parametrs.
Could you please clarify, how heater power is contolled? As i understand, there is something like a very slow PWM with frequency of 1 Hz or lower. But what is maximum value for PID output, and what is its resolution?

Saur0o0n, 2022-02-08:
In general yes, since we have only ON/OFF (no voltage regulation etc) and heating elements, of this power, does not exactly like to be on/off too fast (also electric grid safety does not like it, since there is often a spike) it should be done with decent window size. Since I've used SSR there is not big problem for it - but for mechanical relays - it would be also a death sentence.
Anyway, this "procedure" is straight from [example of the library](https://github.com/br3ttb/Arduino-PID-Library/blob/master/examples/PID_RelayOutput/PID_RelayOutput.ino).

djObsidian, 2022-02-12:
Well, finally i did it. I managed to setup PID for my kiln. I managed to get overshoot only around 4% (or 0.6% if we calculate in Kelvins). It took some simulation in Simulink, the realization that not all PID controller tuning approaches fit all systems, and suffering from the non-obviousness of the thing.
I can write some sort of guide, how i achieved this, if you are interested.
In short, I completely missed the response time of the thermocouple, which plays a very big role in my case. I have a 3.6 liter, 1.8 kW oven, which can reach a staggering 5 degrees per second at temperatures up to 800-900 degrees.

PID controller tuning methods can be divided into 2 categories: by transient response and by frequency response. And the first category, which I tried to use, does not work at all for systems with a delay in the output signal. Sure, kiln can be autotuned with this method https://github.com/br3ttb/Arduino-PID-AutoTune-Library
Or matlab closed loop PID tuner https://youtu.be/ENhFepqjFOY?t=156
It would be nice to have some form of autotuner in this project, but i'm not requesting it, it's requires a really good understanding of control theory and a hell lot of debugging, testing and simulation.

So, here's my model in Sumulink. Pretty straightforward, but i can explain it in details if you want me to write a guide.

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

And this is test on real kiln
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
It requieres some fine tuning, but is already very close to ideal result, so it will take no more than a day instead of weeks of manual tuning.

Some notes:

1. I've had to replace this
https://github.com/Saur0o0n/PIDKiln/blob/87db341e9dfde9f5992bd66f55080c5b18152272/PIDKiln_addons.ino#L117
With this
`kiln_temp=kiln_tmp1;`
Because when heating up at full power difference between Last temp  and Average kiln temp was more than 10 degrees. I think, it would be better to measure temperature in a separate task with low period like 100 ms and use a proper Kalman filter. Also this will make easier to change temp sensor. I'm trying to use MAX31856, which is superior to 31855 (at the almost same price) but has conversion delay of 100 ms or more depending on settings.
2. [Example from PID library](https://github.com/br3ttb/Arduino-PID-Library/blob/master/examples/PID_RelayOutput/PID_RelayOutput.ino) is ok but there is really no point in calculating PID more often than once per WindowSize. So PID sample time can be set to WindowSize or WindowSize/2
3. My initial statement that PID is untunable because of the way it calculates derivative is completely wrong. In fact it hardly even changes behaivour of PID.

Thread 16 (2022-02-23):

Auto-tuning?

TurboNerd95, 2022-02-23:
I have 2 of those cheap crappy PID controllers like this one https://www.auberins.com/index.php?main_page=product_info&products_id=4.

I've never bothered to try and tune my kilns manually, so I use their built in auto-tuning feature. It's not supposed to be very accurate, but it works find for my needs.

Have you considered maybe adding in the PID-auto-tuning library for Arduino? https://github.com/br3ttb/Arduino-PID-AutoTune-Library

I found one good example sketch of the auto-tuning library for a kiln here; https://www.megunolink.com/articles/malt-kiln/

Saur0o0n, 2022-02-28:
I've given some thought, during coding, about auto-tune. But, perhaps wrongly, I've assumed it's to big temperature scale (like 20C-1200C window) and too slow process to do reliable auto-tune. But I've assumed it without full understanding of autotune process.

TurboNerd95, 2022-08-02:
Hi, sorry for the late reply @pyr0ball .Adding autotune would be a really useful feature I think, so feel free to prototype it! From memory, the PIDautotune library requires about an hour to perform the Autotuning process. I think by following the example I linked, it would be quite easy to integrate it into this project, though I also don't have a great understanding of how PID works.

pyr0ball, 2022-08-06:
Thankfully @TurboNerd95, I've got a pretty decent amount of experience with heater PID tuning from my 3D printing. If I get stuck adding it to the project, would you mind if I reach out for assistance?

Thread 17 (2022-03-21):

Problem with compiling

Celahirek, 2022-03-21:
When trying to compile and upload the main files I get this error:
I installed all Required software. I'm very much a newbie so all help is appreciated.

> Arduino: 1.8.13 (Windows 10), Board: "ESP32 Wrover Module, Default 4MB with spiffs (1.2MB APP/1.5MB SPIFFS), QIO, 80MHz, 921600, None"

C:\Users\filip\Downloads\PIDKiln-1.3\PIDKiln\PIDKiln_http.ino: In function 'String Chart_parser(const String&)':

PIDKiln_http:337:32: error: 'class fs::File' has no member named 'path'

     if(CSVFile) return CSVFile.path();

                                ^

C:\Users\filip\Downloads\PIDKiln-1.3\PIDKiln\PIDKiln_http.ino: In function 'void GET_Handle_Delete(AsyncWebServerRequest*)':

PIDKiln_http:508:78: error: 'class fs::File' has no member named 'path'

   DBG dbgLog(LOG_DEBUG,"[HTTP] Opened file is %s, program name is:%s\n",tmpf.path(),p->value().c_str());

                                                                              ^

C:\Users\filip\Downloads\PIDKiln-1.3\PIDKiln\PIDKiln_http.ino: In function 'String handleVars(const String&)':

PIDKiln_http:649:32: error: 'class fs::File' has no member named 'path'

     if(CSVFile) return CSVFile.path();

                                ^

Multiple libraries were found for "PID_v1.h"

 Used: C:\Users\filip\Documents\Arduino\libraries\Arduino-PID-Library-master

 Not used: C:\Users\filip\Documents\Arduino\libraries\PID

Multiple libraries were found for "WiFi.h"

 Used: C:\Users\filip\AppData\Local\Arduino15\packages\esp32\hardware\esp32\1.0.6\libraries\WiFi

 Not used: C:\Program Files (x86)\Arduino\libraries\WiFi

exit status 1

'class fs::File' has no member named 'path'

This report would have more information with
"Show verbose output during compilation"
option enabled in File -> Preferences.
`

Saur0o0n, 2022-03-21:
What version of esp32 framework do you have? It's probably too old.

Celahirek, 2022-03-21:
> What version of esp32 framework do you have? It's probably too old.

Yeah it was. I updated it and it uploads but there is another problem. It is just stuck in a loop
Here is the serial monitor output:

Update SPIFFS...
Update sketch...
ets Jun  8 2016 00:22:57

rst:0xc (SW_CPU_RESET),boot:0x13 (SPI_FAST_FLASH_BOOT)
configsip: 0, SPIWP:0xee
clk_drv:0x00,q_drv:0x00,d_drv:0x00,cs0_drv:0x00,hd_drv:0x00,wp_drv:0x00
mode:DIO, clock div:1
load:0x3fff0030,len:1324
ho 0 tail 12 room 4
load:0x40078000,len:13508
load:0x40080400,len:3604
entry 0x400805f0
E (208) psram: PSRAM ID read error: 0xffffffff
[PREFS] Loading prefs from file[PREFS]  -> For WiFi_Retry_cnt saved UINT8 item value:9 type:1
[PREFS]  -> For WiFi_Mode saved UINT8 item value:1 type:1
[PREFS]  -> For HTTP_Local_JS saved UINT8 item value:1 type:1
[PREFS]  -> For Auth_Username saved STRING item value:admin type:4
[PREFS]  -> For Auth_Password saved STRING item value:hotashell type:4
[PREFS]  -> For NTP_Server1 saved STRING item value:0.pl.pool.ntp.org type:4
[PREFS]  -> For NTP_Server2 saved STRING item value:1.pl.pool.ntp.org type:4
[PREFS]  -> For NTP_Server3 saved STRING item value:2.pl.pool.ntp.org type:4
[PREFS]  -> For GMT_Offset_sec saved INT16 item value:3600 type:3
[PREFS]  -> For Daylight_Offset_sec saved INT16 item value:3600 type:3
[PREFS]  -> For Initial_Date saved STRING item value:2021-12-02 type:4
[PREFS]  -> For Initial_Time saved STRING item value:11:00:00 type:4
[PREFS]  -> For PID_Window saved UINT16 item value:5000 type:2
[PREFS]  -> For PID_Kp saved VFLOAT item value:20.000000 type:5
[PREFS]  -> For PID_Ki saved VFLOAT item value:0.200000 type:5
[PREFS]  -> For PID_Kd saved VFLOAT item value:0.100000 type:5
[PREFS]  -> For PID_Temp_Threshold saved INT16 item value:-1 type:3
[PREFS]  -> For LOG_Window saved UINT16 item value:30 type:2
[PREFS]  -> For LOG_Files_Limit saved UINT16 item value:40 type:2
[PREFS]  -> For DBG_Serial saved UINT8 item value:1 type:1
[PREFS]  -> For DBG_Syslog saved UINT8 item value:0 type:1
[PREFS]  -> For DBG_Syslog_Srv saved STRING item value:192.168.1.2 type:4
[PREFS]  -> For DBG_Syslog_Port saved UINT16 item value:514 type:2
[PREFS]  -> For MIN_Temperature saved UINT8 item value:10 type:1
[PREFS]  -> For MAX_Temperature saved UINT16 item value:1350 type:2
[PREFS]  -> For MAX_Housing_Temperature saved UINT16 item value:130 type:2
[PREFS]  -> For Thermal_Runaway saved UINT16 item value:0 type:2
[PREFS]  -> For Alarm_Timeout saved UINT16 item value:5 type:2
[PREFS]  -> For MAX31855_Error_Grace_Count saved UINT8 item value:5 type:1
[PREFS] -=-=-= PREFS DISPLAY =-=-=-[PREFS] 1) 'WiFi_SSID' = ''	4
[PREFS] 2) 'WiFi_Password' = ''	4
[PREFS] 3) 'WiFi_Mode' = '1'	1
[PREFS] 4) 'WiFi_Retry_cnt' = '9'	1
[PREFS] 8) 'HTTP_Local_JS' = '1'	1
[PREFS] 9) 'Auth_Username' = 'admin'	4
[PREFS] 10) 'Auth_Password' = 'hotashell'	4
[PREFS] 11) 'NTP_Server1' = '0.pl.pool.ntp.org'	4
[PREFS] 12) 'NTP_Server2' = '1.pl.pool.ntp.org'	4
[PREFS] 13) 'NTP_Server3' = '2.pl.pool.ntp.org'	4
[PREFS] 14) 'GMT_Offset_sec' = '3600'	3
[PREFS] 15) 'Daylight_Offset_sec' = '3600'	3
[PREFS] 16) 'Initial_Date' = '2021-12-02'	4
[PREFS] 17) 'Initial_Time' = '11:00:00'	4
[PREFS] 18) 'PID_Window' = '5000'	2
[PREFS] 22) 'PID_POE' = '0'	1
[PREFS] 23) 'PID_Temp_Threshold' = '-1'	3
[PREFS] 24) 'LOG_Window' = '30'	2
[PREFS] 25) 'LOG_Files_Limit' = '40'	2
[PREFS] 26) 'MIN_Temperature' = '10'	1
[PREFS] 27) 'MAX_Temperature' = '1350'	2
[PREFS] 28) 'MAX_Housing_Temperature' = '130'	2
[PREFS] 29) 'Thermal_Runaway' = '0'	2
[PREFS] 30) 'Alarm_Timeout' = '5'	2
[PREFS] 31) 'MAX31855_Error_Grace_Count' = '5'	1
[PREFS] 32) 'DBG_Serial' = '1'	1
[PREFS] 33) 'DBG_Syslog' = '0'	1
[PREFS] 34) 'DBG_Syslog_Srv' = '192.168.1.2'	4
[PREFS] 35) 'DBG_Syslog_Port' = '514'	2
WiFi mode: 1, Retry count: 9, is wifi enabled: 4
[NET] Y:2021 [NET] M:12 [NET] D:02 [NET] H:11 [NET] m:00 [NET] s:00
[NET] Creating WiFi Access Point (AP)192.168.10.1
[PRG] Loading directory...
[PRG]	counted 6 files
[PRG] Processing filename: program1.txt
Guru Meditation Error: Core  1 panic'ed (StoreProhibited). Exception was unhandled.

Core  1 register dump:
PC      : 0x4008b9fa  PS      : 0x00060830  A0      : 0x800daa91  A1      : 0x3ffb2620
A2      : 0x00000000  A3      : 0x3ffb2690  A4      : 0x000000ff  A5      : 0x0000ff00
A6      : 0x00ff0000  A7      : 0xff000000  A8      : 0x676f7270  A9      : 0x00000069
A10     : 0x00000000  A11     : 0x3ffd58f0  A12     : 0x3f401dd2  A13     : 0x3ffb2610
A14     : 0x3ffb25e0  A15     : 0x00000008  SAR     : 0x00000017  EXCCAUSE: 0x0000001d
EXCVADDR: 0x00000000  LBEG    : 0x4008b9ed  LEND    : 0x4008ba05  LCOUNT  : 0xffffffff

Backtrace:0x4008b9f7:0x3ffb26200x400daa8e:0x3ffb2630 0x400dac58:0x3ffb26d0 0x400db484:0x3ffb27b0 0x400ecea2:0x3ffb2820

ELF file SHA256: 0000000000000000

Rebooting...

Saur0o0n, 2022-04-09:
Either you did not upload data to spiffs storage on esp32 or you have wroom (not wrover) without psram.

Closed 2022-07-06.

Thread 18 (2022-05-31):

Not aborting at Maximum housing temperature

stminm, 2022-05-31:
For testing purposes I set Maximum housing temperature to 30C in Safety features but PIDKiln is not aborting the program run when the temperature gets above the set value.
In logs I see when the temperature above 30 but the expected "Aborting program with error: #" is not following after:
... 1 - PIDKiln-ESP32 PIDKiln - - - ‹¯¨[ADDONS] Temperature sensor B readout: Internal temp = 30.2     Last temp = 33.8     Average case temp = 32.7

To notice, other settings in Safety features:  Minimal temperature and Maximum temperature are triggering abortion of the program run when going below or above set values respectively.

Saur0o0n, 2022-05-31:
It's checked once every ten seconds - so it does not have to appear after temperature readout.

stminm, 2022-05-31:
Yes, I have noticed how often it's checked but still, no program abort when exceeded.

Meanwhile I was doing some troubleshooting and here is how I fixed:
In `PIDKiln.h`
```
/*
**  Program errors:
*/
typedef enum {
+ PR_ERR_HOUSE_HOT,       // exceeded max temperature defined in MAX_HOUS_TEMP
  PR_ERR_FILE_LOAD,       // failed to load file
...
```

In `PIDKiln_program.ino`
```
// Check all possible safety measures - if something is wrong - abort
//
void SAFETY_Check(){
  if(kiln_temp<Prefs[PRF_MIN_TEMP].value.uint8){
    DBG dbgLog(LOG_ERR,"[PRG] Safety check failed - MIN temperature < %d\n",Prefs[PRF_MIN_TEMP].value.uint8);
    ABORT_Program(PR_ERR_TOO_COLD);
  }else if(kiln_temp>Prefs[PRF_MAX_TEMP].value.uint16){
    DBG dbgLog(LOG_ERR,"[PRG] Safety check failed - MAX temperature > %d\n",Prefs[PRF_MAX_TEMP].value.uint16);
    ABORT_Program(PR_ERR_TOO_HOT);
-  }
+  }else if(case_temp>Prefs[PRF_MAX_HOUS_TEMP].value.uint16){
+    DBG dbgLog(LOG_ERR,"[PRG] Safety check failed - MAX house temperature > %d\n",Prefs[PRF_MAX_HOUS_TEMP].value.uint16);
+    ABORT_Program(PR_ERR_HOUSE_HOT);
+  }
}
```

Saur0o0n, 2022-05-31:
Ahh, sorry I haven't notice you are talking about housing max temperature - I thought your are talking about kiln max temperature. So you are right - there was no checking for housing max temperature at all. What you propose as fix looks ok.

Saur0o0n, 2022-07-06:
Added to 1.4 - closing.

Closed 2022-07-06.

Thread 20 (2022-07-01):

Alternative LCD's

pyr0ball, 2022-07-01:
Since the bare 12864B LCD's are becoming very difficult to find these days (due to the proliferation of RAMPS-style versions) would it be possible for you to include some support for the RAMPS-pinned version?

Another possible display I was considering was the SSD1309 OLED displays, if those could be made to work

Saur0o0n, 2022-07-06:
Hi,
It shouldn't be difficult to install RAMP 12864B (the one with sdcard and button) - it's all the same/similar hw, just perhaps controller is to be replaced in the code (but the display library will stay the same).
So fell free to experiment.
OLEDs display are to small to be useful (at least at my opinion) - and that's why I've chosen big (but low res) 128x64.

pyr0ball, 2022-07-12:
As I'm also using an alternative ESP carrier, would you be able to provide an example pinout for using the RAMPS LCD/SD/Encoder combo? That'll help immensely

pyr0ball, 2022-07-12:
found a reference!
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

I'll let you know how it goes!

pyr0ball, 2022-07-12:
OK I've nearly got it figured out, except for the CS pin for the SD Card, which isn't noted in your graphics since it's built into the module you've got

pyr0ball, 2022-07-16:
OK I think I figured out that the wiring for the unit you're using uses the SDcard in 4-bit mode, while that display's built-in sdcard is in SPI mode. I'm not super familiar with how to change that definition in your code. Any breadcrumbs you could provide?

Saur0o0n, 2022-07-16:
Hi,
I don't use SDCard in PIDKiln - only build in SPIFFS. And LCD is simple SPI interface - 4 wires only VSPI (MOSI-23, MISO-19, CLK-18, CS-5). Other LCD connections are for backlit and power.
After you figure out pins, you can change LCD type on the beginning of the PIDKiln_LCD.ino file
```
// You can switch hardware or software SPI interface to LCD. HW can be up to x10 faster - but requires special pins (and has some errors for me on 5V).
//U8G2_ST7920_128X64_F_SW_SPI u8g2(U8G2_R2, /* clock=*/ LCD_CLOCK, /* data=*/ LCD_DATA, /* CS=*/ LCD_CS, /* reset=*/ LCD_RESET);
U8G2_ST7920_128X64_F_HW_SPI u8g2(U8G2_R2, /* CS=*/ LCD_CS, /* reset=*/ LCD_RESET);
```

pyr0ball, 2022-07-18:
Gotcha, ok that just means that I'll have to add a different kind of sdcard reader with the 4 data lines and all that instead of using the reader baked into the LCD

pyr0ball, 2022-07-20:
derp I misunderstood that the SPIFFS filesystem was baked into the onboard SPI flash. I suppose SDCard could be used for some other features in future, but I'll just leave that for now.

I'll see if I can get this display working with SPI mode first, but I'll also wire up the data lines to allow 4-bit mode just in case

Thread 22 (2022-07-04):

here i go again having trouble compiling code  i get this error message?

Davereno22, 2022-07-04:
C:\Users\Dave\Documents\Arduino\libraries\PIDKiln\PIDKiln_http.ino: In function 'String Chart_parser(const String&)':
C:\Users\Dave\Documents\Arduino\libraries\PIDKiln\PIDKiln_http.ino:337:32: error: 'class fs::File' has no member named 'path'
     if(CSVFile) return CSVFile.path();
                                ^
C:\Users\Dave\Documents\Arduino\libraries\PIDKiln\PIDKiln_http.ino: In function 'void GET_Handle_Delete(AsyncWebServerRequest*)':
C:\Users\Dave\Documents\Arduino\libraries\PIDKiln\PIDKiln_http.ino:508:78: error: 'class fs::File' has no member named 'path'
   DBG dbgLog(LOG_DEBUG,"[HTTP] Opened file is %s, program name is:%s\n",tmpf.path(),p->value().c_str());
                                                                              ^
C:\Users\Dave\Documents\Arduino\libraries\PIDKiln\PIDKiln_http.ino: In function 'String handleVars(const String&)':
C:\Users\Dave\Documents\Arduino\libraries\PIDKiln\PIDKiln_http.ino:649:32: error: 'class fs::File' has no member named 'path'
     if(CSVFile) return CSVFile.path();
                                ^
Multiple libraries were found for "WiFi.h"
  Used: C:\Users\Dave\AppData\Local\Arduino15\packages\esp32\hardware\esp32\1.0.6\libraries\WiFi
  Not used: C:\Program Files (x86)\Arduino\libraries\WiFi
exit status 1

Compilation error: 'class fs::File' has no member named 'path'

Saur0o0n, 2022-07-06:
Hi,
Update your ESP32 framework - you are using 1.0.6 and it's clearly stated in requirements 2.0.x is needed.

Thread 23 (2022-07-25):

Compilation error with v1.3

JensBovbjergdk, 2022-07-25:
When trying to upgrade my system to v1.3 I get the following error: undefined reference to `mbedtls_md5_starts'
I am using ESP32 framework 2.0.0 but also 2.0.4 gives the same error.  I am using a Wrover Module.
Any suggestionens ?

Saur0o0n, 2022-07-25:
How do you try to upgrade it? With OTA?

JensBovbjergdk, 2022-07-25:
No with the arduino IDE Version: 2.0.0-rc3

Den man. 25. jul. 2022 kl. 12.57 skrev Adrian Siemieniak <
***@***.***>:

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

Saur0o0n, 2022-07-25:
My question was on OTA - since the error was on TLS. You should then probably also update other libraries - most likely  ESPAsyncWebServer and asynctcp.

JensBovbjergdk, 2022-07-25:
Ok, thanks. I will try this.

Den man. 25. jul. 2022 kl. 13.11 skrev Adrian Siemieniak <
***@***.***>:

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

JensBovbjergdk, 2022-07-25:
Thanks again, that did the trick👍.
Please consider my other issue with abort over 1100 😀

Kind regards
Jens

Den man. 25. jul. 2022 kl. 13.11 skrev Adrian Siemieniak <
***@***.***>:

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

Closed 2024-02-09.

Thread 24 (2022-07-25):

Problems with temperatures above 1100 degC

JensBovbjergdk, 2022-07-25:
My Kiln controller works very well up to 1100 degC. But even with the Grace counter sat to 100, the program still aborts above 1100.
By looking at the Syslog, this is because the counter increases more than it decreases, and eventually reaches 100.
The temperature measurements continue to be valid though, even if there are more fails than good readings.
I therefore suggest that the Grace Counter is replaced by a Grace Timer.
That is: The program only aborts if no valid readings are obtained in a Grace Period of x minutes.
Hope this makes sense and thanks for the good work.
Kind regards
Jens

djObsidian, 2022-07-31:
This is probably an EMC problem. I did also encountered this. Surprisingly, there was no errors when heater was off.
Quick fix is to change
https://github.com/Saur0o0n/PIDKiln/blob/b9da27c5f9b2d874825d29ed0e71314416a40b97/PIDKiln_addons.ino#L119
to
`if(TempA_errors>0) TempA_errors=0;`
I think the problem is that max31855 reading occurs on the same time when SSR is on, so that sould be avoided and measurement taken at the end of time window, not at start

Saur0o0n, 2022-07-31:
It's true that there is a lot of interference - so the good practice is to shield entire controller and ground it. This helped me in many other projects.
I still find the zeroing errors count a questionable practice (this may lead to quite wrong temp readouts and fail the whole program. Imagine that while having 1000C in kiln, the probe is having a lot of errors and the true read is possible one time per minute (1/60) and this readout is wrong - like suddenly it reads 900C or 1100C - what is possible - this ruins the whole task).

Thread 26 (2022-08-25):

Please consider porting to PlatformIO ( Can provide assistance)

pyr0ball, 2022-08-25:
Given there's a number of library dependencies that are required for this project to work, and it seems versioning is also relevant among those dependencies, I think it's a good idea to start working under a PlatformIO project where dependent libraries can have fully automated installation and management.

I'm happy to help with this if desired! I was about to create my own fork with extra features as well, but wanted to make sure I'm sticking to a platform you, as the original dev, are comfortable with.

Saur0o0n, 2022-08-25:
Fell free to commit platformio.ini file - I was working Code it with 3d printer Marlin fw, but somehow had not need to switch. Perhaps now is the chance ;)

pyr0ball, 2022-08-25:
Okipokey! I'll carve out some time to do this next week.

I just finished assembling my custom controller PCB, so we'll see how it goes ;)
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

Saur0o0n, 2022-08-25:
I see MOSFETts - so this is for some low (like lower then kilowatts) power solution?

pyr0ball, 2022-08-25:
those two fets are for fan control. I plan on having one cooling the SSR's heatsink, and another for maybe a recirculation fan (as this controller could also be adapted for something like a reflow oven)

I've also added an extra SSR and EMR output for kilns like one of mine that has dual independent coils. All of those outputs are opto-couple isolated.

There's also a header for running a Neopixel (WS281x) LED strip (mainly just for bling, but this could be used for status indicators or all kinds of other things)

The two 10-pin headers are basically just mapped for 3D Printer controller LCD's so any displays that work with that style of connection can theoretically be used. I've chosen to go with the RepRapDiscount Full Graphic Smart controller as they're prolific and cheap and use the same display as the one you're originally using.

Next rev adds 5x GPIO pins for other stuff like a door switch (mentioned by another user in a different issue) or could be used for external physical buttons, a case thermistor input, or even get tied in with a smoke/gas detector for automatic shutoff. I'm also planning on migrating the EMR gate pin to somewhere else so we can take advantage of the I2C bus and maybe get a little extra feature-ability like maybe some current detection IC's. Another thing I would love to add would be support for the SSD1309 displays as a secondary informational output showing things like the the actual heater coil resistance, current power metrics like voltage and wattage etc so that all can be tracked. I believe with that data I could add in a maintenance detection feature or a "remaining health" meter for the coils so the user knows when it's time to get them replaced.

pyr0ball, 2022-08-26:
@Saur0o0n would it be possible for you to open up a `develop` branch for me to do my pull requests against?

Saur0o0n, 2022-08-27:
Hi,
I've created platformio branch (https://github.com/Saur0o0n/PIDKiln/tree/platformio)

djObsidian, 2022-08-27:
Wow, that's a great one PCB. I also designed my own, as a replacement for Rex C-100.
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

Porting this project to PlatformiO is a good idea. But refactoring and splitting code into several files as for arduino IDE would take some time. I ported for myself by simply throwing all code into main.c and declaring all functions in main.h. Not really convinient for writing and editing code but compiles like 10 times faster than in Arduino IDE.

My platformio.ini looks like this. ESP32 in PIO is not still updated to Arduino Core 2.0 so it was a bit tricky to configure.

```[env:esp32dev]
platform = https://github.com/platformio/platform-espressif32.git#feature/arduino-upstream
board = esp32dev
framework = arduino
platform_packages = framework-arduinoespressif32@https://github.com/espressif/arduino-esp32.git
lib_deps =
	adafruit/Adafruit MAX31856 library@^1.2.5
	adafruit/Adafruit BusIO@^1.11.1
	Wire
	SPI
	br3ttb/PID @ ^1.2.1
	olikraus/U8g2@^2.33.2
	arcao/Syslog @ ^2.0.0
monitor_speed = 115200

pyr0ball, 2022-08-28:
Well that's a heck of a lot of work you've already done! If you are up to doing a PR on that new branch with your current refactor, I can work on the file segregation while I'm adding the other features

djObsidian, 2022-08-28:
I made a PR, you can check it out

HeintzelmannDK, 2024-11-02:
Did any of you ever make a PlatformIO version?

Saur0o0n, 2024-11-02:
djObsidian made a PR, but never finished it. I kind of never fully switched to PIO, so had not big interest in it.

HeintzelmannDK, 2024-11-02:
> platform_packages = framework-arduinoespressif32@https://github.com/espressif/arduino-esp32.git

Ok. Thanks for the quick reply.

Thread 31 (2022-10-05):

"File not found" when connected

masterjuggler, 2022-10-05:
I just went through the installation process on my esp32-wroom-32e. Everything compiled and uploaded without issue on the latest arduino ide. When I connect to the resulting "PIDKiln_AP" and enter the default ip 192.168.10.1 into a browser all I get is a blank page that says "file not found"

Am I just not connecting to it correctly? I didn't see anything on the wiki that mentions another way.

Saur0o0n, 2022-10-05:
Seems like did not upload the data to your Esp SPIFFS or you put something strange in URL after the IP address.

masterjuggler, 2022-10-05:
Alright, I finally managed to figure it out. It doesn't seem like arduino ide 2.0.0 has no support for plugins like esp32fs, so I had to grab 1.8.19 and that worked.

Closed 2022-12-30.

Thread 32 (2022-12-31):

Temperature readings are far out and unstable

atlantis777, 2022-12-31:
Hi Adrian

I have contacted you about this by email and as you suggested I now open an issue here.

To show you what I meant with the readings being unstable I took a short video from the main view on the lcd. This unstableness does also show in the web view. The case temperature was stable this time but the inside and ambient temps were not. I'm not sure if the case temp was also unstable last time or not. The kiln was cold at the time so the values of all readings are far out.

Furthermore I attached two logs, one of a program of yours and one of a program of mine. Please tell me what further info I can provide.

Kind regards
Martin

[221231_123252.log](https://github.com/Saur0o0n/PIDKiln/files/10327264/221231_123252.log)
[221231_123745.log](https://github.com/Saur0o0n/PIDKiln/files/10327265/221231_123745.log)

https://user-images.githubusercontent.com/51721346/210135747-9ab9888d-b483-4ad7-8e24-23a9041a4ea9.mov

Saur0o0n, 2023-01-02:
So there is no way, this temperature changes could happen so fast on normal circumstances. The fact, it's not even showing proper temperature - makes me wander, if you simply don't have wrong/faulty max chip and/or connection issue (or perhaps no K thermocouple). In this case, I would load simple sketch for MAX6675 (from examples - like MAX6675_hw_SPI_Demo) and make it work first.

And btw. by "send some logs" I meant serial output of Pidkiln - not running program log :). In those serial logs (or syslog if you forward them) you will see actual readouts and values.

atlantis777, 2023-01-03:
Well of course it could be possible that both MAX6675 are damaged but it's rather unlikely I guess, unfortunately I don't have spares at the moment but have to order some first. I think I made some kind of mistake but I don't seem to find it, I re-checked the wiring etc. and it looks ok but there's always the possibility that I don't see the forest for the trees. Please describe how I take those serial logs if they're helpful, sorry that I misunderstood.

Saur0o0n, 2023-01-03:
So if MAX6675 would be wrongly connected, it should not be responding at all - this is digital communication. So more likely is something else. Disable all other thermocouples and leave only main, kiln one (disable it in Pidkiln and disconnect electrically). Run some test program and check if temperature is stable, if not - change thermocouple (physically - MAX6675 leave the same) and re try. To eliminate thermocouple issue, MAX6675 interference issues on SPI line etc.
And like I said - you should make thermocouple/MAX6675 work first without Pidkiln, it's not Pidkiln issue here.

atlantis777, 2023-01-09:
Didn't I say I must have overlooked something and so it was. The thermocouple boards I had installed had the MAX6675 on instead of the MAX31855. I was lucky enough to find a 31855 board in another device that I could borrow for a test and with that the kiln heated up and the readings made sense. So I ordered a few boards with the right IC on...

However I had two other issues when testing:

- Sometimes when navigating the menu the lcd went blank. In the background it looked like the controller was still working but the gui didn't come back. I guess this is a problem with either the lcd itself or the lcd comms.
- I had problems transferring program files with the names of "Nanovia_old.txt" and "Nanovia_new.txt". Both were rejected for bad filenames. "Nan_old.txt" and "Nan_new.txt" worked in the end and "Linkcast_small.txt", "Linkcast_medium.txt" and "Linkcast_large.txt" had all not been rejected either.

Saur0o0n, 2023-01-09:
On filenames - limit is 32 characters, directory name included (it's a SPIFFS limit). I'm not sure if this is the case - but serial debug output should give you the hint where the problem may be - if there is any.

Thread 33 (2023-03-05):

after sketch upload, program starts and constantly restarting

ggioorgi, 2023-03-05:
board: esp32-wroom-32D

serial

rst:0x1 (POWERON_RESET),boot:0x13 (SPI_FAST_FLASH_BOOT)
configsip: 0, SPIWP:0xee
clk_drv:0x00,q_drv:0x00,d_drv:0x00,cs0_drv:0x00,hd_drv:0x00,wp_drv:0x00
mode:DIO, clock div:1
load:0x3fff0018,len:4
load:0x3fff001c,len:1044
load:0x40078000,len:10124
load:0x40080400,len:5856
entry 0x400806a8
E (218) psram: PSRAM ID read error: 0xffffffff
[PREFS] Loading prefs from file[PREFS]  -> For WiFi_Retry_cnt saved UINT8 item value:9 type:1
[PREFS]  -> For WiFi_Mode saved UINT8 item value:1 type:1
[PREFS]  -> For HTTP_Local_JS saved UINT8 item value:1 type:1
[PREFS]  -> For Auth_Username saved STRING item value:admin type:4
[PREFS]  -> For Auth_Password saved STRING item value:hotashell type:4
[PREFS]  -> For NTP_Server1 saved STRING item value:0.pl.pool.ntp.org type:4
[PREFS]  -> For NTP_Server2 saved STRING item value:1.pl.pool.ntp.org type:4
[PREFS]  -> For NTP_Server3 saved STRING item value:2.pl.pool.ntp.org type:4
[PREFS]  -> For GMT_Offset_sec saved INT16 item value:3600 type:3
[PREFS]  -> For Daylight_Offset_sec saved INT16 item value:3600 type:3
[PREFS]  -> For Initial_Date saved STRING item value:2021-12-02 type:4
[PREFS]  -> For Initial_Time saved STRING item value:11:00:00 type:4
[PREFS]  -> For PID_Window saved UINT16 item value:5000 type:2
[PREFS]  -> For PID_Kp saved VFLOAT item value:20.000000 type:5
[PREFS]  -> For PID_Ki saved VFLOAT item value:0.200000 type:5
[PREFS]  -> For PID_Kd saved VFLOAT item value:0.100000 type:5
[PREFS]  -> For PID_Temp_Threshold saved INT16 item value:-1 type:3
[PREFS]  -> For LOG_Window saved UINT16 item value:30 type:2
[PREFS]  -> For LOG_Files_Limit saved UINT16 item value:40 type:2
[PREFS]  -> For DBG_Serial saved UINT8 item value:1 type:1
[PREFS]  -> For DBG_Syslog saved UINT8 item value:0 type:1
[PREFS]  -> For DBG_Syslog_Srv saved STRING item value:192.168.1.2 type:4
[PREFS]  -> For DBG_Syslog_Port saved UINT16 item value:514 type:2
[PREFS]  -> For MIN_Temperature saved UINT8 item value:10 type:1
[PREFS]  -> For MAX_Temperature saved UINT16 item value:1350 type:2
[PREFS]  -> For MAX_Housing_Temperature saved UINT16 item value:130 type:2
[PREFS]  -> For Thermal_Runaway saved UINT16 item value:0 type:2
[PREFS]  -> For Alarm_Timeout saved UINT16 item value:5 type:2
[PREFS]  -> For MAX31855_Error_Grace_Count saved UINT8 item value:5 type:1
[PREFS] -=-=-= PREFS DISPLAY =-=-=-[PREFS] 1) 'WiFi_SSID' = ''	4
[PREFS] 2) 'WiFi_Password' = ''	4
[PREFS] 3) 'WiFi_Mode' = '1'	1
[PREFS] 4) 'WiFi_Retry_cnt' = '9'	1
[PREFS] 8) 'HTTP_Local_JS' = '1'	1
[PREFS] 9) 'Auth_Username' = 'admin'	4
[PREFS] 10) 'Auth_Password' = 'hotashell'	4
[PREFS] 11) 'NTP_Server1' = '0.pl.pool.ntp.org'	4
[PREFS] 12) 'NTP_Server2' = '1.pl.pool.ntp.org'	4
[PREFS] 13) 'NTP_Server3' = '2.pl.pool.ntp.org'	4
[PREFS] 14) 'GMT_Offset_sec' = '3600'	3
[PREFS] 15) 'Daylight_Offset_sec' = '3600'	3
[PREFS] 16) 'Initial_Date' = '2021-12-02'	4
[PREFS] 17) 'Initial_Time' = '11:00:00'	4
[PREFS] 18) 'PID_Window' = '5000'	2
[PREFS] 22) 'PID_POE' = '0'	1
[PREFS] 23) 'PID_Temp_Threshold' = '-1'	3
[PREFS] 24) 'LOG_Window' = '30'	2
[PREFS] 25) 'LOG_Files_Limit' = '40'	2
[PREFS] 26) 'MIN_Temperature' = '10'	1
[PREFS] 27) 'MAX_Temperature' = '1350'	2
[PREFS] 28) 'MAX_Housing_Temperature' = '130'	2
[PREFS] 29) 'Thermal_Runaway' = '0'	2
[PREFS] 30) 'Alarm_Timeout' = '5'	2
[PREFS] 31) 'MAX31855_Error_Grace_Count' = '5'	1
[PREFS] 32) 'DBG_Serial' = '1'	1
[PREFS] 33) 'DBG_Syslog' = '0'	1
[PREFS] 34) 'DBG_Syslog_Srv' = '192.168.1.2'	4
[PREFS] 35) 'DBG_Syslog_Port' = '514'	2
WiFi mode: 1, Retry count: 9, is wifi enabled: 4
[NET] Y:2021 [NET] M:12 [NET] D:02 [NET] H:11 [NET] m:00 [NET] s:00
[NET] Creating WiFi Access Point (AP)192.168.10.1
[PRG] Loading directory...
[PRG]	counted 6 files
[PRG] Processing filename: program1.txt
Guru Meditation Error: Core  1 panic'ed (StoreProhibited). Exception was unhandled.

Core  1 register dump:
PC      : 0x4008b9fa  PS      : 0x00060830  A0      : 0x800daa91  A1      : 0x3ffb2620
A2      : 0x00000000  A3      : 0x3ffb2690  A4      : 0x000000ff  A5      : 0x0000ff00
A6      : 0x00ff0000  A7      : 0xff000000  A8      : 0x676f7270  A9      : 0x00000069
A10     : 0x00000000  A11     : 0x3ffd55b8  A12     : 0x3f401dd2  A13     : 0x3ffb2610
A14     : 0x3ffb25e0  A15     : 0x00000008  SAR     : 0x00000012  EXCCAUSE: 0x0000001d
EXCVADDR: 0x00000000  LBEG    : 0x4008b9ed  LEND    : 0x4008ba05  LCOUNT  : 0xffffffff

Backtrace:0x4008b9f7:0x3ffb26200x400daa8e:0x3ffb2630 0x400dac58:0x3ffb26d0 0x400db484:0x3ffb27b0 0x400ecea2:0x3ffb2820

ELF file SHA256: 0000000000000000

Saur0o0n, 2023-03-05:
What esp framework version do you have?

ggioorgi, 2023-03-06:
1.0.6 version

I delete all files in 'programs' folder and restarting stop after fresh install. I open web interface, it reads temps, but can't write any data, when upload one program, same thing happened and start restarting loop with same error

ggioorgi, 2023-03-06:
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

ggioorgi, 2023-03-06:
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

Saur0o0n, 2023-03-06:
Did you change the settings for Wroom (default is Wrover) - the wroom chips doesn't have psram.
https://github.com/Saur0o0n/pidkiln/wiki/PIDKiln-hardware-components

ggioorgi, 2023-03-06:
yes I change that

ggioorgi, 2023-03-06:
I tried to change many things, nothing helps. Maybe my board is damaged, i'll try another board. I will buy exactly the board you have.

ggioorgi, 2023-03-06:
Ok now I installed another program that also writes and uses the files and it works fine. Your program gives me an error when it needs to write or read from memory. But is better buy new board which I know will work, instead of change program.

Saur0o0n, 2023-03-06:
I think it's the esp framework - that's why I've asked for it's version. Please try a bit older one like 1.0.4 - they have changed a lot at some point with file handling on SPIFFS (https://github.com/Saur0o0n/PIDKiln/issues/10#issuecomment-972815240). I'll have to compile it later with newest one and check it for myself.

ggioorgi, 2023-03-06:
I try 1.0.3 and 1.0.4 versions. same error.

Saur0o0n, 2023-03-07:
Hmm,
At this point - I don't have idea of the common problem here. Unless you did something wrong with spiffs formatting.
You can decode your Guru Meditation error - but it has to be on your binaries/compilation (I can't do that):
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
And send the output back.

Closed 2024-02-09.

Thread 34 (2023-03-17):

overshoot and used power calculation

rmPscr, 2023-03-17:
Hello and, firstly, congratulations and thanks for the work with this, it's really great!

I have a small issue with my controller only going to the next step after about a minute or so, which sometimes results in an overshoot (because for one minute beyond set time for next step it keeps the heating ramp going), such as in the picture (I changed the skin a bit...).

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

As you can see, at around 17.04 hour mark it should have started a slower ramp, but instead it continued the rate of rise for another minute, going 20° over, then allowing to cool and continuing. Do you know why this might be? I haven't found it in the code... (even tho the actual temperature line appears above the set temperature line, the kiln never overshoots on ramps -- visually, it has to do with the tension of the chart lines, which I changed to 0 since; I'm sure because I was monitoring the temperatures live).

Thanks!

p.s. I have an ACS712 power meter, which is not really accurate and was more of a nuisance than a help so I removed it. But I still want to know, at least with some approximation, how much power I used, so I implemented a software power meter based on mains voltage and kiln power, as a backup to a power meter. Not perfectly accurate, but does the job better than a cheapo power meter.

If there is a power meter, then use it, else use software calculation:
 - added 2 more fields in the preferences where one can input their mains voltage and kiln power in watts
 - based on kiln power I calculate the coil resistance
 - based on coil resistance and mains voltage I can check how much amps it draws
 - based on amps, pid_out and sample time I can calculate energy consumption

Saur0o0n, 2023-03-20:
Hi,
Starting from bottom...
Letters fixed - true, those are not common in my language so I kind of forgot about them :)
Power metering is currently rudimentary, I've added it because I had a coil to measure current draw and wanted to test it - but without voltage measurement it's ... quite useless in terms of actual power measurement, it more like allows to check if the heating elements is acutely working or not :).

On the overshoot problem. I understand you actually referring to temperature overshoot - not the graph showing it wrongly right? (since you mentioned graph pressure).
PID is recalculated every second, but the heating element is updated (on/off) every 5th second (PRF_PID_WINDOW) - since those big ones, don't like to be on/off too often. If you see overshoot in longer period of time, I would say that PID is set so. But I must admit, that that spike is quite interesting. Do you have program logs?

rmPscr, 2023-03-20:
Hi and thanks for the reply.

At some point I was looking online for filename validator tools because I could not understand why I couldn't upload a file named simply... bisque.txt :). The absolute last thing I tried was to check the code for allowed characters...

No, unfortunatelly I don't have the program logs from that firing because since then I changed code and re-uploaded (the power consumtion code), thus deleting all logs from the esp..., also debug was off... but I did check them and there was nothing apparently wrong (so I didn't think to save them), just that it went to the next step a bit more than a minute after set time. Not only where the graph shows the spike, but also on the next one, where it was supposed to start dwell at 1000°, and the next, on cooldown. Its a much smaller 'spike' because the ramp slope was smaller, more difficult to see with the chart line width, but it still went over maybe 6° at around the 18:00 hour mark:
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

My fear is that if I have to burn something at close to the limits of my kiln, in an even longer program (10-12 hours), this overshoot (in time actually) will bring the temperature to higher than the materials in the kiln are rated for.

But in my case I changed your code a bit to read TC and compute PID 4times/sec, 250ms being what the max31855 can handle, and changed the window to 2.5 seconds -- the SSR can handle even 1 sec window time in my experience, with 1% on-time being 10ms which is half period at 50Hz, and that is the minimum window that makes sense with a zero-crossing SSR. I did it because I have a small homemade kiln (oven really) with a lower inertia than the big ones and only 2.4kW power at 20°C (2.2kW at 900°) and I use it also as a heat treat oven at lower temperatures (850°) where I need faster response because I open the door.

So I changed the interrupt to 250ms. Everything else stays the same in the program loop (functions called every 1 second are still called every 1second, same with functions called every 10 seconds) -- this is by resetting cnt1 counter at 39 instead of 9 and calling the one second functions every (cnt1+1)%4==0). But cnt1 is a local variable, right?, so it shouldn't mess anything else up... In short, KilnPID.Compute() and Update_TemperatureA() every 250ms, Program_calculate_steps(), LCD_display_mainv1() and SAFETY_Check() every 1s and the rest every 10s.

I realise that messes up things a bit but is 1 minute over mark after 6h30m exagerated? Also, if I check the window time every 250ms instead of 1s than actual window size is even closer to the 2500ms set time...

So why is the controller continuing with a rate of rise in temperature even after the set temperature was reached? For example, at 17:04 it was supposed to be 945°, instead, calculate steps set it at 965°. This is not a temperature overshoot (as in, PID related) -- it's a time overshoot (which based on ramp slope translates in a temperature overshoot), right?

My only explanation is that by doing what I did, I either messed up something with the Program_calculate_steps(), even if it is still called every second; or there is a more general timing issue (a millisecond is not a millisecond). This only happend with a long pottery firing schedule, it doesn't really happen with short ramp-ups to temp and dwell, so I suspect a desync somewhere that adds up in time. The LCD is also updated every second, except its not exactly every second, if it were, on screen1 I wound see the time changing every second, but sometimes it skips, quite often actually.

I realise this is probably something I did -- voiding the warranty by messing with your program :) -- but I was curios if you or anyone else had this time overshoot issue on long firing schedules.

Thanks!

Thread 36 (2023-04-21):

Are there still issues with filesystem? Chart not showing

astern1, 2023-04-21:
Hi,

I'm just searching for a kiln control and came along, looks very great, thanks a lot for that!
Unfortunately I can't get it running properly.
I tried with WROM and Wrover Board but with both I get a similar failure like https://github.com/Saur0o0n/PIDKiln/issues/11
Config for the PSRAM was done properly, I can also upload own txt files as profiles, they show up in the list (via webfrontend as well as via Sketch uploader in Arduino IDE)

So main view is empty, when I click on a profile to load it it's like nothing happens.
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

Also the Debug output looks very weird:
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

Same for preferences:
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

Arduino IDE I'm using is 1.8.19
esp32 I tried a lot, 2.0.8 | 2.0.1 | 1.0.4 and so on...
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

Any suggestions what to try?

Saur0o0n, 2023-04-21:
Hi,
Check https://github.com/Saur0o0n/pidkiln/wiki/Required-software - look for ~ :)

astern1, 2023-05-18:
Seems like it ewas an error during saving of the WebResponseImpl.h

Thanks!

Thread 37 (2023-05-18):

Changing PIN for MAX31855

astern1, 2023-05-18:
Hi,

I can not use PIN14 anymore because it is broken on my test WROVER.
I checked but it seems the used pins are hardcoded in the MAX31855 library, correct?

Is there a possibility to change it or maybe better question: where can ich change it, couldn't find it.

P.S.: tried wit Adafruit and the MAX Example, using
// Example creating a thermocouple instance with software SPI on any three
// digital IO pins.
#define MAXDO   12
#define MAXCS   27
#define MAXCLK  13

worked so I would like to change it in PIDKiln

Thanks

Saur0o0n, 2023-05-18:
On esp32 chip you have 2 hardware SPI buses - so you can't change it's pin freely (it's mentioned in PIDKiln docs). PIDKiln uses 2 spi's - one for the LCD, another for MAX boards. You could change it to software SPI - but  you would have to do it on your own.

Closed 2023-07-17.

Thread 38 (2023-05-24):

Guru Meditation Error: Core  1 panic'ed (StoreProhibited)

codilau, 2023-05-24:
Hello, thanks for the great work, I love yout project for its light weigth and use of the great ESP32, coming from a PID based on PicoReflow, running on the hard to find Rpis I can really appreciate our cheap light Esps.

I ran into a problem though and can't wrap my head around it. As the title suggests, execution halts with this error at the moment on loading a program, either from the SPIFFS or from the web interface.

192.168.1.110
[PRG] Loading directory...
[PRG]	counted 2 files
[PRG] Processing filename: index.html
[PRG] Processing filename: program1.txt
Guru Meditation Error: Core  1 panic'ed (StoreProhibited). Exception was unhandled.

Core  1 register dump:
PC      : 0x4008a6f2  PS      : 0x00060130  A0      : 0x800da3b5  A1      : 0x3ffb2620
A2      : 0x00000000  A3      : 0x3ffb2690  A4      : 0x000000ff  A5      : 0x0000ff00
A6      : 0x00ff0000  A7      : 0xff000000  A8      : 0x676f7270  A9      : 0x00000069
A10     : 0x00000000  A11     : 0x3ffd6bbc  A12     : 0x3f401dfd  A13     : 0x3ffb2610
A14     : 0x3ffb25e0  A15     : 0x00000008  SAR     : 0x0000001e  EXCCAUSE: 0x0000001d
EXCVADDR: 0x00000000  LBEG    : 0x4008a6e5  LEND    : 0x4008a6f9  LCOUNT  : 0xffffffff

Backtrace:0x4008a6ef:0x3ffb26200x400da3b2:0x3ffb2630 0x400da560:0x3ffb26d0 0x400dad84:0x3ffb27b0 0x400eb7e2:0x3ffb2820

I traced this back with the exception decoder:

PC: 0x4008a6f2
EXCVADDR: 0x00000000

PC: 0x4008a6f2
EXCVADDR: 0x00000000

Decoding stack results
0x400da3b2: Load_programs_dir() at D:\1.PROG\PIDKiln/PIDKiln_program.ino line 157
0x400da560: Generate_INDEX() at D:\1.PROG\PIDKiln/PIDKiln_http.ino line 204
0x400dad84: setup() at D:\1.PROG\PIDKiln/PIDKiln.ino line 166
0x400eb7e2: loopTask(void*) at C:\Users\alexl\AppData\Local\Arduino15\packages\esp32\hardware\esp32\2.0.4\cores\esp32\main.cpp line 42

The culprit seems to be

0x400da3b2: Load_programs_dir() at D:\1.PROG\PIDKiln/PIDKiln_program.ino line 157
which is this line:

 strcpy(Programs_DIR[Programs_DIR_size].filename,tmp);

But that's where my knowledge ends.
Any ideas to make this work?

Closed 2023-05-25.

Thread 40 (2023-06-15):

Q; Control 2 heaters using just one PIDKiln?

ilgrank, 2023-06-15:
Hi
This is  question (not an issue): is it possible to use PIDKiln to control an oven with two (one upper, one lower) indipendent heaters?
Thanks!

Saur0o0n, 2023-06-15:
Yes,  you can - it's still enabled at the same time, but it can have different/independant power source.
```/*
** Relays and thermocouple defs. and other addons
**
*/

#define EMR_RELAY_PIN 21
#define SSR1_RELAY_PIN 19
//#define SSR2_RELAY_PIN 22   // if you want to use additional SSR for second heater, uncoment this
```

ilgrank, 2023-06-21:
and that's true even for a second temperature sensor?

Saur0o0n, 2023-06-24:
Hi, nope - as I said, they act as a single heater but with two separated power sources. And there is only single temperature sensor for kiln interior - other sensor is for outside temperature.

Closed 2024-02-09.

Thread 41 (2023-07-08):

Cannot compile: redefinition of 'class IPv6Address

videobuff, 2023-07-08:
Cannot compile

System: ESP-WROOM-32
Arduino on line IDE

Reinstalled new development with Arduino online coding.
Imported the sketch.
I get errors complaining "redefinition of 'class IPv6Address"

```
In file included from /home/builder/Arduino/libraries/ethersia_2_4_0/src/IPv6Packet.h:11,
from /home/builder/Arduino/libraries/ethersia_2_4_0/src/UDPSocket.h:10,
from /home/builder/Arduino/libraries/ethersia_2_4_0/src/Syslog.h:9,
from /tmp/437171178/PIDKiln/PIDKiln.h:2,
from /tmp/437171178/PIDKiln/PIDKiln.ino:35:
/home/builder/Arduino/libraries/ethersia_2_4_0/src/IPv6Address.h:27:7: error: redefinition of 'class IPv6Address'
class IPv6Address {
```

Saur0o0n, 2023-07-10:
It looks like you should uninstall that ethersia library.

videobuff, 2023-07-10:
I will try to do so but so far it is not listed in the IDE. I  went back to version 1.8.9 I believe an that one compilesVerstuurd vanaf mijn telefoonOp 10 jul. 2023 om 09:43 heeft Adrian Siemieniak ***@***.***> het volgende geschreven:
It looks like you should uninstall that ethersia library.

—Reply to this email directly, view it on GitHub, or unsubscribe.You are receiving this because you authored the thread.Message ID: ***@***.***>

Closed 2023-07-17.

Thread 42 (2023-07-13):

Programme does not start from webpage

videobuff, 2023-07-13:
I hope you will help me one more time.
I can now compile the sketch on Arduino IDE 1.8.9. No errors.
And i do get output on my serial port.
I have modified the /etc/pidkiln.conf file, and after startup i am connected to my network.
I can open up the webpage with your standard username and password.

However, after i load a programme from manage programs (no 3) , nothings is shown on the webpage.

This is the log output:

`Program name: test_lowtemp.txt
Program desc: Program to test low temperatures
Started at: 2023-07-13 09:48:59
Possible end at: 2023-07-13 11:28:59
PID values. Kp:20.00 Ki:0.20 Kd:0.10
Start temperature: 27.3C
CSV filename: 2023-07-13 11:28:59
-=-=-= Starting program =-=-=-=-`

I am using an ESP WROOM32 with no PSRAM and have adapted the sketch

`// If you have Wrover with PSRAM
//#define MALLOC ps_malloc
//#define REALLOC ps_realloc

// if you have Wroom without it - this is what I have
#define MALLOC malloc
#define REALLOC realloc
`
Can you give me some clues what else i can do ?

I have attached a number of screenshots.....

Thanks in advance

Erik

Below is the startup output on the serial console.

`clk_drv:0x00,q_drv:0x00,d_drv:0x00,cs0_drv:0x00,hd_drv:0x00,wp_drv:0x00
mode:DIO, clock div:1
load:0x3fff0030,len:1344
load:0x40078000,len:13924
ho 0 tail 12 room 4
load:0x40080400,len:3600
entry 0x400805f0
[PREFS] Loading prefs from file[PREFS]  -> For WiFi_SSID saved STRING item value:Kotona-1 type:4
[PREFS]  -> For WiFi_Password saved STRING item value:Stt1951_mrs type:4
[PREFS]  -> For WiFi_Retry_cnt saved UINT8 item value:9 type:1
[PREFS]  -> For WiFi_Mode saved UINT8 item value:1 type:1
[PREFS]  -> For HTTP_Local_JS saved UINT8 item value:1 type:1
[PREFS]  -> For Auth_Username saved STRING item value:admin type:4
[PREFS]  -> For Auth_Password saved STRING item value:hotashell type:4
[PREFS]  -> For NTP_Server1 saved STRING item value:0.nl.pool.ntp.org type:4
[PREFS]  -> For NTP_Server2 saved STRING item value:1.nl.pool.ntp.org type:4
[PREFS]  -> For NTP_Server3 saved STRING item value:2.nl.pool.ntp.org type:4
[PREFS]  -> For GMT_Offset_sec saved INT16 item value:3600 type:3
[PREFS]  -> For Daylight_Offset_sec saved INT16 item value:3600 type:3
[PREFS]  -> For Initial_Date saved STRING item value:2022-05-30 type:4
[PREFS]  -> For Initial_Time saved STRING item value:11:00:00 type:4
[PREFS]  -> For PID_Window saved UINT16 item value:5000 type:2
[PREFS]  -> For PID_Kp saved VFLOAT item value:20.000000 type:5
[PREFS]  -> For PID_Ki saved VFLOAT item value:0.200000 type:5
[PREFS]  -> For PID_Kd saved VFLOAT item value:0.100000 type:5
[PREFS]  -> For PID_Temp_Threshold saved INT16 item value:-1 type:3
[PREFS]  -> For LOG_Window saved UINT16 item value:30 type:2
[PREFS]  -> For LOG_Files_Limit saved UINT16 item value:40 type:2
[PREFS]  -> For DBG_Serial saved UINT8 item value:1 type:1
[PREFS]  -> For DBG_Syslog saved UINT8 item value:0 type:1
[PREFS]  -> For DBG_Syslog_Srv saved STRING item value:192.168.1.2 type:4
[PREFS]  -> For DBG_Syslog_Port saved UINT16 item value:514 type:2
[PREFS]  -> For MIN_Temperature saved UINT8 item value:10 type:1
[PREFS]  -> For MAX_Temperature saved UINT16 item value:250 type:2
[PREFS]  -> For MAX_Housing_Temperature saved UINT16 item value:50 type:2
[PREFS]  -> For Thermal_Runaway saved UINT16 item value:0 type:2
[PREFS]  -> For Alarm_Timeout saved UINT16 item value:5 type:2
[PREFS]  -> For MAX31855_Error_Grace_Count saved UINT8 item value:5 type:1
[PREFS] -=-=-= PREFS DISPLAY =-=-=-[PREFS] 1) 'WiFi_SSID' = 'XXXXXXXXXX'	4
[PREFS] 2) 'WiFi_Password' = 'XXXXXXXXX'	4
[PREFS] 3) 'WiFi_Mode' = '1'	1
[PREFS] 4) 'WiFi_Retry_cnt' = '9'	1
[PREFS] 8) 'HTTP_Local_JS' = '1'	1
[PREFS] 9) 'Auth_Username' = 'admin'	4
[PREFS] 10) 'Auth_Password' = 'hotashell'	4
[PREFS] 11) 'NTP_Server1' = '0.nl.pool.ntp.org'	4
[PREFS] 12) 'NTP_Server2' = '1.nl.pool.ntp.org'	4
[PREFS] 13) 'NTP_Server3' = '2.nl.pool.ntp.org'	4
[PREFS] 14) 'GMT_Offset_sec' = '3600'	3
[PREFS] 15) 'Daylight_Offset_sec' = '3600'	3
[PREFS] 16) 'Initial_Date' = '2022-05-30'	4
[PREFS] 17) 'Initial_Time' = '11:00:00'	4
[PREFS] 18) 'PID_Window' = '5000'	2
[PREFS] 22) 'PID_POE' = '0'	1
[PREFS] 23) 'PID_Temp_Threshold' = '-1'	3
[PREFS] 24) 'LOG_Window' = '30'	2
[PREFS] 25) 'LOG_Files_Limit' = '40'	2
[PREFS] 26) 'MIN_Temperature' = '10'	1
[PREFS] 27) 'MAX_Temperature' = '250'	2
[PREFS] 28) 'MAX_Housing_Temperature' = '50'	2
[PREFS] 29) 'Thermal_Runaway' = '0'	2
[PREFS] 30) 'Alarm_Timeout' = '5'	2
[PREFS] 31) 'MAX31855_Error_Grace_Count' = '5'	1
[PREFS] 32) 'DBG_Serial' = '1'	1
[PREFS] 33) 'DBG_Syslog' = '0'	1
[PREFS] 34) 'DBG_Syslog_Srv' = '192.168.1.2'	4
[PREFS] 35) 'DBG_Syslog_Port' = '514'	2
WiFi mode: 1, Retry count: 9, is wifi enabled: 4
[NET] Y:2022 [NET] M:05 [NET] D:30 [NET] H:11 [NET] m:00 [NET] s:00
[NET] Connecting to WiFi as Client...
[LOG] Syslog disabled
192.168.2.186
[PRG] Loading directory...
[PRG]	counted 7 files
[PRG] Processing filename: program1.txt
[PRG] FName: program1.txt	 FSize:491	Sel:0
[PRG] Processing filename: program2.txt
[PRG] FName: program2.txt	 FSize:143	Sel:0
[PRG] Processing filename: vfail2.txt
[PRG] FName: vfail2.txt	 FSize:233	Sel:0
[PRG] Processing filename: vfail1.txt
[PRG] FName: vfail1.txt	 FSize:246	Sel:0
[PRG] Processing filename: test_lowtemp.txt
[PRG] FName: test_lowtemp.txt	 FSize:304	Sel:0
[PRG] Processing filename: test_up_down.txt
[PRG] FName: test_up_down.txt	 FSize:270	Sel:0
[PRG] Processing filename: index.html
[HTTP] Head of index - copying...
<tr><td>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</td><td><a href="/programs/program1.txt" target="_blank">program1.txt</a></td><td>491</td><td># Short, clear description of the program.</td><td><a href=/load.html?prog_name=program1.txt>load</a></td><td><a href=/delete.html?prog_name=program1.txt>delete</a></td></tr>
<tr><td>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</td><td><a href="/programs/program2.txt" target="_blank">program2.txt</a></td><td>143</td><td># Second program short description</td><td><a href=/load.html?prog_name=program2.txt>load</a></td><td><a href=/delete.html?prog_name=program2.txt>delete</a></td></tr>
<tr><td>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</td><td><a href="/programs/test_lowtemp.txt" target="_blank">test_lowtemp.txt</a></td><td>304</td><td># Program to test low temperatures</td><td><a href=/load.html?prog_name=test_lowtemp.txt>load</a></td><td><a href=/delete.html?prog_name=test_lowtemp.txt>delete</a></td></tr>
<tr><td>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</td><td><a href="/programs/test_up_down.txt" target="_blank">test_up_down.txt</a></td><td>270</td><td># Program to test up and down temp. change</td><td><a href=/load.html?prog_name=test_up_down.txt>load</a></td><td><a href=/delete.html?prog_name=test_up_down.txt>delete</a></td></tr>
<tr><td>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</td><td><a href="/programs/vfail1.txt" target="_blank">vfail1.txt</a></td><td>246</td><td># Short description of fail1</td><td><a href=/load.html?prog_name=vfail1.txt>load</a></td><td><a href=/delete.html?prog_name=vfail1.txt>delete</a></td></tr>
<tr><td>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</td><td><a href="/programs/vfail2.txt" target="_blank">vfail2.txt</a></td><td>233</td><td># Short description of fail2</td><td><a href=/load.html?prog_name=vfail2.txt>load</a></td><td><a href=/delete.html?prog_name=vfail2.txt>delete</a></td></tr>

[HTTP] End of index - copying...
[LOG] Loading dir: Loading logs directory...
[LOG] Loading dir:	counted 1 files
[LOG] Loading dir: Loading logs directory...
[LOG] Loading dir:	counted 1 files
[HTTP] Head of logs - copying...
[HTTP] End of log index - copying...
[ADDONS] Temperature sensor A readout: Internal temp = 24.3 	 Last temp = 32.0 	 Average kiln temp = 21.2
[ADDONS] Temperature sensor A readout: Internal temp = 26.5 	 Last temp = 32.2 	 Average kiln temp = 22.3
[ADDONS] Temperature sensor A readout: Internal temp = 27.5 	 Last temp = 32.0 	 Average kiln temp = 23.3
[ADDONS] Temperature sensor A readout: Internal temp = 28.1 	 Last temp = 31.5 	 Average kiln temp = 24.1
[ADDONS] Temperature sensor A readout: Internal temp = 28.3 	 Last temp = 31.5 	 Average kiln temp = 24.8
[ADDONS] Temperature sensor A readout: Internal temp = 28.4 	 Last temp = 32.0 	 Average kiln temp = 25.6
[ADDONS] Temperature sensor A readout: Internal temp = 28.5 	 Last temp = 32.0 	 Average kiln temp = 26.2
[ADDONS] Temperature sensor A readout: Internal temp = 28.5 	 Last temp = 27.2 	 Average kiln temp = 26.3
[ADDONS] Temperature sensor A readout: Internal temp = 28.5 	 Last temp = 32.2 	 Average kiln temp = 26.9
[ADDONS] Temperature sensor A readout: Internal temp = 28.6 	 Last temp = 31.2 	 Average kiln temp = 27.3
[ADDONS] Temperature sensor A readout: Internal temp = 28.6 	 Last temp = 32.2 	 Average kiln temp = 27.8
[ADDONS] Temperature sensor A readout: Internal temp = 28.6 	 Last temp = 31.2 	 Average kiln temp = 28.2
[ADDONS] Temperature sensor A readout: Internal temp = 28.6 	 Last temp = 26.2 	 Average kiln temp = 28.0
[ADDONS] Temperature sensor A readout: Internal temp = 28.6 	 Last temp = 29.2 	 Average kiln temp = 28.1
[ADDONS] Temperature sensor A readout: Internal temp = 28.6 	 Last temp = 27.8 	 Average kiln temp = 28.1
[ADDONS] Temperature sensor A readout: Internal temp = 28.6 	 Last temp = 28.0 	 Average kiln temp = 28.1
[ADDONS] Temperature sensor A readout: Internal temp = 28.6 	 Last temp = 29.0 	 Average kiln temp = 28.2
[ADDONS] Temperature sensor A readout: Internal temp = 28.6 	 Last temp = 27.8 	 Average kiln temp = 28.1
[ADDONS] Temperature sensor A readout: Internal temp = 28.6 	 Last temp = 28.0 	 Average kiln temp = 28.1
[ADDONS] Temperature sensor A readout: Internal temp = 28.6 	 Last temp = 28.0 	 Average kiln temp = 28.1
[ADDONS] Temperature sensor A readout: Internal temp = 28.6 	 Last temp = 27.5 	 Average kiln temp = 28.0
[ADDONS] Temperature sensor A readout: Internal temp = 28.6 	 Last temp = 29.0 	 Average kiln temp = 28.1
[ADDONS] Temperature sensor A readout: Internal temp = 28.6 	 Last temp = 31.8 	 Average kiln temp = 28.5
[ADDONS] Temperature sensor A readout: Internal temp = 28.6 	 Last temp = 28.2 	 Average kiln temp = 28.5
[ADDONS] Temperature sensor A readout: Internal temp = 28.6 	 Last temp = 28.0 	 Average kiln temp = 28.4
[ADDONS] Temperature sensor A readout: Internal temp = 28.6 	 Last temp = 28.2 	 Average kiln temp = 28.4
[ADDONS] Temperature sensor A readout: Internal temp = 28.6 	 Last temp = 28.2 	 Average kiln temp = 28.4
[ADDONS] Temperature sensor A readout: Internal temp = 28.5 	 Last temp = 26.0 	 Average kiln temp = 28.1
[ADDONS] Temperature sensor A readout: Internal temp = 28.6 	 Last temp = 17.8 	 Average kiln temp = 27.1
[ADDONS] Temperature sensor A readout: Internal temp = 28.5 	 Last temp = 21.8 	 Average kiln temp = 26.6
[ADDONS] Temperature sensor A readout: Internal temp = 28.6 	 Last temp = 18.8 	 Average kiln temp = 25.8
[ADDONS] Temperature sensor A readout: Internal temp = 28.6 	 Last temp = 17.5 	 Average kiln temp = 25.0
[ADDONS] Temperature sensor A readout: Internal temp = 28.6 	 Last temp = 19.8 	 Average kiln temp = 24.4
[ADDONS] Temperature sensor A readout: Internal temp = 28.6 	 Last temp = 29.0 	 Average kiln temp = 24.9
[ADDONS] Temperature sensor A readout: Internal temp = 28.6 	 Last temp = 28.0 	 Average kiln temp = 25.2
[ADDONS] Temperature sensor A readout: Internal temp = 28.6 	 Last temp = 30.5 	 Average kiln temp = 25.7
[ADDONS] Temperature sensor A readout: Internal temp = 28.6 	 Last temp = 32.2 	 Average kiln temp = 26.4
[ADDONS] Temperature sensor A readout: Internal temp = 28.5 	 Last temp = 21.0 	 Average kiln temp = 25.8
[ADDONS] Temperature sensor A readout: Internal temp = 28.6 	 Last temp = 31.8 	 Average kiln temp = 26.4
[ADDONS] Temperature sensor A readout: Internal temp = 28.6 	 Last temp = 30.5 	 Average kiln temp = 26.8
[ADDONS] Temperature sensor A readout: Internal temp = 28.6 	 Last temp = 32.0 	 Average kiln temp = 27.4
[ADDONS] Temperature sensor A readout: Internal temp = 28.6 	 Last temp = 29.0 	 Average kiln temp = 27.5
[ADDONS] Temperature sensor A readout: Internal temp = 28.6 	 Last temp = 25.0 	 Average kiln temp = 27.3
[ADDONS] Temperature sensor A readout: Internal temp = 28.6 	 Last temp = 32.0 	 Average kiln temp = 27.7
[ADDONS] Temperature sensor A readout: Internal temp = 28.6 	 Last temp = 27.0 	 Average kiln temp = 27.7
[PRG] Got pointer to load:'test_lowtemp.txt'
[PRG] Load program name: '/programs/test_lowtemp.txt'
[PRG] Raw line: '# Program to test low temperatures'
[PRG]  comment[PRG] Raw line: '# Full description on as many lines you wish -'
[PRG]  comment[PRG] Raw line: '#   just remember about default program limit - 10KiB'
[PRG]  comment[PRG] Raw line: '# Program parameters target temperature in Celcius:minutes to achieve this temperature:dwelling time in minutes'
[PRG]  comment[PRG] Raw line: '35:10:5'
[PRG] Sanitizing line: '35:10:5'
[PRG] Program_pos: 0, Temp: 35C Time to: 10s Dwell: 5s
[PRG] San line: '35:10:5'
[PRG] Raw line: '44:5:10'
[PRG] Sanitizing line: '44:5:10'
[PRG] Program_pos: 1, Temp: 44C Time to: 5s Dwell: 10s
[PRG] San line: '44:5:10'
[PRG] Raw line: '55:10:10'
[PRG] Sanitizing line: '55:10:10'
[PRG] Program_pos: 2, Temp: 55C Time to: 10s Dwell: 10s
[PRG] San line: '55:10:10'
[PRG] Raw line: '60:10:5'
[PRG] Sanitizing line: '60:10:5'
[PRG] Program_pos: 3, Temp: 60C Time to: 10s Dwell: 5s
[PRG] San line: '60:10:5'
[PRG] Raw line: '45:15:0'
[PRG] Sanitizing line: '45:15:0'
[PRG] Program_pos: 4, Temp: 45C Time to: 15s Dwell: 0s
[PRG] San line: '45:15:0'
[PRG] Raw line: '30:5:5'
[PRG] Sanitizing line: '30:5:5'
[PRG] Program_pos: 5, Temp: 30C Time to: 5s Dwell: 5s
[PRG] San line: '30:5:5'
[PRG] Raw line: '50:10:0'
[PRG] Sanitizing line: '50:10:0'
[PRG] Program_pos: 6, Temp: 50C Time to: 10s Dwell: 0s
[PRG] San line: '50:10:0'
[PRG] Found description: Program to test low temperatures
[ADDONS] Temperature sensor A readout: Internal temp = 28.6 	 Last temp = 28.5 	 Average kiln temp = 27.8
[ADDONS] Temperature sensor A readout: Internal temp = 28.5 	 Last temp = 8.0 	 Average kiln temp = 25.8
[ADDONS] Temperature sensor A readout: Internal temp = 28.5 	 Last temp = 22.5 	 Average kiln temp = 25.5
[ADDONS] Temperature sensor A readout: Internal temp = 28.6 	 Last temp = 22.2 	 Average kiln temp = 25.1
[ADDONS] Temperature sensor A readout: Internal temp = 28.6 	 Last temp = 20.5 	 Average kiln temp = 24.7
[ADDONS] Temperature sensor A readout: Internal temp = 28.5 	 Last temp = 27.0 	 Average kiln temp = 24.9
[ADDONS] Temperature sensor A readout: Internal temp = 28.5 	 Last temp = 32.0 	 Average kiln temp = 25.6
[ADDONS] Temperature sensor A readout: Internal temp = 28.5 	 Last temp = 32.0 	 Average kiln temp = 26.2
[HTTP] Index post parser: POST[prog_start]: Start program
[PRG] Starting new program![DBG] Calculating new step!
[PRG] Calculating new NORMAL step!
[PRG] Next step:1689234824 Start step:1689234224 Togo:10 Run_step:0/7 Set_temp:0.000
[DBG] First step.
[PRG] Curr temp: 26, Set_temp: 26, Incr: 0.01 Pid_out:0.00 Step: 0
[PRG] Trying to start log - window size:30
[PRG] Trying to create logs[LOG] Trying to create log file:/logs/230713_094344.csv
[LOG] Created new log file /logs/230713_094344.csv
[LOG] Loading dir: Loading logs directory...
[LOG] Loading dir:	counted 3 files
[LOG] FName: 230713_094344.csv	 FSize:0	Sel:0
[LOG] FName: 230713_094344.log	 FSize:276	Sel:0
[ADDONS] Temperature sensor A readout: Internal temp = 28.5 	 Last temp = 27.8 	 Average kiln temp = 26.4
[HTTP] Head of logs - copying...
[HTTP] End of log index - copying...
[LOG] Writing to log file:2023-07-13 09:43:45,26,20
[ADDONS] Temperature sensor A readout: Internal temp = 28.4 	 Last temp = 19.8 	 Average kiln temp = 25.7
[ADDONS] Temperature sensor A readout: Internal temp = 28.5 	 Last temp = 21.2 	 Average kiln temp = 25.3
[ADDONS] Temperature sensor A readout: Internal temp = 28.5 	 Last temp = 23.0 	 Average kiln temp = 25.1
[ADDONS] Temperature sensor A readout: Internal temp = 28.6 	 Last temp = 20.0 	 Average kiln temp = 24.6
[ADDONS] Temperature sensor A readout: Internal temp = 28.6 	 Last temp = 22.8 	 Average kiln temp = 24.4
[ADDONS] Temperature sensor A readout: Internal temp = 28.5 	 Last temp = 28.5 	 Average kiln temp = 24.8
[ADDONS] Temperature sensor A readout: Internal temp = 28.5 	 Last temp = 31.8 	 Average kiln temp = 25.5
[ADDONS] Temperature sensor A readout: Internal temp = 28.6 	 Last temp = 31.2 	 Average kiln temp = 26.1
[ADDONS] Temperature sensor A readout: Internal temp = 28.6 	 Last temp = 28.5 	 Average kiln temp = 26.3
[PRG] Curr temp: 26, Set_temp: 26, Incr: 0.01 Pid_out:8.53 Step: 0
[ADDONS] Temperature sensor A readout: Internal temp = 28.6 	 Last temp = 28.8 	 Average kiln temp = 26.5
[PRG] Pid_out RAW:3.66 Pid_out:3.66 Now-window:575 WindowSize:5000 Prg_state:2
[ADDONS] Temperature sensor A readout: Internal temp = 28.6 	 Last temp = 27.5 	 Average kiln temp = 26.6
[ADDONS] Temperature sensor A readout: Internal temp = 28.6 	 Last temp = 32.0 	 Average kiln temp = 27.2
[ADDONS] Temperature sensor A readout: Internal temp = 28.6 	 Last temp = 28.2 	 Average kiln temp = 27.3
[ADDONS] Temperature sensor A readout: Internal temp = 28.6 	 Last temp = 30.5 	 Average kiln temp = 27.6
[ADDONS] Temperature sensor A readout: Internal temp = 28.6 	 Last temp = 31.5 	 Average kiln temp = 28.0
[ADDONS] Temperature sensor A readout: Internal temp = 28.6 	 Last temp = 17.5 	 Average kiln temp = 26.9
[ADDONS] Temperature sensor A readout: Internal temp = 28.6 	 Last temp = 31.0 	 Average kiln temp = 27.4
[ADDONS] Temperature sensor A readout: Internal temp = 28.6 	 Last temp = 30.2 	 Average kiln temp = 27.6
[ADDONS] Temperature sensor A readout: Internal temp = 28.6 	 Last temp = 32.0 	 Average kiln temp = 28.1
[PRG] Curr temp: 28, Set_temp: 27, Incr: 0.01 Pid_out:6.66 Step: 0
[PRG] Pid_out RAW:6.66 Pid_out:6.66 Now-window:4579 WindowSize:5000 Prg_state:2
[ADDONS] Temperature sensor A readout: Internal temp = 28.6 	 Last temp = 32.2 	 Average kiln temp = 28.5
[ADDONS] Temperature sensor A readout: Internal temp = 28.6 	 Last temp = 31.5 	 Average kiln temp = 28.8
[ADDONS] Temperature sensor A readout: Internal temp = 28.6 	 Last temp = 30.5 	 Average kiln temp = 29.0
[ADDONS] Temperature sensor A readout: Internal temp = 28.6 	 Last temp = 32.0 	 Average kiln temp = 29.3
[ADDONS] Temperature sensor A readout: Internal temp = 28.6 	 Last temp = 27.0 	 Average kiln temp = 29.0
[ADDONS] Temperature sensor A readout: Internal temp = 28.6 	 Last temp = 32.2 	 Average kiln temp = 29.4
[ADDONS] Temperature sensor A readout: Internal temp = 28.6 	 Last temp = 31.8 	 Average kiln temp = 29.6
[ADDONS] Temperature sensor A readout: Internal temp = 28.6 	 Last temp = 32.0 	 Average kiln temp = 29.8
[ADDONS] Temperature sensor A readout: Internal temp = 28.6 	 Last temp = 32.2 	 Average kiln temp = 30.1
[PRG] Pid_out RAW:0.00 Pid_out:0.00 Now-window:3575 WindowSize:5000 Prg_state:2
[ADDONS] Temperature sensor A readout: Internal temp = 28.6 	 Last temp = 32.0 	 Average kiln temp = 30.3
[LOG] Writing to log file:2023-07-13 09:44:14,30,20
[PRG] Curr temp: 30, Set_temp: 27, Incr: 0.01 Pid_out:0.00 Step: 0
[ADDONS] Temperature sensor A readout: Internal temp = 28.6 	 Last temp = 32.2 	 Average kiln temp = 30.5
[ADDONS] Temperature sensor A readout: Internal temp = 28.5 	 Last temp = 30.8 	 Average kiln temp = 30.5
[ADDONS] Temperature sensor A readout: Internal temp = 28.5 	 Last temp = 32.2 	 Average kiln temp = 30.7
[ADDONS] Temperature sensor A readout: Internal temp = 28.6 	 Last temp = 32.2 	 Average kiln temp = 30.8
[ADDONS] Temperature sensor A readout: Internal temp = 28.6 	 Last temp = 32.2 	 Average kiln temp = 31.0
[ADDONS] Temperature sensor A readout: Internal temp = 28.6 	 Last temp = 31.8 	 Average kiln temp = 31.1
[ADDONS] Temperature sensor A readout: Internal temp = 28.6 	 Last temp = 28.8 	 Average kiln temp = 30.8
[ADDONS] Temperature sensor A readout: Internal temp = 28.6 	 Last temp = 32.5 	 Average kiln temp = 31.0
[PRG] Pid_out RAW:3.88 Pid_out:3.88 Now-window:2579 WindowSize:5000 Prg_state:2
[ADDONS] Temperature sensor A readout: Internal temp = 28.6 	 Last temp = 32.0 	 Average kiln temp = 31.1
[ADDONS] Temperature sensor A readout: Internal temp = 28.6 	 Last temp = 32.2 	 Average kiln temp = 31.2
[PRG] Curr temp: 31, Set_temp: 27, Incr: 0.01 Pid_out:0.00 Step: 0
[ADDONS] Temperature sensor A readout: Internal temp = 28.6 	 Last temp = 32.5 	 Average kiln temp = 31.3
[ADDONS] Temperature sensor A readout: Internal temp = 28.5 	 Last temp = 29.8 	 Average kiln temp = 31.2
[ADDONS] Temperature sensor A readout: Internal temp = 28.6 	 Last temp = 32.5 	 Average kiln temp = 31.3
[ADDONS] Temperature sensor A readout: Internal temp = 28.6 	 Last temp = 28.0 	 Average kiln temp = 31.0
[ADDONS] Temperature sensor A readout: Internal temp = 28.6 	 Last temp = 27.5 	 Average kiln temp = 30.6
[ADDONS] Temperature sensor A readout: Internal temp = 28.6 	 Last temp = 28.5 	 Average kiln temp = 30.4
[ADDONS] Temperature sensor A readout: Internal temp = 28.6 	 Last temp = 29.0 	 Average kiln temp = 30.3
[PRG] Pid_out RAW:15.81 Pid_out:15.81 Now-window:1573 WindowSize:5000 Prg_state:2
[ADDONS] Temperature sensor A readout: Internal temp = 28.6 	 Last temp = 29.0 	 Average kiln temp = 30.1
[ADDONS] Temperature sensor A readout: Internal temp = 28.6 	 Last temp = 31.0 	 Average kiln temp = 30.2
[ADDONS] Temperature sensor A readout: Internal temp = 28.6 	 Last temp = 26.2 	 Average kiln temp = 29.8
[PRG] Curr temp: 30, Set_temp: 27, Incr: 0.01 Pid_out:17.73 Step: 0
[ADDONS] Temperature sensor A readout: Internal temp = 28.6 	 Last temp = 29.2 	 Average kiln temp = 29.8
[ADDONS] Temperature sensor A readout: Internal temp = 28.6 	 Last temp = 26.5 	 Average kiln temp = 29.4
[ADDONS] Temperature sensor A readout: Internal temp = 28.6 	 Last temp = 32.0 	 Average kiln temp = 29.7
[ADDONS] Temperature sensor A readout: Internal temp = 28.6 	 Last temp = 29.2 	 Average kiln temp = 29.7
[ADDONS] Temperature sensor A readout: Internal temp = 28.6 	 Last temp = 27.5 	 Average kiln temp = 29.4
[ADDONS] Temperature sensor A readout: Internal temp = 28.6 	 Last temp = 31.2 	 Average kiln temp = 29.6
[PRG] Pid_out RAW:30.72 Pid_out:30.72 Now-window:572 WindowSize:5000 Prg_state:2
[ADDONS] Temperature sensor A readout: Internal temp = 28.6 	 Last temp = 29.8 	 Average kiln temp = 29.6
[ADDONS] Temperature sensor A readout: Internal temp = 28.6 	 Last temp = 32.2 	 Average kiln temp = 29.9
[ADDONS] Temperature sensor A readout: Internal temp = 28.6 	 Last temp = 31.8 	 Average kiln temp = 30.1
[ADDONS] Temperature sensor A readout: Internal temp = 28.6 	 Last temp = 31.2 	 Average kiln temp = 30.2
[LOG] Writing to log file:2023-07-13 09:44:44,30,20
[PRG] Curr temp: 30, Set_temp: 27, Incr: 0.01 Pid_out:15.97 Step: 0
[ADDONS] Temperature sensor A readout: Internal temp = 28.6 	 Last temp = 13.0 	 Average kiln temp = 28.5
[ADDONS] Temperature sensor A readout: Internal temp = 28.6 	 Last temp = 12.2 	 Average kiln temp = 26.9
[ADDONS] Temperature sensor A readout: Internal temp = 28.6 	 Last temp = 30.8 	 Average kiln temp = 27.2
[ADDONS] Temperature sensor A readout: Internal temp = 28.6 	 Last temp = 31.8 	 Average kiln temp = 27.7
[ADDONS] Temperature sensor A readout: Internal temp = 28.6 	 Last temp = 32.0 	 Average kiln temp = 28.1
[PRG] Pid_out RAW:62.87 Pid_out:62.87 Now-window:4578 WindowSize:5000 Prg_state:2
[ADDONS] Temperature sensor A readout: Internal temp = 28.6 	 Last temp = 31.8 	 Average kiln temp = 28.5
[ADDONS] Temperature sensor A readout: Internal temp = 28.6 	 Last temp = 30.0 	 Average kiln temp = 28.6
[ADDONS] Temperature sensor A readout: Internal temp = 28.6 	 Last temp = 32.0 	 Average kiln temp = 29.0
[ADDONS] Temperature sensor A readout: Internal temp = 28.6 	 Last temp = 31.8 	 Average kiln temp = 29.3
[ADDONS] Temperature sensor A readout: Internal temp = 28.6 	 Last temp = 31.2 	 Average kiln temp = 29.5
[PRG] Curr temp: 29, Set_temp: 27, Incr: 0.01 Pid_out:30.41 Step: 0
[ADDONS] Temperature sensor A readout: Internal temp = 28.6 	 Last temp = 32.0 	 Average kiln temp = 29.7
[ADDONS] Temperature sensor A readout: Internal temp = 28.6 	 Last temp = 30.8 	 Average kiln temp = 29.8
[ADDONS] Temperature sensor A readout: Internal temp = 28.6 	 Last temp = 32.2 	 Average kiln temp = 30.1
[ADDONS] Temperature sensor A readout: Internal temp = 28.6 	 Last temp = 30.8 	 Average kiln temp = 30.1
[PRG] Pid_out RAW:12.60 Pid_out:12.60 Now-window:3576 WindowSize:5000 Prg_state:2
[ADDONS] Temperature sensor A readout: Internal temp = 28.6 	 Last temp = 30.2 	 Average kiln temp = 30.1
[ADDONS] Temperature sensor A readout: Internal temp = 28.6 	 Last temp = 31.8 	 Average kiln temp = 30.3
[ADDONS] Temperature sensor A readout: Internal temp = 28.6 	 Last temp = 31.0 	 Average kiln temp = 30.4
[ADDONS] Temperature sensor A readout: Internal temp = 28.6 	 Last temp = 32.0 	 Average kiln temp = 30.5
[ADDONS] Temperature sensor A readout: Internal temp = 28.6 	 Last temp = 31.0 	 Average kiln temp = 30.6
[ADDONS] Temperature sensor A readout: Internal temp = 28.6 	 Last temp = 32.2 	 Average kiln temp = 30.7
[PRG] Curr temp: 31, Set_temp: 27, Incr: 0.01 Pid_out:0.00 Step: 0
[ADDONS] Temperature sensor A readout: Internal temp = 28.6 	 Last temp = 32.2 	 Average kiln temp = 30.9
[ADDONS] Temperature sensor A readout: Internal temp = 28.6 	 Last temp = 31.2 	 Average kiln temp = 30.9
[ADDONS] Temperature sensor A readout: Internal temp = 28.6 	 Last temp = 30.5 	 Average kiln temp = 30.9
[PRG] Pid_out RAW:0.00 Pid_out:0.00 Now-window:2578 WindowSize:5000 Prg_state:2
[ADDONS] Temperature sensor A readout: Internal temp = 28.6 	 Last temp = 31.2 	 Average kiln temp = 30.9
[ADDONS] Temperature sensor A readout: Internal temp = 28.6 	 Last temp = 31.5 	 Average kiln temp = 31.0
[ADDONS] Temperature sensor A readout: Internal temp = 28.6 	 Last temp = 31.5 	 Average kiln temp = 31.0
[ADDONS] Temperature sensor A readout: Internal temp = 28.6 	 Last temp = 30.8 	 Average kiln temp = 31.0
[ADDONS] Temperature sensor A readout: Internal temp = 28.6 	 Last temp = 31.5 	 Average kiln temp = 31.1
[ADDONS] Temperature sensor A readout: Internal temp = 28.6 	 Last temp = 31.5 	 Average kiln temp = 31.1
[ADDONS] Temperature sensor A readout: Internal temp = 28.6 	 Last temp = 31.8 	 Average kiln temp = 31.2
[LOG] Writing to log file:2023-07-13 09:45:14,31,20
[PRG] Curr temp: 31, Set_temp: 28, Incr: 0.01 Pid_out:0.00 Step: 0
[ADDONS] Temperature sensor A readout: Internal temp = 28.6 	 Last temp = 31.5 	 Average kiln temp = 31.2
[ADDONS] Temperature sensor A readout: Internal temp = 28.6 	 Last temp = 31.0 	 Average kiln temp = 31.2
[PRG] Pid_out RAW:0.00 Pid_out:0.00 Now-window:1578 WindowSize:5000 Prg_state:2
[ADDONS] Temperature sensor A readout: Internal temp = 28.6 	 Last temp = 32.5 	 Average kiln temp = 31.3
[ADDONS] Temperature sensor A readout: Internal temp = 28.6 	 Last temp = 31.8 	 Average kiln temp = 31.4
[ADDONS] Temperature sensor A readout: Internal temp = 28.6 	 Last temp = 31.8 	 Average kiln temp = 31.4
[ADDONS] Temperature sensor A readout: Internal temp = 28.6 	 Last temp = 32.2 	 Average kiln temp = 31.5
[ADDONS] Temperature sensor A readout: Internal temp = 28.6 	 Last temp = 31.2 	 Average kiln temp = 31.5
[ADDONS] Temperature sensor A readout: Internal temp = 28.6 	 Last temp = 31.2 	 Average kiln temp = 31.4
[ADDONS] Temperature sensor A readout: Internal temp = 28.6 	 Last temp = 30.8 	 Average kiln temp = 31.4
[ADDONS] Temperature sensor A readout: Internal temp = 28.6 	 Last temp = 31.5 	 Average kiln temp = 31.4`

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

Saur0o0n, 2023-07-13:
You've missed one step from https://github.com/Saur0o0n/pidkiln/wiki/Required-software
"Update (there is no other way to do it) in file "libraries/ESPAsyncWebServer/src/WebResponseImpl.h" variable TEMPLATE_PLACEHOLDER to '~'."

Closed 2024-02-09.

Thread 44 (2023-11-21):

MAX6675  instead of MAX31855

ggioorgii, 2023-11-21:
first of all thank you for this great project.
In my local area I only find  MAX6675 boards. It is possible to easily replace code and use MAX6675 somehow?
Or order MAX31855 and wait 1 month ? :(

Saur0o0n, 2023-11-21:
I remember I had a brief discussion with somebody on 6675 (https://github.com/Saur0o0n/PIDKiln/issues/32#issue-1515106087) - but don't remember if I've checked then if this is feasible to use it. Also quick look shows it's 0°C to +1024°C - so you also have to take it into consideration.

ggioorgii, 2023-11-22:
I find Max31855 and setup everything. It almost works. max6675 give me 1000c reads always.

But I have new problem. I can on/off relay by start or stop program, but when I set temp by program, it not try to hold that temp. relay  is always on and kiln temp is increasing nonstop.

ggioorgii, 2023-11-22:
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

ggioorgii, 2023-11-23:
pin 19 was problematic. I don't know why. I using one relay, so uncomment second relay, set first relay to pin22 now everything works.

ggioorgii, 2023-11-23:
I am so happy with this. Thank you again. little bit hard to setup for me, because I using different hardware, but it worth it.

Thread 45 (2023-11-26):

More thanks

kspearAus, 2023-11-26:
Thank you for sharing your work as well!
I will be adapting it to manage a 3d printer filament drier using a PTC heater.
Cheers!
Kurt

Thread 46 (2024-05-26):

Using more high temperature s-type thermocouple

Tkachlab, 2024-05-26:
Hello. Can i use a s-type thermocouple with max31855sasa chip? Do i need to modify code?. Thanks

Saur0o0n, 2024-05-26:
Hi, the library used to handle max31855 chip states it works only with K type probes (https://github.com/enjoyneering/MAX31855) - so as long, as you would be able to modify this library to work with other thermocouples, PIDKiln wouldn't care what type it is.

Closed 2024-05-27.

Thread 48 (2024-11-17):

Compilation error: invalid conversion from 'const AsyncWebHeader*' to 'AsyncWebHeader*' [-fpermissive]

kingnoob1377, 2024-11-17:
I had errors compiling pidkiln.
I had other several errors compiling, but I was able to get through them somehow.
This thing I have no idea.

how can I complete my compilation?

compilation terminal output
[log.txt](https://github.com/user-attachments/files/17790503/log.txt)

installed libraries
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

My sketch
[PIDKiln.zip](https://github.com/user-attachments/files/17790519/PIDKiln.zip)

Saur0o0n, 2024-11-17:
Hi, I would guess there are some braking changes both in esp32 Arduino framework and asyncwebserver. You can try to compile it with older versions. I'll also probably update/fix the code, but can't say now when exactly :)

kingnoob1377, 2024-11-24:
thanks for the reply. downgrading esp32 board library fixed it, but I also had to downgrade the arduino ide due to the ping timout error. now I can upload the sketch without an issue.

Saur0o0n, 2024-12-18:
I've updated the code to compile with recent esp and libraries - although it's not tested much.

Closed 2024-12-18.

Thread 49 (2024-12-15):

Runtime issue

terrin2k, 2024-12-15:
Hey everyone!

So I can build and upload the code & filesystem to my ESP32 and it runs... however, I get the following endless panic/reboot cycle:

```
<snip>
[PREFS] 31) 'MAX31855_Error_Grace_Count' = '5'	1
[PREFS] 32) 'DBG_Serial' = '1'	1
[PREFS] 33) 'DBG_Syslog' = '0'	1
[PREFS] 34) 'DBG_Syslog_Srv' = '192.168.1.2'	4
[PREFS] 35) 'DBG_Syslog_Port' = '514'	2
WiFi mode: 1, Retry count: 9, is wifi enabled: 4
[NET] Y:2024 [NET] M:01 [NET] D:01 [NET] H:11 [NET] m:00 [NET] s:00
[NET] Connecting to WiFi as Client...
[LOG] Syslog disabled
192.168.0.100
[PRG] Loading directory...
[PRG]	counted 6 files
[PRG] Processing filename: program1.txt
Guru Meditation Error: Core  1 panic'ed (StoreProhibited). Exception was unhandled.

Core  1 register dump:
PC      : 0x4008c15a  PS      : 0x00060730  A0      : 0x800daba1  A1      : 0x3ffb2080
A2      : 0x00000000  A3      : 0x3ffb20f0  A4      : 0x000000ff  A5      : 0x0000ff00
A6      : 0x00ff0000  A7      : 0xff000000  A8      : 0x676f7270  A9      : 0x00000069
A10     : 0x00000000  A11     : 0x3ffd94b8  A12     : 0x3f401dba  A13     : 0x3ffb2070
A14     : 0x3ffb2040  A15     : 0x00000008  SAR     : 0x00000016  EXCCAUSE: 0x0000001d
EXCVADDR: 0x00000000  LBEG    : 0x4008c14d  LEND    : 0x4008c161  LCOUNT  : 0xffffffff

Backtrace: 0x4008c157:0x3ffb2080 0x400dab9e:0x3ffb2090 0x400dadb3:0x3ffb2130 0x400db593:0x3ffb2210 0x400f096f:0x3ffb2290
```

Decoded backtrace shows this:
```
    0x4008c157: strcpy at /builds/idf/crosstool-NG/.build/HOST-i686-w64-mingw32/xtensa-esp32-elf/src/newlib/newlib/libc/machine/xtensa/strcpy.S:103
    0x400dab9e: Load_programs_dir() at C:\Users\danie\Documents\Arduino\PIDKiln\PIDKiln_program.ino:157
    0x400dadb3: Generate_INDEX() at C:\Users\danie\Documents\Arduino\PIDKiln\PIDKiln_http.ino:204
    0x400db593: setup() at C:\Users\danie\Documents\Arduino\PIDKiln\PIDKiln.ino:169
    0x400f096f: loopTask(void*) at C:\Users\danie\AppData\Local\Arduino15\packages\esp32\hardware\esp32\3.0.1\cores\esp32\main.cpp:58
```

I am using:
- Arduino IDE 1.8.18
- ESP32 board package 3.0.1 (also tried latest 3.0.7, and various 2.0.X which fail with a build error)
- Libraries:
- AsyncTCP 3.2.15
- ESP Async Webserver 3.4.0
- PID 1.2.0
- SimpleSyslog 0.1.2
- U8G2 2.35.30

I've tested this with my ESP32 board (ESP-WROVER-32U based) isolated from the hardware and in-situ and it crashes either way.

I've verified that I have the 4MB board and the correct Program/SPIFFs profile chosen in the Arduino IDE.

Any ideas as to what might be going on here?

Thanks!

~ D

Saur0o0n, 2024-12-15:
Hi, Since it's failing on strcpy it looks like some memory allocation issue. Are you sure you have wrover (not wroom) board? You can try to change #define settings for wroom memory allocation and try again.
I'll try to find some time during holidays to update the code to make it work with current arduino/esp32 IDE.

terrin2k, 2024-12-15:
Argh. You are 100% correct. I have an ESP32-WROOM-32U. <facepalm>

I'm rebuilding now. I'll let y'all know how it goes.

Thanks for the quick reply!

~ D

terrin2k, 2024-12-15:
Hmm.

The ESP32 board I have has an ESP32-WROOM-32U on it, and 'ESP32_DevKitC_V4' on the silkscreen on the back.

I've tried a couple of different boards from the IDE and I've completely erased the flash for each before trying to run the code. Each build still crashes as I showed above.

I've also tried another board of the same type with the same results.

Any other ideas?

~ D

```
[PREFS] 25) 'LOG_Files_Limit' = '40'	2
[PREFS] 26) 'MIN_Temperature' = '10'	1
[PREFS] 27) 'MAX_Temperature' = '1350'	2
[PREFS] 28) 'MAX_Housing_Temperature' = '130'	2
[PREFS] 29) 'Thermal_Runaway' = '0'	2
[PREFS] 30) 'Alarm_Timeout' = '5'	2
[PREFS] 31) 'MAX31855_Error_Grace_Count' = '5'	1
[PREFS] 32) 'DBG_Serial' = '1'	1
[PREFS] 33) 'DBG_Syslog' = '0'	1
[PREFS] 34) 'DBG_Syslog_Srv' = '192.168.1.2'	4
[PREFS] 35) 'DBG_Syslog_Port' = '514'	2
WiFi mode: 1, Retry count: 9, is wifi enabled: 4
[NET] Y:2024 [NET] M:01 [NET] D:01 [NET] H:11 [NET] m:00 [NET] s:00
[NET] Connecting to WiFi as Client...
[LOG] Syslog disabled
192.168.0.100
[PRG] Loading directory...
[PRG]	counted 6 files
[PRG] Processing filename: program1.txt
Guru Meditation Error: Core  1 panic'ed (StoreProhibited). Exception was unhandled.

Core  1 register dump:
PC      : 0x4008b32e  PS      : 0x00060f30  A0      : 0x800da99d  A1      : 0x3ffb2060
A2      : 0x00000000  A3      : 0x3ffb20d0  A4      : 0x000000ff  A5      : 0x0000ff00
A6      : 0x00ff0000  A7      : 0xff000000  A8      : 0x676f7270  A9      : 0x00000069
A10     : 0x00000000  A11     : 0x3ffd8764  A12     : 0x3f401dba  A13     : 0x3ffb2050
A14     : 0x3ffb2020  A15     : 0x00000008  SAR     : 0x00000012  EXCCAUSE: 0x0000001d
EXCVADDR: 0x00000000  LBEG    : 0x4008b321  LEND    : 0x4008b335  LCOUNT  : 0xffffffff

Backtrace: 0x4008b32b:0x3ffb2060 0x400da99a:0x3ffb2070 0x400daba3:0x3ffb2110 0x400db37f:0x3ffb21f0 0x400efd77:0x3ffb2270 0x40091462:0x3ffb2290
```

terrin2k, 2024-12-20:
A little progress to report...

So I replaced my ESP32 boards with ones ordered from Espressif. These are DevKitC boards with an actual ESP32-WROVER-IE module onboard. When I run the code, I no longer get the strcpy crash. Yay!

Instead, the code runs for a while then crashes due to the WDT. Boo.
```
[PRG] FName: test_up_down.txt	 FSize:270	Sel:0
[PRG] Processing filename: vfail1.txt
[PRG] FName: vfail1.txt	 FSize:246	Sel:0
[PRG] Processing filename: vfail2.txt
[PRG] FName: vfail2.txt	 FSize:233	Sel:0
[PRG] Processing filename: index.html
[HTTP] Head of index - copying...
<tr><td>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</td><td><a href="/programs/program1.txt" target="_blank">program1.txt</a></td><td>491</td><td># Short, clear description of the program.</td><td><a href=/load.html?prog_name=program1.txt>load</a></td><td><a href=/delete.html?prog_name=program1.txt>delete</a></td></tr>
<tr><td>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</td><td><a href="/programs/program2.txt" target="_blank">program2.txt</a></td><td>143</td><td># Second program short description</td><td><a href=/load.html?prog_name=program2.txt>load</a></td><td><a href=/delete.html?prog_name=program2.txt>delete</a></td></tr>
<tr><td>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</td><td><a href="/programs/test_lowtemp.txt" target="_blank">test_lowtemp.txt</a></td><td>304</td><td># Program to test low temperatures</td><td><a href=/load.html?prog_name=test_lowtemp.txt>load</a></td><td><a href=/delete.html?prog_name=test_lowtemp.txt>delete</a></td></tr>
<tr><td>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</td><td><a href="/programs/test_up_down.txt" target="_blank">test_up_down.txt</a></td><td>270</td><td># Program to test up and down temp. change</td><td><a href=/load.html?prog_name=test_up_down.txt>load</a></td><td><a href=/delete.html?prog_name=test_up_down.txt>delete</a></td></tr>
<tr><td>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</td><td><a href="/programs/vfail1.txt" target="_blank">vfail1.txt</a></td><td>246</td><td># Short description of fail1</td><td><a href=/load.html?prog_name=vfail1.txt>load</a></td><td><a href=/delete.html?prog_name=vfail1.txt>delete</a></td></tr>
<tr><td>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</td><td><a href="/programs/vfail2.txt" target="_blank">vfail2.txt</a></td><td>233</td><td># Short description of fail2</td><td><a href=/load.html?prog_name=vfail2.txt>load</a></td><td><a href=/delete.html?prog_name=vfail2.txt>delete</a></td></tr>
[HTTP] End of index - copying...
[LOG] Loading dir: Loading logs directory...
[LOG] Loading dir:	counted 1 files
[LOG] Loading dir: Loading logs directory...
[LOG] Loading dir:	counted 1 files
[HTTP] Head of logs - copying...
[HTTP] End of log index - copying...
[ADDONS] Temperature sensor A readout: Internal temp = 20.7 	 Last temp = 22.8 	 Average kiln temp = 20.3
[ADDONS] Temperature sensor A readout: Internal temp = 21.0 	 Last temp = 22.8 	 Average kiln temp = 20.5
[ADDONS] Temperature sensor A readout: Internal temp = 21.1 	 Last temp = 22.8 	 Average kiln temp = 20.7
[ADDONS] Temperature sensor B readout: Internal temp = 21.2 	 Last temp = 22.5 	 Average case temp = 20.5
[ADDONS] Temperature sensor A readout: Internal temp = 21.2 	 Last temp = 22.8 	 Average kiln temp = 20.9
[ADDONS] Temperature sensor A readout: Internal temp = 21.3 	 Last temp = 22.8 	 Average kiln temp = 21.1
[ADDONS] Temperature sensor A readout: Internal temp = 21.3 	 Last temp = 22.8 	 Average kiln temp = 21.3
[ADDONS] Temperature sensor A readout: Internal temp = 21.3 	 Last temp = 22.8 	 Average kiln temp = 21.4
[ADDONS] Temperature sensor A readout: Internal temp = 21.3 	 Last temp = 22.8 	 Average kiln temp = 21.6
[ADDONS] Temperature sensor A readout: Internal temp = 21.3 	 Last temp = 22.8 	 Average kiln temp = 21.7
[ADDONS] Temperature sensor A readout: Internal temp = 21.3 	 Last temp = 22.8 	 Average kiln temp = 21.8
[ADDONS] Temperature sensor A readout: Internal temp = 21.3 	 Last temp = 22.8 	 Average kiln temp = 21.9
[ADDONS] Temperature sensor A readout: Internal temp = 21.3 	 Last temp = 22.8 	 Average kiln temp = 22.0
[ADDONS] Temperature sensor A readout: Internal temp = 21.3 	 Last temp = 22.8 	 Average kiln temp = 22.1
[ADDONS] Temperature sensor A readout: Internal temp = 21.3 	 Last temp = 22.8 	 Average kiln temp = 22.1
[ADDONS] Temperature sensor B readout: Internal temp = 21.2 	 Last temp = 22.5 	 Average case temp = 20.9
[ADDONS] Temperature sensor A readout: Internal temp = 21.3 	 Last temp = 22.8 	 Average kiln temp = 22.2
[ADDONS] Temperature sensor A readout: Internal temp = 21.3 	 Last temp = 22.8 	 Average kiln temp = 22.2
[ADDONS] Temperature sensor A readout: Internal temp = 21.3 	 Last temp = 22.8 	 Average kiln temp = 22.3
[ADDONS] Temperature sensor A readout: Internal temp = 21.3 	 Last temp = 22.8 	 Average kiln temp = 22.3
[ADDONS] Temperature sensor A readout: Internal temp = 21.3 	 Last temp = 22.8 	 Average kiln temp = 22.4
[ADDONS] Temperature sensor A readout: Internal temp = 21.3 	 Last temp = 22.8 	 Average kiln temp = 22.4
[ADDONS] Temperature sensor A readout: Internal temp = 21.3 	 Last temp = 22.8 	 Average kiln temp = 22.4
[ADDONS] Temperature sensor A readout: Internal temp = 21.3 	 Last temp = 22.8 	 Average kiln temp = 22.5
[ADDONS] Temperature sensor A readout: Internal temp = 21.3 	 Last temp = 22.8 	 Average kiln temp = 22.5
[ADDONS] Temperature sensor A readout: Internal temp = 21.3 	 Last temp = 22.8 	 Average kiln temp = 22.5
[ADDONS] Temperature sensor A readout: Internal temp = 21.3 	 Last temp = 22.8 	 Average kiln temp = 22.6
[ADDONS] Temperature sensor B readout: Internal temp = 21.2 	 Last temp = 22.5 	 Average case temp = 21.2
[ADDONS] Temperature sensor A readout: Internal temp = 21.3 	 Last temp = 22.8 	 Average kiln temp = 22.6
[ADDONS] Temperature sensor A readout: Internal temp = 21.3 	 Last temp = 22.8 	 Average kiln temp = 22.6
[ADDONS] Temperature sensor A readout: Internal temp = 21.3 	 Last temp = 23.0 	 Average kiln temp = 22.6
[ADDONS] Temperature sensor A readout: Internal temp = 21.3 	 Last temp = 22.8 	 Average kiln temp = 22.6
[ADDONS] Temperature sensor A readout: Internal temp = 21.3 	 Last temp = 22.8 	 Average kiln temp = 22.7
[ADDONS] Temperature sensor A readout: Internal temp = 21.3 	 Last temp = 22.8 	 Average kiln temp = 22.7
[ADDONS] Temperature sensor A readout: Internal temp = 21.3 	 Last temp = 22.8 	 Average kiln temp = 22.7
[ADDONS] Temperature sensor A readout: Internal temp = 21.3 	 Last temp = 22.8 	 Average kiln temp = 22.7
[ADDONS] Temperature sensor A readout: Internal temp = 21.3 	 Last temp = 22.8 	 Average kiln temp = 22.7
[ADDONS] Temperature sensor A readout: Internal temp = 21.3 	 Last temp = 22.8 	 Average kiln temp = 22.7
[ADDONS] Temperature sensor A readout: Internal temp = 21.3 	 Last temp = 22.8 	 Average kiln temp = 22.7
[ADDONS] Temperature sensor B readout: Internal temp = 21.2 	 Last temp = 22.5 	 Average case temp = 21.5
[ADDONS] Temperature sensor A readout: Internal temp = 21.3 	 Last temp = 22.8 	 Average kiln temp = 22.7
[ADDONS] Temperature sensor A readout: Internal temp = 21.3 	 Last temp = 22.8 	 Average kiln temp = 22.7
[ADDONS] Temperature sensor A readout: Internal temp = 21.3 	 Last temp = 22.8 	 Average kiln temp = 22.7
[ADDONS] Temperature sensor A readout: Internal temp = 21.3 	 Last temp = 22.8 	 Average kiln temp = 22.7
[ADDONS] Temperature sensor A readout: Internal temp = 21.3 	 Last temp = 22.8 	 Average kiln temp = 22.7
[ADDONS] Temperature sensor A readout: Internal temp = 21.3 	 Last temp = 22.8 	 Average kiln temp = 22.7
[ADDONS] Temperature sensor A readout: Internal temp = 21.3 	 Last temp = 22.8 	 Average kiln temp = 22.7
[ADDONS] Temperature sensor A readout: Internal temp = 21.3 	 Last temp = 22.8 	 Average kiln temp = 22.7
[ADDONS] Temperature sensor A readout: Internal temp = 21.3 	 Last temp = 22.8 	 Average kiln temp = 22.7
E (18739) task_wdt: Task watchdog got triggered. The following tasks/users did not reset the watchdog in time:
E (18739) task_wdt:  - IDLE0 (CPU 0)
E (18739) task_wdt: Tasks currently running:
E (18739) task_wdt: CPU 0: Input_loop
E (18739) task_wdt: CPU 1: loopTask
E (18739) task_wdt: Aborting.
E (18739) task_wdt: Print CPU 0 (current core) backtrace

Backtrace: 0x4009110c:0x3ffb4d30 0x400ed3f3:0x3ffb4d50 0x400dc000:0x3ffb4d70 0x40090c52:0x3ffb4d90
```

I'll try disabling the WDT, but that's not a great permanent solution.

Thanks!

~ D

terrin2k, 2024-12-21:
Success!

In PIDkiln_input.ino, in Input_Loop(), I had to replace the call to yield() with vTaskDelay(1)... and now it all works!

Tomorrow afternoon, I'm going to start wiring this thing to the kiln and give it a go. :)

Thanks for everything!

~ D

terrin2k, 2024-12-21:
I'm marking this as closed.

Closed 2024-12-21.

Thread 50 (2025-01-05):

Rebooting when trying to connect to WiFi

jvswan, 2025-01-05:
First, THANKS for this project! I'm setting it up for my daughter who acquired an old kiln with a non-working kiln sitter. We're excited to get it up and going!

The issue I'm having is that after installing PIDKiln on my ESP 32 WROOM, the system starts with the v1.5 splash screen and a brief message that says "starting..." After about a second it says "connecting WiFi..." Then, a second later the screen flashes and it goes back to "starting..." followed by "connecting WiFi..." I deleted my SSID and password from the pidkiln.conf file and changed the WiFi_Mode to 3, but it still goes through the same sequence.

Differences in hardware include using the ESP32 WROOM board, a project breakout board, and I use two SSRs and two EMRs (I'm controlling 240v, so I have a relay for each leg of power). Otherwise, I followed the hardware setup as shown in the Wiki.

Any suggestions?

Thanks!

Saur0o0n, 2025-01-10:
Hi,
Like I wrote in the readme, I've just made 1.5 to compile with current esp framework, it's not very well tested yet (use release 1.3 - that one works definitely - but requires older esp ide). What does the serial output says? Does it produce any "guru meditation" dump?

jvswan, 2025-01-19:
Thank you! I hadn't picked up on the issue with v1.5. I rolled back to v1.3 and ESP v2.0.14 and got it working after fixing a few Asyncwebparameter calls. Unfortunately, I don't know what the serial output was. :-(. I'm not an Arduino power user... I'm not sure how to access logs on the board yet.

Again, thank you for getting me past the restart loop issue! Now I need to figure out why the web interface tells me "File not found" when I load the index.html page on 192.168.10.1. Ugh... It's always something!

Saur0o0n, 2025-01-24:
Hi, I'm not saying this is the case (but esp framework had done few braking changes in the past - so I wouldn't be surprised) - but perhaps try ESP closer to  2.0.4 or something (I remember this was the version the tests where done).
I'll find the time to check the code with recent update I've made - but not yet :)

jvswan, 2025-03-09:
Thanks @Saur0o0n for your help. I've learned a few things... PIDKiln v1.3 installed ok. I went and installed older commits for the ESP32 framework and all the libraries. I downloaded commits that were current in January, 2022. That seemed to get all the pieces right, so the software started up ok. However, I ran into the restarting loop again once I got the data files uploaded. It took me a while to track down where the issue is.

First, I found that the ESP32 Sketch Data Upload tool only works with Arduino IDE 1.x.x. I was using the most recent 2.x.x version... Once I installed the older IDE, I was able to upload the data files and didn't get the "File not found" error.

Unfortunately, when I uploaded the data files the restart loop started up again. After flashing and uploading data files one at a time I discovered that the program files in the "programs" folder cause PIDKiln to go wonky. When I upload a program .txt file in the programs folder and restart PIDKiln, I cannot get the web pages to load and the LCD display shows PIDKiln is in a restart loop (keeps restarting over and over). This happens when I upload via the Sketch Data Upload tool in the IDE and also when I upload a program file in the WWW interface. I was using the test programs provided with the package, though. I haven't yet tried to upload a custom program yet, but I doubt it will behave differently. Those files are pretty simple.

Any suggestions? I can't test the relays until I can get a program file loaded. I'm sure it is something simple... Any help you can provide would be greatly appreciated!

jvswan, 2025-03-09:
BTW, here are the versions I'm using, in case it helps:

- PIDKiln v1.3
- Arduino ESP32 v2.0.2
- ESP32FS Plugin v1.0
- PID v1.2.1
- ESPAsyncWebServer v1.2.3
- AsyncTCP v1.2.2
- Syslog 2.0.0
- Max31855 v1.2.2
- U8G2 v2.35.30 (I didn't think it would matter if this library was newer than PIDKiln)

Saur0o0n, 2025-03-10:
Hi, so first of all you should get some serial debug output - it very verbose and there should be some feedback where (and probably why) it fails. Also if crushed, you will get memory/calls map to debug exactly where it failes.

Currently the SPIFFS is consider deprecated, so there will be no tools to upload it with Arduino (I guess) - you can still use command lines. Rewrite to LitteFS would require much testing, since there is quite a lot of quirks in PidKiln to overcome some SPIFFS issues.
Perhaps the best way to start would be to install binaries I provided (see wiki) but they are compiled for Wrover as I remember (not Wroom).

jvswan, 2025-03-12:
Thank you for the info. I’m not sure how to get serial debug feedback. Do I need to turn debugging back on in the sketch? Where would I find the debugging log? I’m sure it is in the documentation somewhere. I’ll find it…

The version of the IDE I’m using will load the files in the data folder. I have it set to flash the chip before every upload, so I don’t have old versions of files hiding in there. I don’t need to use the command line to load anything, thankfully, unless I’m misunderstanding something.

Currently everything in the data folder is loaded except the program files because those for some reason cause the restart loop. I’m sure it isn’t the files specifically, but there is something that happens around the time PIDKiln wants to connect to WiFi that a restart is triggered, but only when there’s a program file in the programs folder. If the folder is empty, no restart.

So, regarding the binaries, are you suggesting I reset the ESP32 board and reinstall using the binaries instead of using the IDE? I’ll give it a shot.

First I’ll see if I can learn more about debugging and post a log with the restart failure going on.

jvswan, 2025-03-17:
@Saur0o0n Thanks for helping me with this project. I'm not sure why I cannot seem to make progress on this issue. I have not been able to retrieve any logs. I have serial console output set to "yes" but when I go to the server IP using the indicated port (192.168.1.2:514) I get a blank "About" page. I'm at my wit's end with this. Any other suggestions for getting log data?

I wasn't able to use the binary to install PIDKiln because I couldn't figure out how to get the OTA to work. I tried uploading the files after adding my wifi info to OTA_Install.ino, but after the card reboots there is no pidkilin_AP network to join. I'm sure I'm doing something wrong, but I can't figure out what to do from the wiki page.

Any additional info would be great. I'm completely stumped. About to find a C++ programmer at work and pay them to go through the code and explain to me what's going on.

Thread 51 (2025-01-25):

User abort 16 seconds after program start

terrin2k, 2025-01-25:
This is most likely user error, but any time I start a program, the EMRs energize, but not the SSRs, the the program spontaneously aborts after just a few seconds.

I've verified that there is no voltage on pins 19 and 22 when the program is running.

I do not have the kiln heater coils connected to the SSRs while I'm testing things out.

Here's one example of the log output:

Program name: test_up_down.txt
Program desc: Program to test up and down temp. change
Started at: 2025-01-25 15:30:39
Possible end at: 2025-01-25 15:50:39
PID values. Kp:20.00 Ki:0.20 Kd:0.10
Start temperature: 14.5C
CSV filename: 2025-01-25 15:50:39
-=-=-= Starting program =-=-=-=-
Program ended at: 2025-01-25 15:30:55
End temperature: 14.5C
Program aborted with error: 9

Any idea what I might be doing wrong?

Thanks!

~ D

Saur0o0n, 2025-01-25:
Hi, you have information in log - error 9.

/*
**  Program errors:
*/
typedef enum {
  PR_ERR_FILE_LOAD,       // failed to load file
  PR_ERR_TOO_LONG_LINE,   // program line too long (there is error probably in the line - it should be max. 1111:1111:1111 - so 14 chars, if there where more PIDKiln will throw error without checking why
  PR_ERR_BAD_CHAR,        // not allowed character in program (only allowed characters are numbers and separator ":")
  PR_ERR_TOO_HOT,         // exceeded max temperature defined in MAX_Temp
  PR_ERR_TOO_COLD,        // temperature redout below MIN_Temp
  PR_ERR_TOO_HOT_HOUSING, // housing temperature exceeded
  PR_ERR_MAX31A_NC,       // MAX31855 A not connected
  PR_ERR_MAX31A_INT_ERR,  // failed to read MAX31855 internal temperature on kiln
  PR_ERR_MAX31A_KPROBE,   // failed to read K-probe temperature on kiln
  PR_ERR_MAX31B_NC,       // MAX31855 B not connected
  PR_ERR_MAX31B_INT_ERR,  // failed to read MAX31855 internal temperature on case
  PR_ERR_MAX31B_KPROBE,   // failed to read K-probe temperature on case
  PR_ERR_USER_ABORT,      // user aborted
  PR_ERR_end
} PROGRAM_ERROR_STATE;

terrin2k, 2025-01-25:
I must have miscounted. I thought error 9 was "user abort". :)

Thanks!

~ D

terrin2k, 2025-02-02:
Replaced the case thermocouple and it is much happier now! Thanks!

Closed 2025-02-02.

Thread 52 (2025-02-03):

EMRs activate but SSRs do not

terrin2k, 2025-02-03:
I have two SSRs. One is connected to pin 19 and the other to pin 22, per the instructions. I've verified that there are no bad connections. When the program starts, the EMRs click on (and LEDs on the EMR boards illuminate). However, the voltage at pins 19 and 22 stays at zero and so the SSRs never activate.

Any idea what boneheaded mistake I've made this time? :)

Regards,

~ D

terrin2k, 2025-02-23:
Circling back to this. Sorry for the delay.. been dealing with illness here.

Anyway, I made a simple program to set up and drive pins 19 and 22 high and it works. Both my SSRs energize when I run this program.

When I run PIDKiln and start a program to heat the kiln, it energizes the EMRs but not the SSRs. Here's my current configuration.. perhaps I have something wrong here?

Thanks for your help and an excellent program!

~ D

WiFi_SSID = xxxx
WiFi_Password = xxxx
WiFi_Mode = 1
WiFi_Retry_cnt = 9
HTTP_Local_JS = 1
Auth_Username = admin
Auth_Password = xxxxxx
NTP_Server1 = 0.pl.pool.ntp.org
NTP_Server2 = 1.pl.pool.ntp.org
NTP_Server3 = 2.pl.pool.ntp.org
GMT_Offset_sec = -21600
Daylight_Offset_sec = 3600
Initial_Date = 2024-01-01
Initial_Time = 11:00:00
PID_Window = 5000
PID_Kp = 20.00
PID_Ki = 0.20
PID_Kd = 0.10
PID_POE = 0
PID_Temp_Threshold = 5   <-- I've tried experimenting with this with no luck so far.
LOG_Window = 30
LOG_Files_Limit = 40
MIN_Temperature = 0
MAX_Temperature = 1350
MAX_Housing_Temperature = 130
Thermal_Runaway = 0
Alarm_Timeout = 5
MAX31855_Error_Grace_Count = 10
DBG_Serial = 1
DBG_Syslog = 0
DBG_Syslog_Srv = 192.168.1.2
DBG_Syslog_Port = 514

Saur0o0n, 2025-03-10:
Hi,
Please take a look at serial debug output - perhaps it doesn't think it's require to start heating. The EMR relay is started with program start, SSRs are started only when heating is required.

terrin2k, 2025-04-26:
I finally got back around to trying to get this to work.

A couple of updates:
* I constructed a transistor stage to ensure my GPIO can drive the SSR inputs. I've tested this and it works great.
* I rebuilt the code with debugging enabled and captured the attached output while loading and running the Slow Cone 04 program from another user on this message board.

Can you make heads or tails of it?

Best regards,

~ D

[pidkiln-debug.txt](https://github.com/user-attachments/files/19924926/pidkiln-debug.txt)

Saur0o0n, 2025-04-26:
Hi,
So there is few things strange/wrong. Easy one is the threshold window - you have a lot of messages like:
```
[PRG] Temperature in TEMP_THRESHOLD. Kiln_temp:21.4 Set_temp:26.5 Window:5
```
So if current temp is not more different from set_temp then threshold window - do nothing. So it will do nothing.

Another thing. It will only enable heating (ssr) if this part is true
```
if (pid_out*PID_WINDOW_DIVIDER > now - windowStartTime) Enable_SSR();
```
In logs you can read those values here:
```
[PRG] Pid_out RAW:58.46 Pid_out:58.46 Now-window:-3343913 WindowSize:5000 Prg_state:6
```
Here pid_out - is the same as "pid_out*PID_WINDOW_DIVIDER" - and "Now-window" from logs is the "now - windowStartTime".
So if "now-window" is negative - it should trigger heating all the time because 58.46>-3343913

So I would assume there is something wrong with your physical connection on the board if the SSR is not enabled.
There is no any debug in enable_ssr function, but you can add it for your purpose in PIDKiln_addons.ino here

```
// Simple functions to enable/disable SSR - for clarity, everything is separate
//
void Enable_SSR(){
  if(!SSR_On){
    digitalWrite(SSR1_RELAY_PIN, HIGH);
    DBG dbgLog(LOG_ERR,"[ADDONS] Enabling SSR1\n");
#ifdef SSR2_RELAY_PIN
    digitalWrite(SSR2_RELAY_PIN, HIGH);
    DBG dbgLog(LOG_ERR,"[ADDONS] Enabling SSR2\n");
#endif
    SSR_On=true;
  }
}
```

Thread 53 (2025-04-17):

How do you upload the filesystem when ESP32FS does not support current versions of the arduino IDE?

digiexchris, 2025-04-17:
I haven't been able to successfully compile PIDKiln with the legacy IDE, but I can compile and upload with the current 2.x version of the arduino ide. Could you please help find a way to upload the filesystem with the newer version?

Saur0o0n, 2025-04-19:
Hi,
You should be able to do this with cli tool mkspiffs - haven't tested it. The quick guide is here - https://coolplaydev.com/esp32-spiffs-file-uploads-without-arduino-ide. Please report back if you manage to use it - it may be useful for other too.

digiexchris, 2025-04-22:
hey thanks for this, I was able to do it this way
./mkspiffs -c /path/to/PIDKiln/data -b 4096 -p 256 -s 0x160000  spiffs.bin
esptool.py  --chip esp32 write_flash -z 0x290000 spiffs.bin

I have the esp32 toolchain setup for espidf work for another project, so esptool.py was available through that, though I'm pretty sure the arduino esp32 board libraries include it. I needed to build mkspiffs myself, but I suspect there are versions available to download out there

Thread 54 (2025-06-20):

Question - not an issue

TinMaan, 2025-06-20:
Thank you for sharing this extensive work.
I am making my way through the steps of this wonderful setup. I am just an ol'-timer potter trying to replace a dead ceramic kiln-controller ( I never liked ). So, sorry for the beginner question:
In the [ data/etc/pidkiln.conf ] there are a couple of settings that I'm not quite sure how to handle. Under # Web authentication the Auth_Username = admin, and Auth_password = hotashell are already entered.
Should I leave those settings as default?

Saur0o0n, 2025-06-20:
Hi,
It's just a user/password to login over web UI - you can leave it as it is, or change to your likening.
