Saur0o0n/PIDKiln/(commit log)

2019-08-24 Ported everything to ESP32
2019-08-25 Add rotary encoder functions, updated doc with pin setup
2019-08-25 PIN changes
2019-08-29 Exteded program loading, error reporting, readme
    [PIDKiln.h, PIDKiln.ino, PIDKiln_LCD.ino, PIDKiln_program.ino]
2019-08-30 More LCD/Program fixes end upgrades - mostly program show functionality
    [PIDKiln.h, PIDKiln.ino, PIDKiln_LCD.ino, PIDKiln_input.ino]
2019-08-30 Some LCD cleanups, fixes
    [PIDKiln.h, PIDKiln_LCD.ino]
2019-09-02 Separated network module, add RTC clock and NTP synchronization, introduced interrupts timer for periodic refresh (currently main screen)
2019-09-04 Programmed web temperature chart, lots of other changes
    [test.csv]
2019-09-07 Finished prefs subroutines, add LCD "Show preferences, created editable preferences WWW page (no save yet). Reworked CSS and cleaned up html
    [PIDKiln.h, PIDKiln.ino, PIDKiln_LCD.ino, PIDKiln_http.ino, PIDKiln_input.ino, PIDKiln_prefs.ino, PIDKiln_program.ino]
2019-09-08 Extended preferences, introduced preference writing to disk, add variouse time/date fixes/upgrades
    [PIDKiln.h, PIDKiln.ino, PIDKiln_LCD.ino, PIDKiln_http.ino, PIDKiln_net.ino, PIDKiln_prefs.ino, PIDKiln_program.ino]
2019-09-08 Small data update (months are 0-11???) and LCD cleanup + documentation
    [test.csv]
2019-09-08 Updated LCD sample
2019-09-09 Added PID library and MAX31855 library + initialization and basic routines
2019-09-17 Implemented MAX31855 (library required) - lot's of changes, defined relays pins, updated manual
2019-09-17 Temperature cleanups - separate ino file for MAX31855 and relays, README update
2019-09-19 Mainly fixes, added SSR relay functions, updated README
    [PIDKiln.h, PIDKiln.ino, PIDKiln_LCD.ino, PIDKiln_addons.ino, PIDKiln_input.ino, PIDKiln_prefs.ino, PIDKiln_program.ino]
2019-09-22 A looot of changes underneath, mostly in LCD handling. Added third Main View screen with program run/pause/stop/abort. Fixes in quick program edit.
    [PIDKiln.h, PIDKiln_LCD.ino, PIDKiln_input.ino, PIDKiln_program.ino]
2019-09-22 Updated README - fixed LCD HW SPI by reducing clock by 5%
2019-09-24 Multiple PID enhancment, add program running routines, quick logging capabilities (not target one yet). Generally device is fully functional now. Added missing PID preference fields and handlers
    [test.csv]
2019-09-24 Version 0.7 - fully functional release. Changes in program handling, PID preferences, LCD changes
2019-09-29 A lot of changes on WWW side, online program refresh, graph refresh, json output (kind of api) of current program run, added localy jquery and charts - assuming no Internet access on kiln location
    [PIDKiln_vars.json]
2019-09-30 Large WWW/JS update - program WWW main screen is finished, updated missing prefereces values, made proper logging, lowe level ESP task handling changes
    [PIDKiln_vars.json, test.csv]
2019-10-02 Added second thermocouple (housing), extended loging and charts with housing temperature. Aditional safatey prefs and routines
2019-10-02 New Logs screen, to browser logs and CSV - all needed code 4 that. A lot of cleanup for debug and just code - as we are getting close to final release :)
    [test.csv]
2019-10-03 Created connection schema in "Arduino" style for PIDKiln
2019-10-03 Renamed wiring image
2019-10-04 Updates in pinout schema, split index.html in local and remote file (see WiKi - bugs), added /screenshot.html for creating LCD screenshots
    [PIDKiln.h, PIDKiln.ino, PIDKiln_LCD.ino, PIDKiln_http.ino, PIDKiln_input.ino, PIDKiln_logs.ino, PIDKiln_program.ino]
2019-10-07 Cleanups, some additional changes for power meter, updated documentation
2019-10-11 Updated power meter information, added thingiverse case for PIDKiln
2019-10-13 Updated error handling on ABORT_Program - error is propagated now with the program and to the logs, changed power meter approach (it's going to be separate thread to measure it)
    [PIDKiln.h, PIDKiln.ino, PIDKiln_addons.ino, PIDKiln_http.ino, PIDKiln_logs.ino, PIDKiln_program.ino]
2019-10-15 Updated prefs description, added power consumtion reporting to logs (how much program used) and csv
2019-10-16 Updated diagram with 5V switch
2019-10-17 Chart with power meter fixes
    [PIDKiln_addons.ino, PIDKiln_logs.ino]
2019-10-21 Add second SSR for additional heater on pin 22
2019-10-26 Updated loging and introduced PID window divider - for faster responsivnes (look pid doc)
2019-10-26 New PID testing results, new PID divider, reversed LOG sorting + configurable LOG files number limit
    [PID_Testing_Results.ods]
2019-10-26 Old logs autoerasing, WiFi mode configuration fixes, additional PID screenshots
    [PID_Testing_Results.ods, test.csv]
2019-10-27 Updated PID testings
    [PID_Testing_Results.ods]
2020-01-15 Updated MAX31855 library in my repo, it was not synced after some extensions and GIT version did not allowed for proper PIDKiln compliation). Added MAC information to LCD Info screen (if you have MAC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
2020-01-15 Removed fontawesome (replaced with images), fixed alarm (pin 26) - was not tested and had some not finished procedures, fixed/enhanced abort/error logging into .log file
    [PIDKiln.h, PIDKiln_addons.ino, PIDKiln_logs.ino, PIDKiln_program.ino]
2020-02-22 Fixed non reporting of disconneted MAX sensors, updated temperature readout handling, add syslog and monitoring settings to preferences
    [PIDKiln.h, PIDKiln_addons.ino, PIDKiln_http.ino, PIDKiln_logs.ino, PIDKiln_net.ino, PIDKiln_prefs.ino, PIDKiln_program.ino]
2020-03-19 Extended error reporting for thermocouples and MAX devices. Updated diagram to include additional capacitor
    [PIDKiln.h, PIDKiln_addons.ino]
2021-03-22 Add thermocouple error grace count - not tested!
    [PIDKiln.h, PIDKiln_addons.ino, PIDKiln_http.ino, PIDKiln_prefs.ino, PIDKiln_program.ino]
2021-03-24 Splitted thermocouple error count to tempA and tempB, and addeded "autorecovery" for those errors
    [PIDKiln.h, PIDKiln_addons.ino, PIDKiln_program.ino]
2021-05-05 Updated NTP procedure, to probably fix negative GMT offsets (issue #7)
    [PIDKiln.h, PIDKiln_net.ino]
2021-12-02 Added support from Wroom, fixed stack overflow, updated SPIFFS to work with ESP32 2.0+
    [PIDKiln.h, PIDKiln.ino, PIDKiln_LCD.ino, PIDKiln_addons.ino, PIDKiln_http.ino, PIDKiln_input.ino, PIDKiln_logs.ino, PIDKiln_net.ino]
2021-12-03 Fixed all C++ warrnings, code cleanup
    [PIDKiln.h, PIDKiln.ino, PIDKiln_LCD.ino, PIDKiln_addons.ino, PIDKiln_net.ino]
2021-12-03 Updated binary OTA files, fixed button CSS issue/look
2022-01-28 Fixed more issues with recent FS/SPIFFS changes in ESP 2.0.x Arduino framework and Chart version urls (fixes issues#11), some more malloc()/free() cleanups
    [PIDKiln.h, PIDKiln.ino, PIDKiln_http.ino, PIDKiln_input.ino, PIDKiln_logs.ino, PIDKiln_prefs.ino, PIDKiln_program.ino]
2022-01-28 Fixed grave error introduced in PIDKiln v1.2 where main program loop where moved from priority 1 to tskIDLE_PRIORITY - this made whole loop executed in random behaviour
    [PIDKiln.ino, PIDKiln_http.ino, PIDKiln_input.ino, PIDKiln_net.ino, PIDKiln_program.ino]
2022-01-28 Add new information on debug screen, fixed MAC address display (it was reversed), add some task scheduling changes
    [PIDKiln.h, PIDKiln_LCD.ino, PIDKiln_http.ino, PIDKiln_logs.ino, PIDKiln_program.ino]
2022-01-28 Fixed html language and encoding definition, add 404 error handling for web server
    [PIDKiln_http.ino, PIDKiln_program.ino]
2022-05-31 Fixed max housing temperature error check
    [PIDKiln.h, PIDKiln_http.ino, PIDKiln_prefs.ino, PIDKiln_program.ino]
